calo-lategan/Staircase/v2/revc/review/consistency.md

# Rev C web set: consistency and fact-check audit

Read-only audit, 26 Sep 2026. No page or script was changed.

Pages checked: `v2/revc/web/{datasheet,verdict,changelist,manufacturing}.html`. The HTML was stripped to text with python, and SVG `aria-label`s, `alt` text and `href`s were checked separately.
Sources checked against: `v2/final/final_results.json` (and `pole_options_final.json`, `frame_sls_final.json`, `barrier_path_check.json`, `tread_box2.json`, `tread_grating.json`), `v2/revc/after_changes.json` (+ `after_changes.py`), `frame_after.json` (+ `.py`), `pole_fixing.json` (+ `.py`), the `build_*_revc.py` scripts, and `v2/spec/sheet_2026-09-23_events.txt`.

**R-number convention.** Every R-number on the pages is *file line − 1* of `sheet_2026-09-23_events.txt`. For example, R7 is line 8, "Gap between steps (open riser)", and R113 is line 114, "Area load 5.0–7.5 kN/m²". I checked all 30 R-numbers used on the pages. Each one points at a row about the stated topic. A few are loose fits, listed below. None is outright wrong.

Severity: **critical** means Gerald would draw something wrong or unsafe. **Major** means a contradiction, or text he cannot draw from. **Minor** means a rounding, wording or traceability problem.

---

## A. Critical

| # | Page + quote | Problem | Evidence | Suggested exact replacement text |
|---|---|---|---|---|
| A1 | changelist F5: "One tube from support to support … a 48.3 × 4 aluminium scaffold tube"; verdict: "Top landing bracket … no change 0.38"; manufacturing: "Top landing brackets, top rails and handrails are unchanged in both routes." | The axle grows from Ø25 to Ø48.3 at both ends, but no page says the hook bore, the jack heads or the top landing brackets must change to take the bigger tube. As written, the 48.3 tube cannot fit hooks or brackets drawn for Ø25. | datasheet components: "Axles 3 · Tube Ø25 × 2.5"; "Top landing brackets 137/140 × 5 plates, Ø20 pin"; `after_changes.py` checks the top axle as 48.3 × 4 on a 70 mm lever | F5 "Change to", add: "Open every hook to suit the Ø48.3 tube (bore Ø49–50) and keep the ring width below. Redraw the top landing brackets and jack heads to seat a Ø48.3 tube." In verdict/manufacturing, replace "no change"/"unchanged" for the landing bracket with "re-seated for the Ø48.3 axle (pin Ø20 and 5 mm plate unchanged)". |
| A2 | changelist F5: "Base hook plates with at least 39 mm of plate round the axle (57.5 if the jacks will be clamped to a scaffold)"; "Jacks on the ground: M24 jacks and the drawn footplates are fine." | "Already decided" says "Jacks stand on the ground or on a scaffold", so the unit must meet the clamped case. The conditional sizes leave Gerald to choose, and one branch keeps 100 × 100 × 5 footplates, which fail R73 (150 × 150 minimum). The top-hook ring for the clamped case (40 mm) is missing from F5 altogether. | datasheet R73 row "100 × 100 × 5 … Fail"; verdict R73 "150 × 150 × 8 … 0.89"; `final_results.sizes.hooks` "≥ 57.5 mm at the base, ≥ 40.0 mm at the top" | "Base hook plates with at least 57.5 mm of plate round the axle; top hook plates at least 40 mm. Base jacks M30 on 150 × 150 × 8 footplates, with a fixing for 10.9 kN sideways." Delete "Jacks on the ground: M24 jacks and the drawn footplates are fine." |
| A3 | changelist F8: "Bent flats 15 wide, about 5 thick … 25 wide at the same thickness (0.90)" | The thickness is given three ways: "about 5" (F8), "≈ 4.5" (datasheet components), and "the thinner 4.2 mm measured gives about 3.0" (datasheet). At 4.2 mm the 25-wide bracket comes out ≈ 1.28, a fail. "Same thickness" is therefore unsafe wording. | `final_results.components` "bracket thickness 5 mm assumed"; 0.90 × (5/4.2)² = 1.28 | "Change to: 25 × 5 flat (5 mm thick minimum, not the 4.2 mm now measured), same 57 mm offset and fixing points (0.90)." |
| A4 | changelist F4 / manufacturing Poles: pole "stands on the outside face of the rails" … "Its locking tab and pegs (F3) stay part of the same piece"; F3: "locking end, which drops through both rails … pegs … in the rail walls" | Once the pole is outside the rails, the text never says how the locking tab reaches both rails or where the rail-wall notches are. Gerald cannot draw F3 and F4 together. Route 2 drops F3 because "the F4 fixings do the locking", which suggests F3 may be redundant in Route 1 too. | changelist F3/F4 text; `pole_fixing.py` ("cross-pin … carries the rail-to-rail lock force") | Decide, then state it. If the strap, Ø12 cross-pin and Ø16 pin carry the lock force (per `pole_fixing.json`: 0.18 / 0.65), write: "F3 is replaced by the F4 fixings in both routes: no locking tab or pegs." Otherwise, add a dimensioned sketch of the tab path from the outside face through both rails. |

## B. Major

| # | Page + quote | Problem | Evidence | Suggested exact replacement text |
|---|---|---|---|---|
| B1 | All pages: "about 70 deep"; changelist SVG aria-label: "rail deepened to about 65 mm" | The net-section, edge and lateral rail checks and the rail mass were all computed at **65** deep. Only the frame SLS/frequency run used 70. The change list says "Sizes are final unless marked decide" but gives only "about 70". | `after_changes.py` "rails 65 deep"; `barrier_path_check` "U 35 x 65 x 5 (F2)" → 0.51/0.82; `rails_kg` uses 60 legs + 5 web; `frame_after.py` DEPTH = 70; `final_results.sizes` "needs the 65 mm rails" | Everywhere: "70 deep (outside), 5 mm walls". Add to the verdict note: "Rail strength was checked at 65 deep and sag at 70; 70 is drawn." Fix the aria-label to "about 70 mm". |
| B2 | changelist F2: "Ø20 pins and Ø20 holes"; manufacturing: "reamed to Ø20 H9", "About 0.5 mm clearance per side on pins"; F9: "about 0.5 mm per side on pins and slots" | The hole size contradicts itself: Ø20, Ø20 H9 (a near-zero fit) and Ø21 (0.5 mm per side). The edge check used d0 = 21. | `after_changes.py` edge formula `2*21/3` | F2: "Ø20 pins in Ø21 holes (0.5 mm clearance per side)". Manufacturing: "drilled and reamed to Ø21". |
| B3 | changelist legend: "needed to pass (F1–F5) · smaller or a decision (F6, F8, F9)"; F8 card has no "needed to pass" tag | The brackets fail R143 at 2.51 as drawn, so F8 is needed to pass. | datasheet "Handrail brackets … 2.51 Fail"; verdict R143 "2.51 → 0.90" | "needed to pass (F1–F5, F8) · decision or drawing only (F6, F9)". F8 subtitle: "12 per unit · needed to pass". |
| B4 | changelist: "If the lower-cost build route is chosen … only three cards change"; manufacturing: "tell Gerald: only cards F1, F3 and F4 … change" | Not accurate. Route 2 also changes F2 hardware (stainless Ø20 bar with R-clips, not turned with castle nut and split pin), F5 jacks (M24 on the ground only, not M30) and F5 collars (scaffold clamps). | manufacturing rows Step pins, Base jacks, Axles and collars | "If Route 2 is chosen, F1, F3 and F4 change, plus the F2 pin ends (R-clips) and the F5 collars (scaffold clamps)." |
| B5 | changelist "Already decided": "Poles solid; they are the crowd barrier." · manufacturing Route 2: "rectangular tube 80 × 40 × 3" · datasheet: "A hollow 25 × 85 × 3 does the same job at less than half the mass" | Three pole answers. "Solid" is listed as decided while Route 2 (still open) uses hollow tube. The datasheet recommends a 25 × 85 × 3 RHS that appears nowhere else, and it omits Route 2's 80 × 40 × 3. | pole options table; `after_changes.poles.R2_rhs_80x40x3` 0.76 | Decided list: "Poles are the crowd barrier: solid 25 × 55 (Route 1) or RHS 80 × 40 × 3 (Route 2)." Datasheet: replace the "25 × 85 × 3" sentence and table row with "RHS 80 × 40 × 3 (Route 2): 0.76, 25 kg for 12." |
| B6 | datasheet "Smallest sizes that pass": no handrail-bracket row | The datasheet's list of changes that make it pass omits F8. | changelist F8; verdict R143 | Add row: "Handrail brackets · Bent flat 15 × ≈ 4.5 · 25 × 5 flat, same offset (0.90) · R143" |
| B7 | datasheet: "A solid bar only passes at … 25 × 51 for every barrier load" vs "Smallest that passes: Solid 25 × 55 (0.84)" | The "smallest that passes" is not the smallest (25 × 51 is 0.98). The reason for 55 (margin, or the fixings) is not given. | pole options table 25 × 51 = 0.58/0.80/0.96/0.98 | "Solid 25 × 55 (0.84; 25 × 51 is the bare minimum at 0.98 and is not used)" |
| B8 | changelist F5: "Draw the landing bracket's bolts for 11.3 kN per side"; manufacturing: "The landing fixing (11.3 kN per side) is by others"; datasheet: "It's outside this model" | The pages disagree on whether Gerald draws the landing fixing, and no bolt size is given. | — | Either "Landing fixing: by others, design load 11.3 kN per side (ULS); not drawn" in all pages, or give the bolt spec in F5. |
| B9 | changelist F5: "A collar on the axle each side of every hook"; "a Ø14 pin through the base hook plate under the axle" | Collar size/type, the hook-lock pin position (distance from the axle centre, direction) and the pin length are not given. | — | "Collars: split collar for Ø48.3, 20 wide, 1 × M8. Keeper pin Ø14 through both hook cheeks, centre 32 mm below the axle centre, on the open side." (Numbers to be confirmed by the engineer.) |
| B10 | changelist F4: "tapering to 15 at the top rail"; "5 × 40 strap round the pole, bolted to the rail with 2 × M12, plus a Ø12 cross-pin … at the middle of its 55 depth"; SVG: "pole on the outside face, 2 bolts into each rail" | Missing for drawing: where the taper starts, the pole length, the bolt positions/spacing, the strap bend shape and which parts the cross-pin passes through (the script says both strap legs). The SVG says 2 bolts at *each* rail, but the text says one Ø16 pin at the lower rail. | `pole_fixing.py` comments | Text: "full 55 from the lower rail up to the upper-rail strap, then straight taper to 15 at the top rail". SVG label: "strap + 2 × M12 at the upper rail; one Ø16 pin at the lower rail". |
| B11 | changelist F4: "The middle handrail between two units side by side isn't a barrier … and can stay as it is." | Introduces a side-by-side layout not defined anywhere else. It is unclear whether the 6 poles on that side keep the hollow 25 × 10, which conflicts with "12 per unit". | — | Delete it, or: "All 12 poles change. (Where two units stand side by side, the shared handrail is not a barrier, but the poles still carry the fold lock and must change.)" |
| B12 | changelist F6: "raise the top rail about 87 mm (raise the pole tops or pivot posts)"; "The handrail passes either way (900–1,000)" | (a) +87 mm lengthens the barrier lever from 1,050 to about 1,137 mm. Pole, strap, pin and rail utilisations (0.84/0.17/0.65/0.82) were not re-run for this, though ≈ +8% would still pass. (b) The 900–1,000 range comes from the **ramp** row (sheet line 47, R46), not a stair row. From the step surface the handrail is ≈ 1,002 mm, just above 1,000, so "passes either way" is not supported. | sheet line 47 "Ramp (Pod) … Handrails … 900 mm/1000 mm"; 1,112 − 1,013 = 99 mm offset | (a) Add: "If raised, the pole checks rise about 8% (pole 0.91): still pass." (b) Replace with: "The handrail is 903 above the pitch line; the sheet has no stair-handrail height row (900–1,000 is the ramp row R46)." |
| B13 | changelist F9: "Afterwards: 12 poles, 12 locking ends, 4 hooks, 2 axles." | "12 locking ends" contradicts F3 ("Draw each pole and its locking end as a single part"). "2 axles" implies deleting the unloaded second base axle (x 9,936), which F9 never says to do. | datasheet components "Axles 3"; "second base axle at x 9,936 carries no load" | "Afterwards: 12 poles (each one piece with its locking end), 4 hooks, 2 axles (delete the unused second base axle at x 9,936)." |
| B14 | changelist F2: "Right rails grow downwards; the left channels deepen by the same amount" | Rails start at 25 or 20 deep, so reaching 70 needs different amounts (45/50). The growth direction for the left channels is not stated, and neither is left/right (looking up the stair?). | datasheet components: left U 35 × 25, right lower 25 × 25, right upper 25 × 20 | "All four rails become 70 deep outside. Right rails (inverted U) grow downwards; left rails (U, open at the top) grow downwards. Left/right as seen walking up the stair." |
| B15 | changelist F3: "rail-wall notches widened" and "holes in the rail walls" (same card); datasheet: "J-notches in the rail walls" | Notch or hole matters for drawing, because it decides whether the pole drops in or has to be threaded. | — | Use one term: "J-notches in the rail walls, widened to Ø12 + 1 mm". |
| B16 | datasheet: "Step design · … both with drain holes, FE-verified" | The box A FE (`tread_box2` B4) has no holes: its cfg has no hole data, and the 5.9 kg mass is solid plate. The C grating FE (G5) has no cross bars, so its 6.2 kg excludes ≈ 1.4 kg of 3 × 25 cross bars at 50 mm. The hole rule in F1 ("up to about a fifth of each plate") is unchecked. | `tread_box2.json` cfg; `tread_grating.json` G5 bars list | "FE on the closed box without holes; holes up to 1/5 of each plate are an engineering allowance, to be confirmed. C mass excludes cross bars (+≈ 1.4 kg)." |
| B17 | datasheet row: "Tread pins Ø10 … Shear 11.2 kN / 11.1 kN · 1.00 · 0.78 · **Pass**" | The source says FAIL (11,155 N > 11,121 N, util 1.003). | `final_results.components` "Tread pins O10 … Shear … 1.0 FAIL" | "… 1.00 (1.003) · 0.78 · Fail" |
| B18 | changelist "Already decided": "Hooks cut or bent as part of the rails"; manufacturing: "Hooks cut from the same channel or bolted on as 10 mm plate"; hooks "10 mm plate" everywhere | The rails have 5 mm walls, so a hook "part of the rail" cannot be the 10 mm plate that was checked. Manufacturing also offers "bolted on", which contradicts the decision. | datasheet "Hooks | 4 | 10 mm plate" | "Hooks: 10 mm 6082-T6 plate, bolted to the rail (2 × M12)" (or state the thickness if cut from the channel, and re-check). |
| B19 | manufacturing rule: "6082-T6 for everything structural … The only exception is the Route 2 step (5083-H111)" | The same page specifies stainless step pins (Route 2), "6082-T6 or stainless" pegs, M12 A4-70 bolts and scaffold clamps and jacks (usually steel). | manufacturing rows | "6082-T6 for rails, poles, axles, hooks and brackets. Pins and bolts may be A4 stainless (isolated, see below). Jacks and clamps: standard scaffold items." |
| B20 | changelist decided: "No middle rail, toe board or feet; the scaffold supports the unit." vs "Jacks stand on the ground or on a scaffold." | These contradict each other on what supports the unit. | — | "No middle rail or toe board. The base stands on two screw jacks, on the ground or clamped to a scaffold." |
| B21 | changelist F1/verdict R7: "a 35 mm lip gives the recommended 100" | The arithmetic does not match: 125 − 35 = 90, and 125 − 25 = 100. The datasheet also places the 125 gap "under the back box", while the lip is on the front edge. | datasheet R7 row "125 mm under the back box" | Verify, then: "a lip at least 5 mm down gives 120; 25 mm gives the recommended 100." State which edge the gap is measured under. |
| B22 | changelist F1 and SketchUp notes | R16/R17 are not in the change list. The 55 mm-wide contrasting nosing strip (R17: "55 mm … full width, both edges") and serration on box A are never given to Gerald. The verdict says "Specify". | sheet R17 | F1 add: "Top plate serrated. 55 mm contrasting strip along the full width of the front edge (R16, R17)." |

## C. Minor (rounding, wording, traceability)

| # | Page + quote | Problem | Evidence | Suggested replacement |
|---|---|---|---|---|
| C1 | verdict R115: "Sag under 4 kN ≤ 12.2 mm · 58.3 mm · **4.78**" | Datasheet and JSON give 4.80 (58.34/12.16 = 4.798). | `tread.checks` 4.798 | "4.80" |
| C2 | datasheet tread table: "Grating bar stress · 212 / 224 MPa · 0.94 Pass"; chart: "Grating bars 0.99" | The table util belongs to 212; the peak (224/227) is 0.99. | `tread.checks` 0.988 | "212 / 224 MPa · 0.99 · Pass" |
| C3 | datasheet pole options: "18.57 · 25.39 · 30.41 · 31.02" (RHS), "15.21 … 24.90 25.40", "2.43 … 3.98", "6.76 … 11.07 11.29", "25 × 51 · 0.58" | These differ from the barrier table on the same page (18.60/30.47/30.99) and from `pole_options` (18.6/25.4/30.48/31.01; 15.23/24.95/25.38; 2.44/3.99; 6.77/11.09/11.28) and `barrier_path` (25 × 51 0.59). They are recomputed in `build_datasheet_final.py`. | `final_results.pole_options`, `barrier_path_check.json` | Use the JSON values: 18.60/25.39/30.47/30.99 etc. |
| C4 | verdict R179: "solid 25 × 55 (worst barrier load) 0.84"; R142 3.0 kN/m: "covered by the row above 0.84"; "Closest to the limit … 3.0 kN/m on the top rail 0.84" | 0.84 is the 5.0 kN/m viewing value. For 25 × 55 the R179 value is 0.82 and 3.0 kN/m is 0.50. | `barrier_path.pole["solid 25 x 55"]` | R179 "0.82"; R142 3.0 "0.50"; add row "R142 5.0 kN/m viewing · 0.84". |
| C5 | verdict "R142 Pole fixing, upper rail · strap + 2 × M12 · **0.17**"; manufacturing Route 1 "**0.18**" | Same fixing, two values. 0.17 is bolt tension; 0.18 is the cross-pin double shear (0.184). | `pole_fixing.json` | Both: "0.18 (cross-pin; bolts 0.17)". |
| C6 | verdict R113 steps: "box step, 0.41 of its strength · 0.41" | 0.41 is the box under the 4 kN point load, not the crowd. | `after_changes.steps.A_extruded_6082` (ULS max = 4 kN case) | "box step (governed by 4 kN: 0.41)". |
| C7 | datasheet: "The crowd load carried (≈ 1.1 kN/m²) is set by the pegs" | The rails (6.95, base free) govern, not the pegs (6.62). 7.5/6.95 = 1.08. | datasheet frame table | "… is set by the rails and pegs (6.95 / 6.62)". |
| C8 | datasheet: Ground friction "… 0 · **0.80** · Partly holds" in a utilisation column | 0.80 is the friction coefficient needed; the utilisation is 1.55. | `components` "Base held by friction alone … 0.8 · 0.5 · util 1.55" | "μ needed 0.80 vs ≈ 0.5 (1.55)". |
| C9 | changelist F4: "Under the barrier loads they are 19–30× too weak" | Range is 18.6–31.0. | components | "19–31×" |
| C10 | verdict "Sag under a crowd ≤ 4.9 mm" / datasheet "4.86 mm" | Rounding differs between pages. | — | "≤ 4.86 mm" on both. |
| C11 | changelist F3 SVG: "NOW · 2 mm pegs 2 per rail, 4 per pole" vs summary "2 mm, lower rail only" | The "now" state disagrees. | datasheet "upper pair is missing from the drawing" | SVG: "NOW · 2 mm pegs, lower rail only (upper pair not drawn)". |
| C12 | verdict R174 "Jacks on the ground · M24 · 0.08 → M24 · 0.82" | Reads as the change making things worse. The two numbers are different cases (free vs friction-held). | components vs `after_changes.jacks.m24_ground` | "M24 · 0.08 (base free) / 0.82 (friction-held) → no change". |
| C13 | datasheet/verdict/changelist: "Aug-2026 events sheet" | The source file is `sheet_2026-09-23_events.txt`; "Aug-2026" is only the legend's re-evaluation date. | sheet line 2 | "events sheet (23 Sep 2026)". |
| C14 | R-refs: R150 for hook-plate throat; R147 for axle bending; R174 for jack-rod bending/friction | Loose fits. R150 is "Uplift / anchorage (wind)", R147 is "Column axial load", R174 is "Ground bearing pressure". The ground pressure itself (0.64–3.49 MPa) is never compared with an allowable. | sheet lines 148, 151, 175 | Use "R147 (supports, project statics)" for the hooks too, and add "ground pressure 3.5 MPa peak (R174: check bearing)". |
| C15 | changelist F5 "Sheet rows R147 R150 R73" | R174 (jacks) is missing. | — | "R147 R150 R73 R174" |
| C16 | datasheet / verdict geometry tables | These sheet rows are not addressed: R66 toe board 150 mm, R70 second rail at ~600 mm for public crowds, R19 handrail extension ≥ 300 mm. Only R65/R68 are shown as "by decision". | sheet lines 67, 71, 20 | Add them to the "By others / by decision" row: "R65 R66 R68 R70". |
| C17 | datasheet "Ring ≥ 39 mm at the base on the ground" (also changelist F5) | No JSON source: `sizes.hooks` gives only 57.5/40. The 39 is hard-coded in `build_datasheet_final.py:516`. | — | Cite its source or drop it (see A2). |
| C18 | datasheet "Pure aluminium … would need about 25 × 86"; verdict/manufacturing "the scaffold edge protection covers it" | No source in the JSON. | — | Remove, or cite. |
| C19 | datasheet footer cites `tread_fe_box.py` | The box result used is `tread_box2` (tread_box2.py). `final_results` marks the old box check `tread_box_check_superseded`. | `final_results` keys | "… tread_box2.py (closed box B4) …" |
| C20 | datasheet mass list "Grating bars 360×19.68", "Tread frames 6×16.25" | Reads as 360 × 19.68 kg. The value is the total. | `mass.parts` | "Grating bars (360): 19.68 kg" |
| C21 | Terminology | One part has five names: pole "locking end / locking tab / lock pins / latch"; pegs "cross-pegs / pegs / keeper pins". Steps are "tread" on the datasheet and "step" elsewhere. | — | Use "pole locking end", "pegs", "step" throughout. |

## D. Leftover history / superseded material

| Sev | Page + quote | Problem | Suggested replacement |
|---|---|---|---|
| major | datasheet "Step design · **A** chosen, **C** the alternative"; changelist "A · CHOSEN", "C · ALTERNATIVE" | Letters A/C imply a missing option B (the owner's box B, still in `after_changes.steps.B_owner_*`). This will confuse Gerald. | "Step type 1 (closed box, draw this)" / "Step type 2 (open grating, alternative)". |
| minor | datasheet "Open shapes 25 mm deep don't pass: a cut-out top sheet on the J + L, or a lattice …"; changelist F1 "even as a fine lattice" | Rejected options have no role in a drawing brief. | Keep on the datasheet only as a single line, or delete. |
| minor | datasheet pole-options table (8 rows incl. 25 × 39, 25 × 60 × 3, 25 × 85 × 3) and "Pure aluminium" paragraph | Rejected options are listed next to the chosen one (see B5). | Reduce to: as drawn, Route 1 (25 × 55), Route 2 (80 × 40 × 3). |
| minor | datasheet "checked joined to them, as confirmed", "(confirmed)", "as decided", "the owner confirms 4 pegs" | Decision-history wording. | Plain statements: "The flats are joined to the end plates." |
| minor | verdict "The catwalk and steep states were not re-checked in Rev C." | Mentions configurations Gerald is not drawing. | Keep, but add "(not part of this change list)". |
| — | Checked, **none found** on any page: Rev A/B, 22 Sep model, "earlier", "correction", steel posts, 107 kg, 69.4 kg, SHS 60 × 60, 6 posts, intermediate rails, step option B by name. | Only the one stale "about 65 mm" aria-label (B1). The builders' source (`datasheet/build_datasheet_final.py`) still contains "Rev A (22 Sep)" and "22 Sep model" strings. `build_datasheet_revc.py` removes them by string-replace, so a future edit could let them back in. | — |

## E. Terms Gerald cannot resolve from the text

These are the undefined or inconsistent terms, and where each one is used.

- **pitch line**: defined only in changelist F6. It is undefined on the datasheet and verdict.
- **net W**: datasheet rails. Not defined.
- **HAZ / f₀,haz**: datasheet material box. Not defined.
- **util / Use**: defined on the verdict and manufacturing guide. The datasheet uses "utilisation (demand ÷ resistance)". Acceptable.
- **ULS / SLS**: undefined on the datasheet.
- **T8.8**: datasheet; means EN 1999-1-1 Table 8.8. Cryptic.
- **J-notch**: undefined.
- **pivot posts**: F6. Undefined.
- **back box**: datasheet. Undefined.
- **left/right**: never defined (e.g. "facing up the stair").
- **x/y/z axes**: defined only for the tread.

## F. Links

- `links.json` does not exist in `v2/revc/`, so every cross-page link is the placeholder `#`. There are 19 in total:
  - datasheet: 4 ("change list" in Smallest sizes; footer: load verdict, change list, manufacturing guide)
  - verdict: 5 (hero: change list, manufacturing guide; footer: datasheet, change list, manufacturing guide)
  - changelist: 5 (decided box and Route-2 note: manufacturing guide ×2; footer: datasheet, load verdict, manufacturing guide)
  - manufacturing: 5 (intro: load verdict, change list; footer: datasheet, load verdict, change list)
- **Broken in-page anchor:** changelist summary row F7 links `#f7`, but there is no `id="f7"` card. F7 exists only as a note at the bottom. Either add `id="f7"` to that note or drop the link.
- The in-page anchors `#f1`–`#f6`, `#f8` and `#f9` resolve.
- All 28 `img/` references exist. `img/f9_where.jpg` exists but is not used.

## G. Cross-checks that agree (for the record)

These values match their JSON sources to the stated rounding:

- **Mass:** 61.2 / 88 / 98 kg.
- **Now-state utilisations:** pegs 6.62/4.93, rails 4.88/2.89/4.96/6.95 (free) and 2.72/2.06/2.99/5.16 (held), tread pins 5.30/4.14, axle 2.19/6.04, top axle 1.51/3.85, hook throat 1.22/3.37 and 0.84/2.15, jack 1.71, footplate 2.66, brackets 2.51.
- **Reactions:** 6.4/17.7/11.3/4.4/3.2/10.9 kN.
- **Frame sag and frequency:** frame sag 10.7 vs 7.32 mm; f₁ 9.2–14.8 Hz.
- **After-change utilisations:** pegs 0.58, pins 0.66/0.25, edge 0.87, rails net 0.40 (W 7,200 vs 2,900), lateral 0.51/0.82, pole 0.84 (Route 2 0.76), pole masses 35/25 kg, hole-at-upper-rail 2.6, cross-pin section loss 1%, lower pin 0.65, axle 0.60/0.96, top 0.61, keeper pins 0.81/0.71, jacks 0.82/0.88, footplate 0.89, brackets 0.90.
- **After-change sag and frequency:** frame 0.9 mm (0.12); ≈ 22 Hz (frame 31.5, step 29.5, Dunkerley 21.54 → "22").
- **Steps:** A 0.41/0.82, 3.6/1.1/1.2 mm, 5.9 kg; C 0.81, 9.2/3.0 mm, 6.2 kg (excluding cross bars, see B16).
- **Geometry:** +87 mm (1,100 − 1,013); 305 mm pole spacing (250 / cos 35°); 2R + G = 600; 18 duplicate pairs.
