calo-lategan/Staircase/v2/audit/png/atlas/fam00_MainRig_020_Y.png

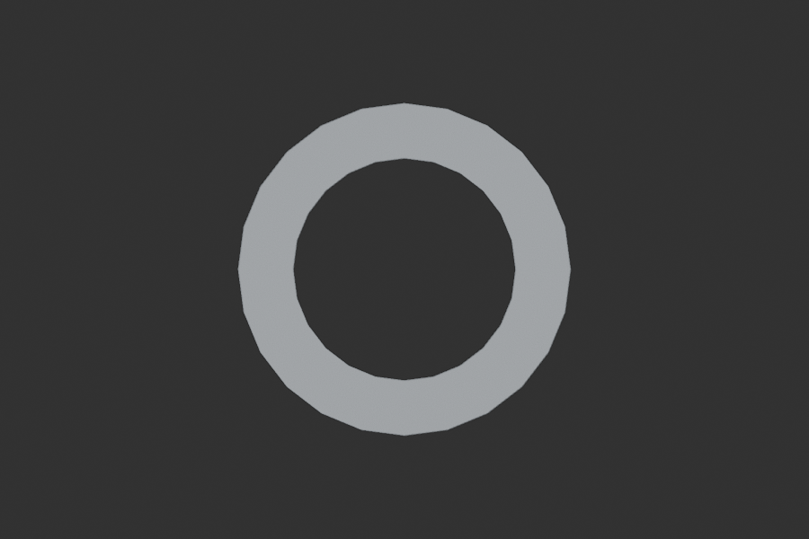
v2/audit/png/atlas/fam00_MainRig_020_Y.png
