calo-lategan/Staircase/v2/audit/png/atlas/fam01_HRS_A_015_Z.png

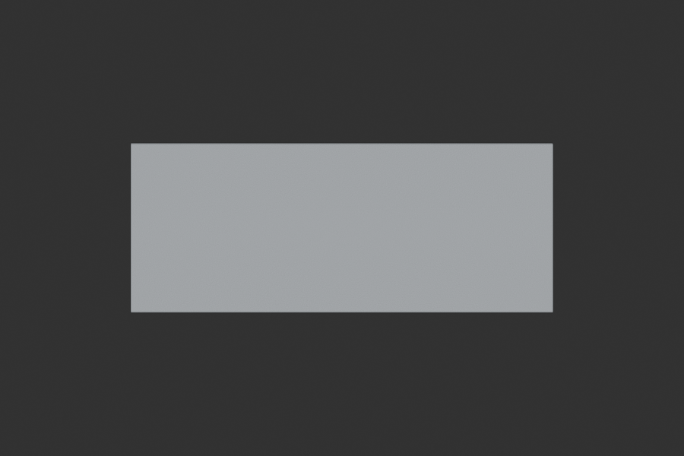
v2/audit/png/atlas/fam01_HRS_A_015_Z.png
