calo-lategan/Staircase/v2/audit/png/atlas/fam03_MainRig_023_Z.png

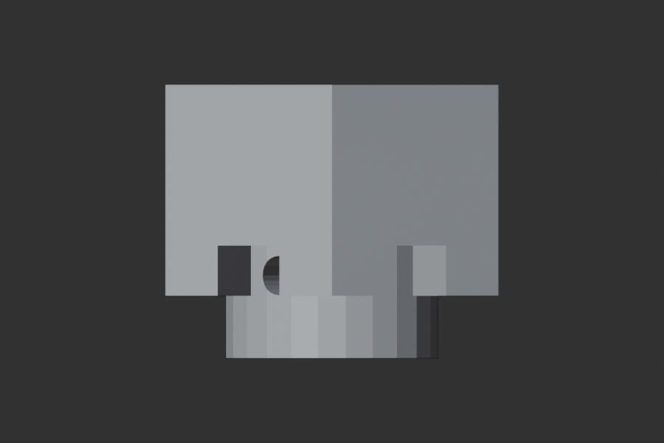
v2/audit/png/atlas/fam03_MainRig_023_Z.png
