calo-lategan/Staircase/v2/audit/png/atlas/fam07_HRS_A_041_Y.png

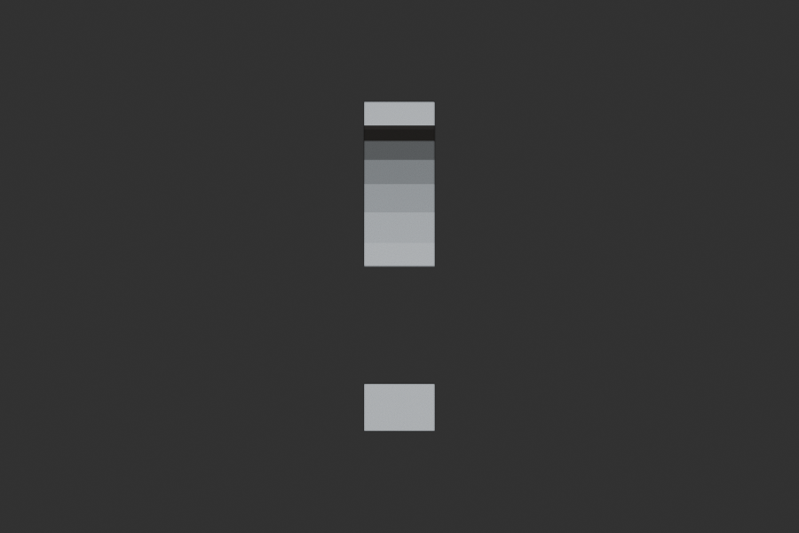
v2/audit/png/atlas/fam07_HRS_A_041_Y.png
