calo-lategan/Staircase/v2/audit/png/atlas/fam14_MainRig_019_X.png

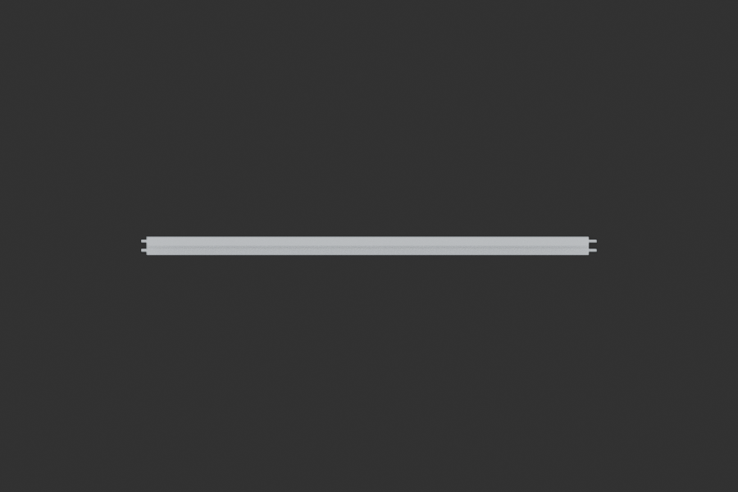
v2/audit/png/atlas/fam14_MainRig_019_X.png
