calo-lategan/Staircase/v2/audit/png/atlas/fam17_MainRig_007_Z.png

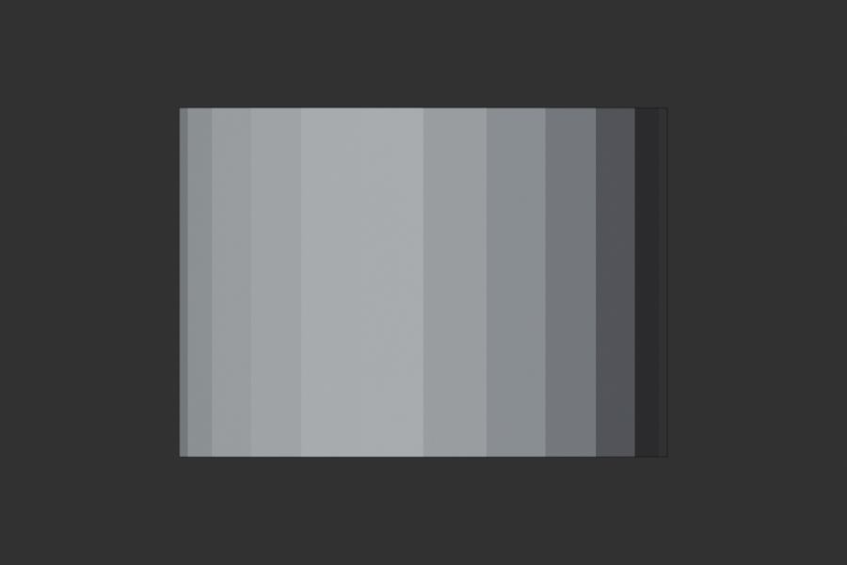
v2/audit/png/atlas/fam17_MainRig_007_Z.png
