calo-lategan/Staircase/v2/audit/png/atlas/fam21_HRS_A_040_Y.png

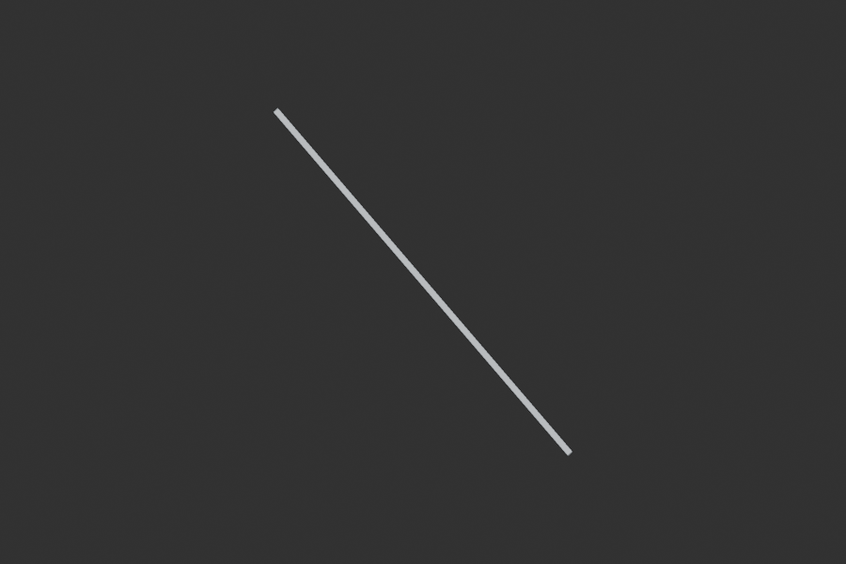
v2/audit/png/atlas/fam21_HRS_A_040_Y.png
