calo-lategan/Staircase/v2/audit/png/atlas/fam25_HRS_A_042_X.png

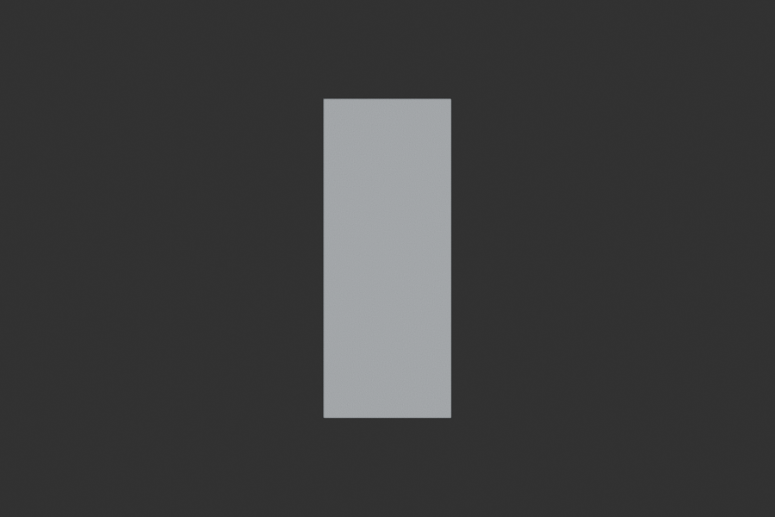
v2/audit/png/atlas/fam25_HRS_A_042_X.png
