calo-lategan/Staircase/v2/audit/png/atlas/fam25_HRS_A_042_Y.png

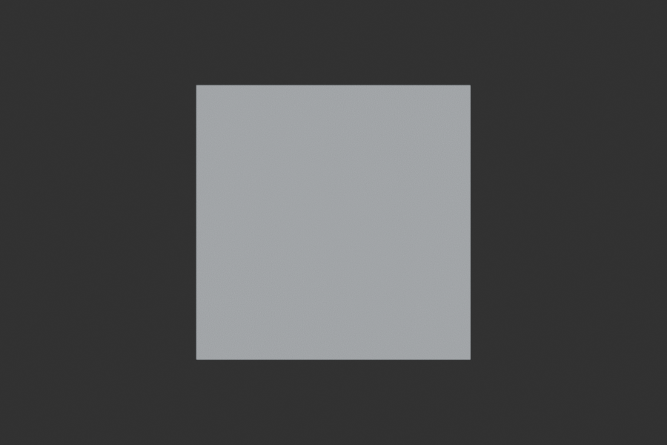
v2/audit/png/atlas/fam25_HRS_A_042_Y.png
