calo-lategan/Staircase/v2/audit/png/atlas/fam31_MainRig_125_Y.png

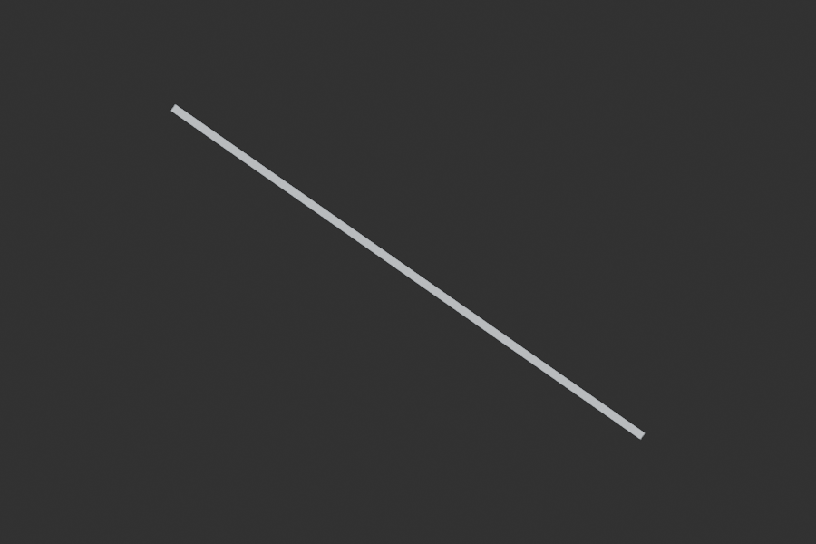
v2/audit/png/atlas/fam31_MainRig_125_Y.png
