calo-lategan/Staircase/v2/audit/png/atlas/fam36_HRC_A_031_Z.png

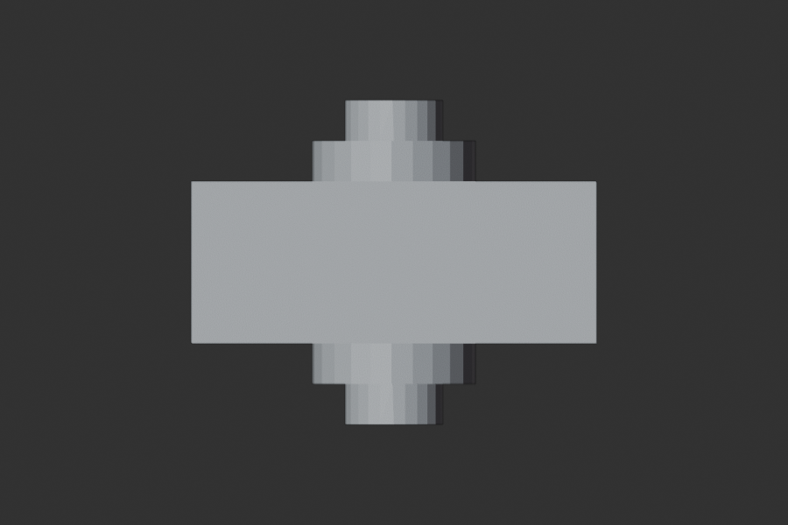
v2/audit/png/atlas/fam36_HRC_A_031_Z.png
