calo-lategan/Staircase/v2/audit/png/atlas/fam41_HRC_A_015_X.png

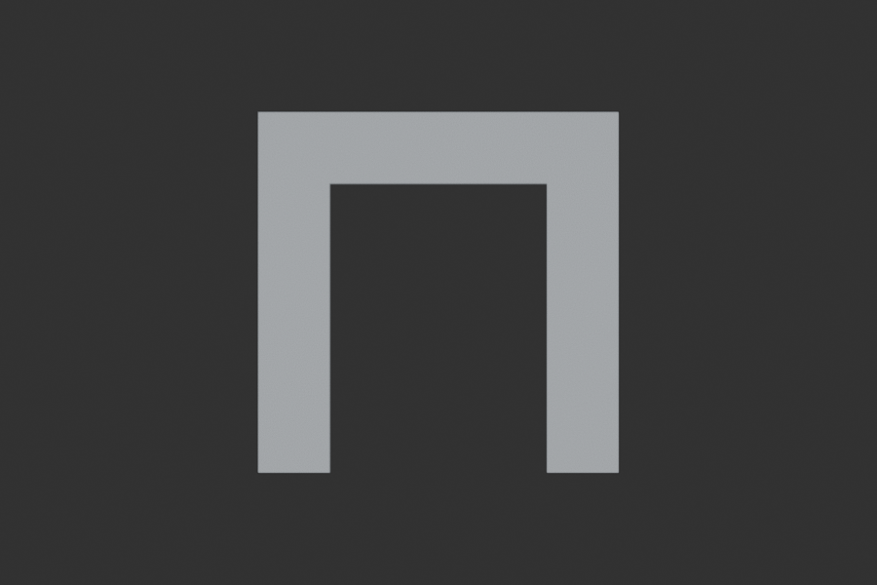
v2/audit/png/atlas/fam41_HRC_A_015_X.png
