calo-lategan/Staircase/v2/audit/png/atlas/fam76_HRC_A_049_X.png

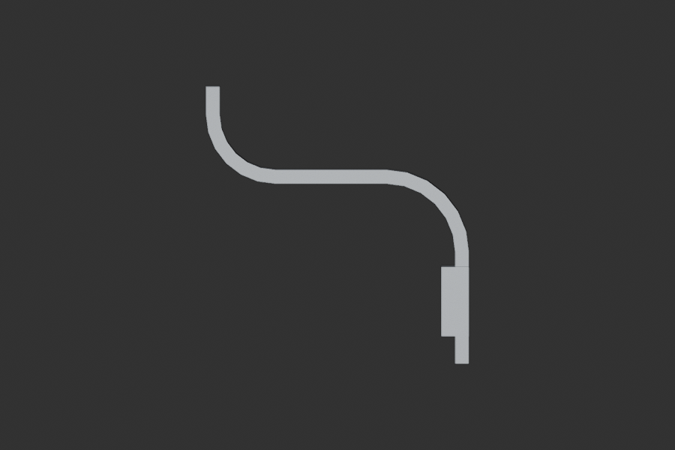
v2/audit/png/atlas/fam76_HRC_A_049_X.png
