calo-lategan/Staircase/v2/audit/png/atlas/fam84_HRC_A_041_X.png

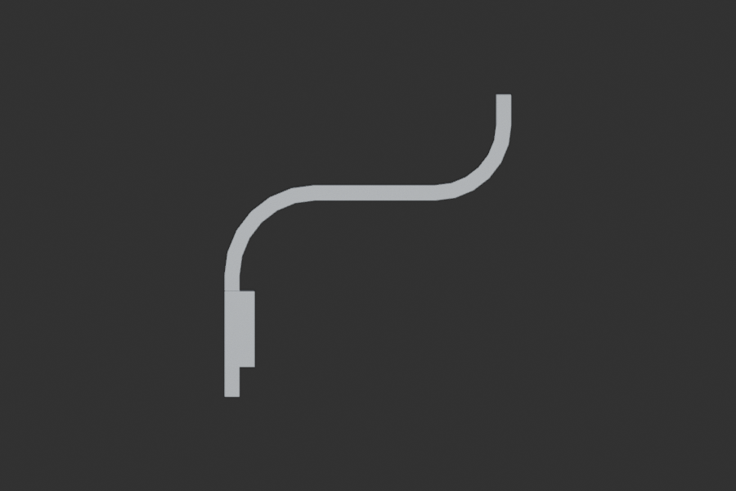
v2/audit/png/atlas/fam84_HRC_A_041_X.png
