calo-lategan/Staircase/v2/audit/png/atlas_sheet_02.png

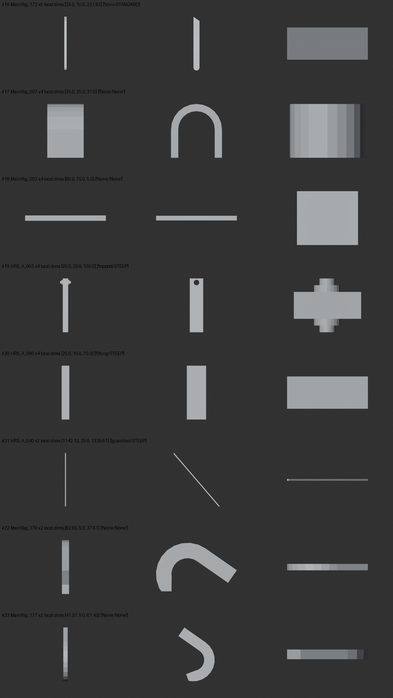
v2/audit/png/atlas_sheet_02.png
