calo-lategan/Staircase/v2/audit/png/atlas_sheet_03.png

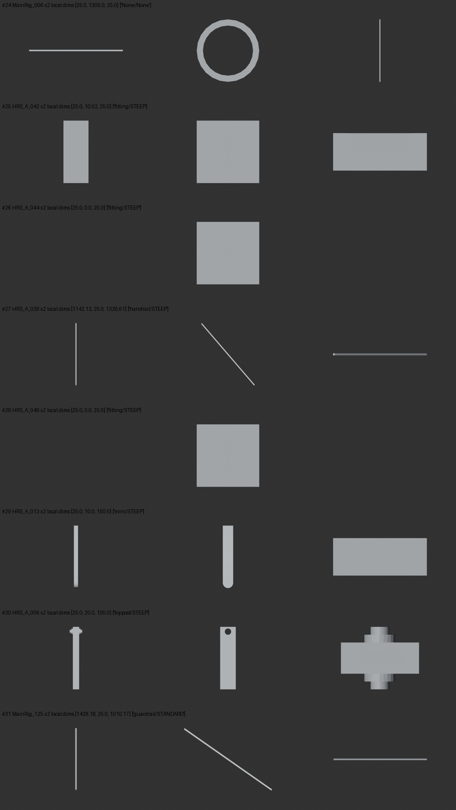
v2/audit/png/atlas_sheet_03.png
