calo-lategan/Staircase/v2/audit/png/atlas_sheet_04.png

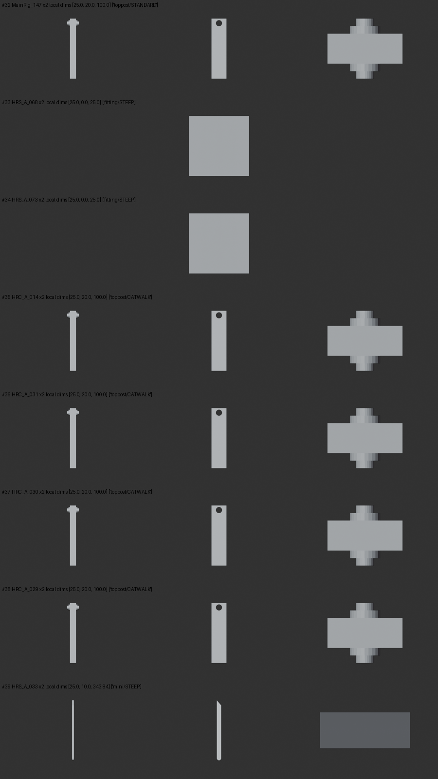
v2/audit/png/atlas_sheet_04.png
