calo-lategan/Staircase/v2/audit/png/j_t0L_from_top.png

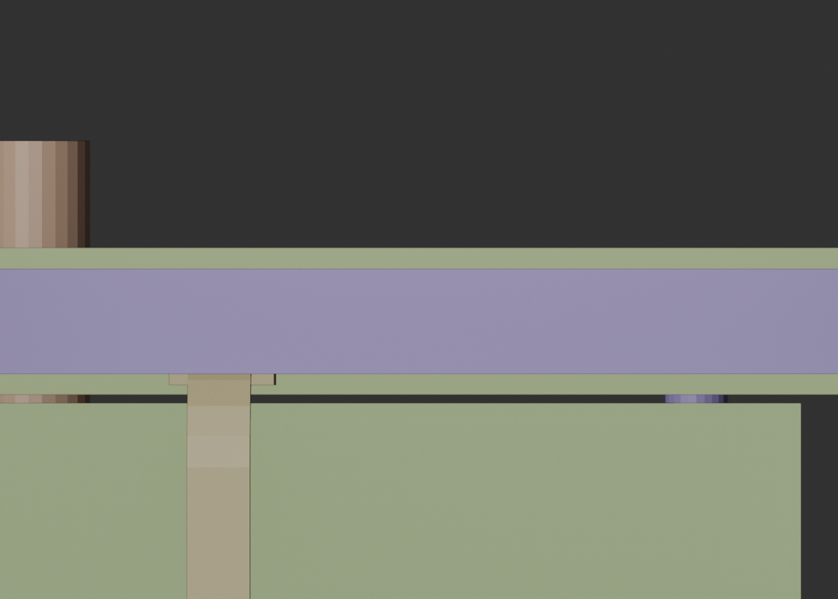
v2/audit/png/j_t0L_from_top.png
