calo-lategan/Staircase/v2/audit/png/j_t0R_from_back.png

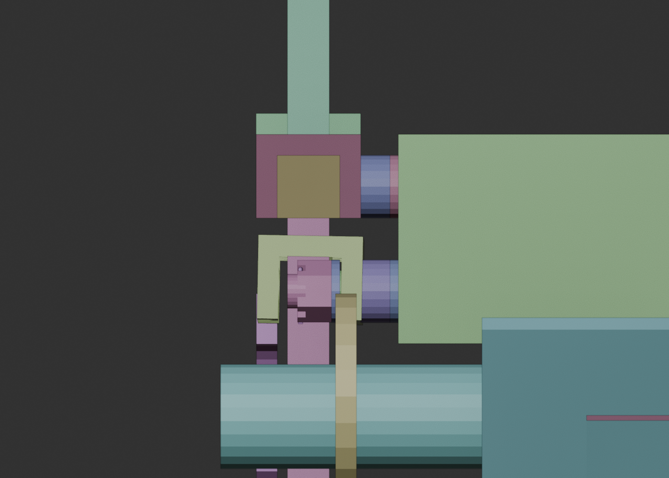
v2/audit/png/j_t0R_from_back.png
