calo-lategan/Staircase/v2/audit/png/j_t0R_from_in.png

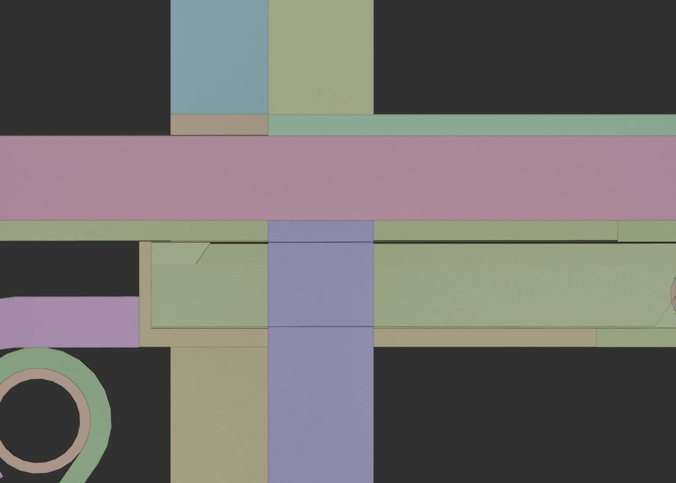
v2/audit/png/j_t0R_from_in.png
