calo-lategan/Staircase/v2/audit/png/j_t0Rfront_from_in.png

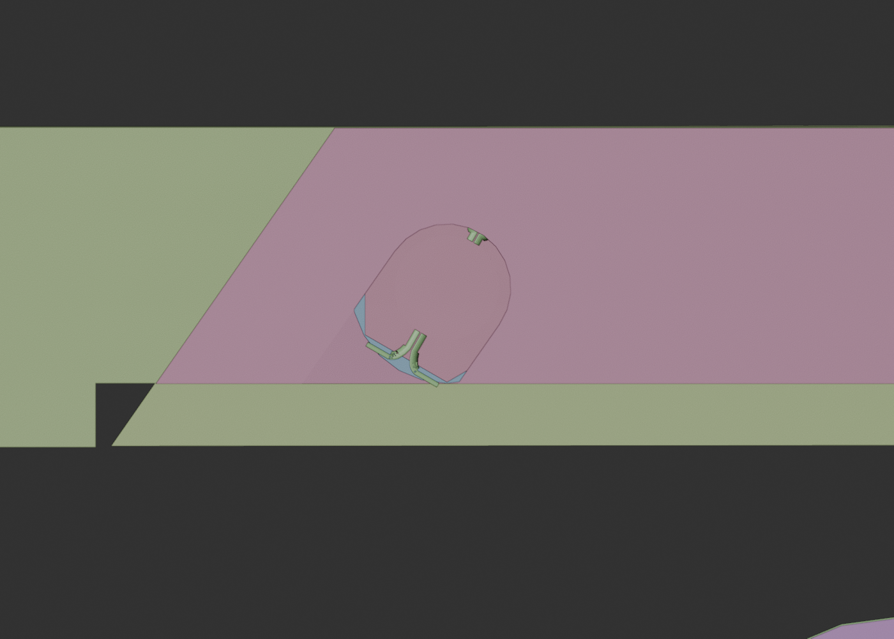
v2/audit/png/j_t0Rfront_from_in.png
