calo-lategan/Staircase/v2/audit/png/j_t0Rfront_from_out.png

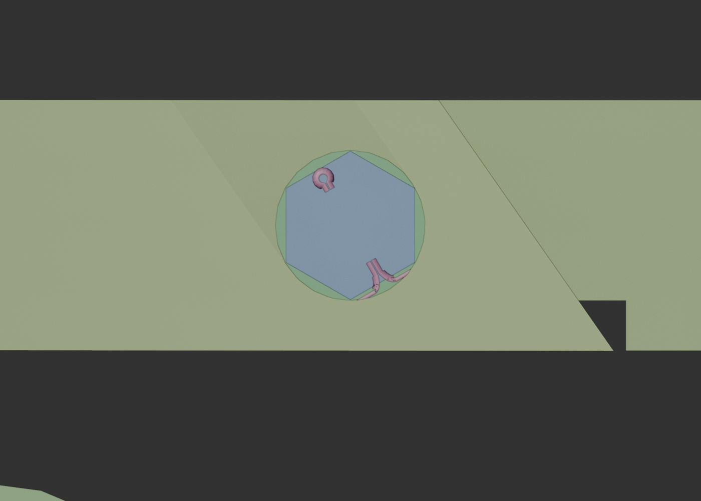
v2/audit/png/j_t0Rfront_from_out.png
