calo-lategan/Staircase/v2/audit/png/j_t0Rfront_iso.png

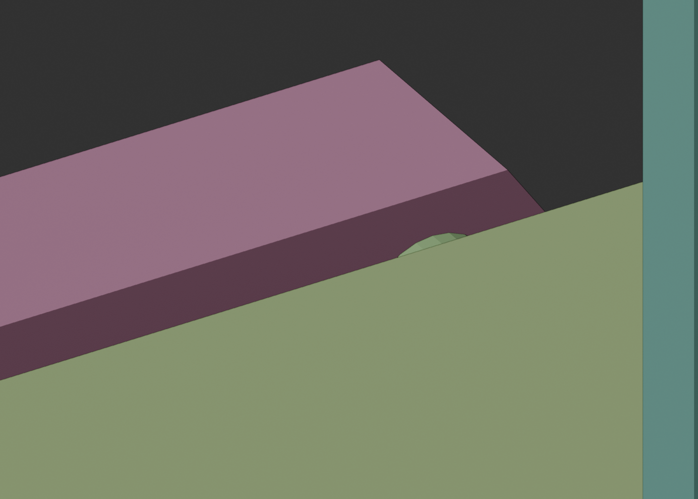
v2/audit/png/j_t0Rfront_iso.png
