calo-lategan/Staircase/v2/audit/png/t0_L_chan.png

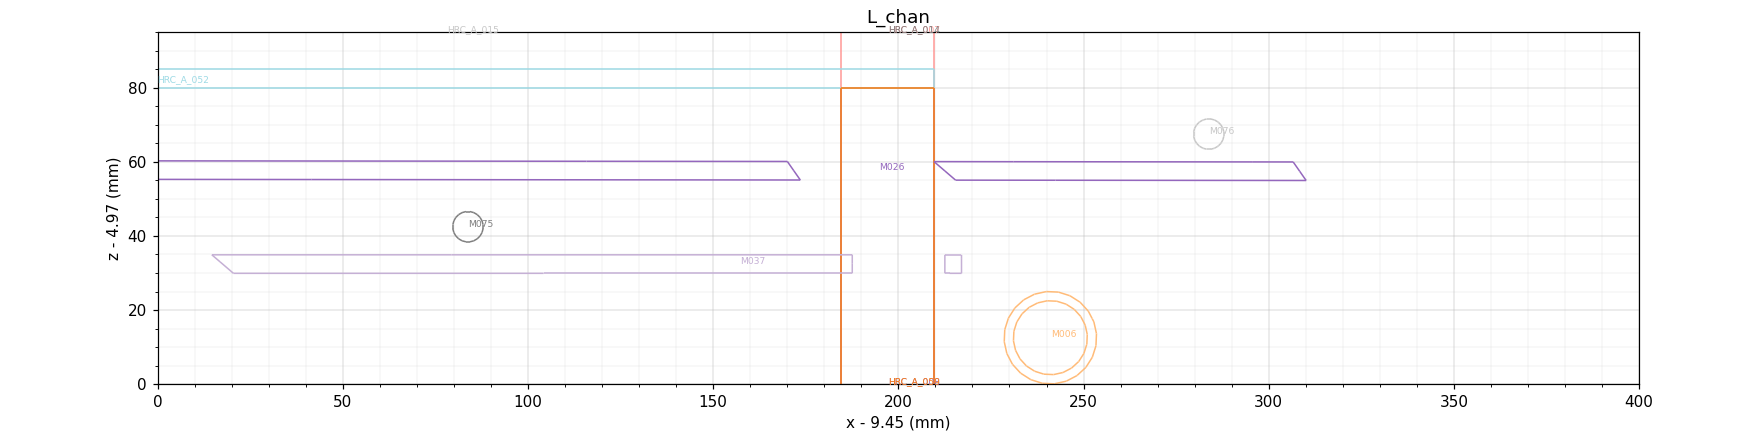
v2/audit/png/t0_L_chan.png
