calo-lategan/Staircase/v2/audit/png/tm_037_side_T0.png

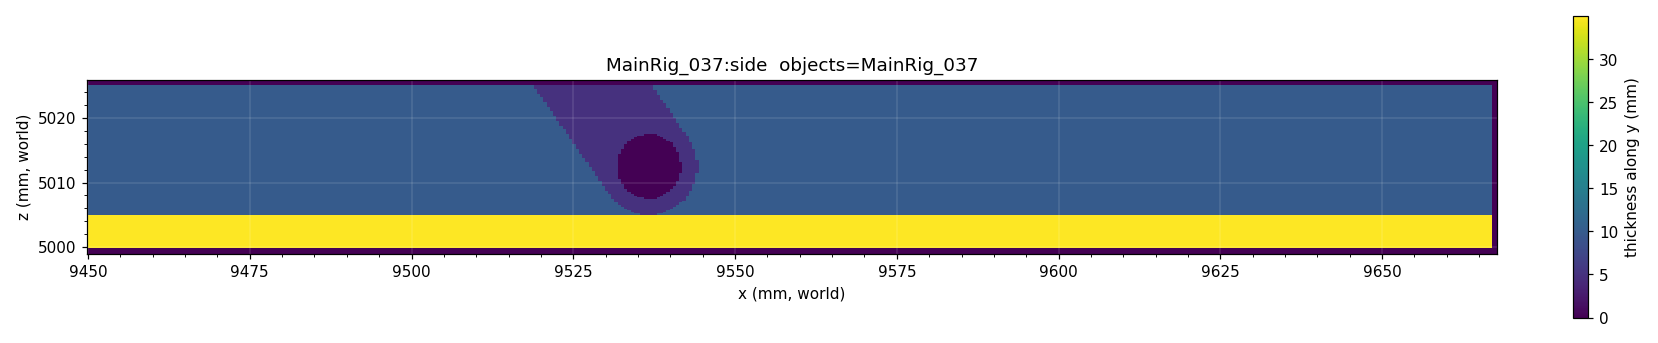
v2/audit/png/tm_037_side_T0.png
