calo-lategan/Staircase/v2/audit/png/tm_MainRig_118_plan_full.png

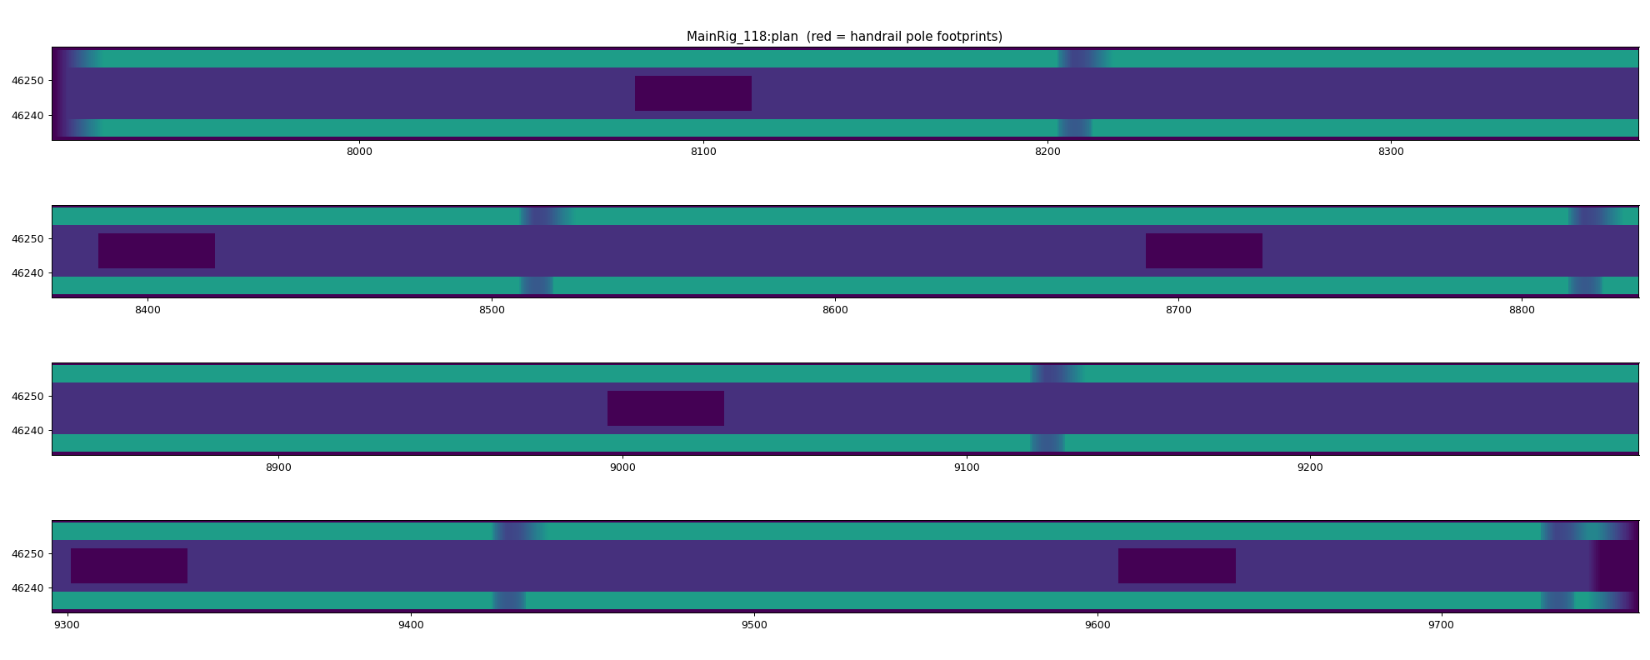
v2/audit/png/tm_MainRig_118_plan_full.png
