calo-lategan/Staircase/v2/audit/png/tm_MainRig_179_side_full.png

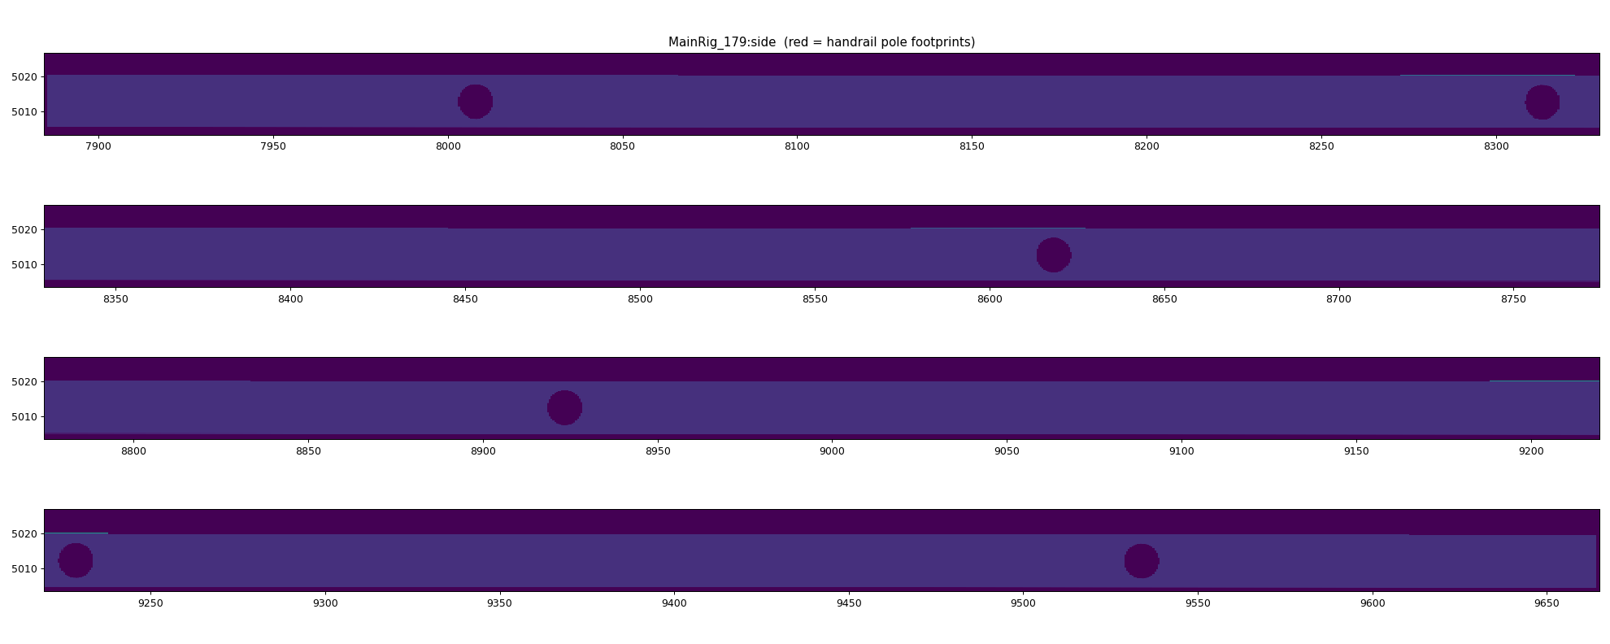
v2/audit/png/tm_MainRig_179_side_full.png
