calo-lategan/Staircase/v2/audit/tread_slices.png

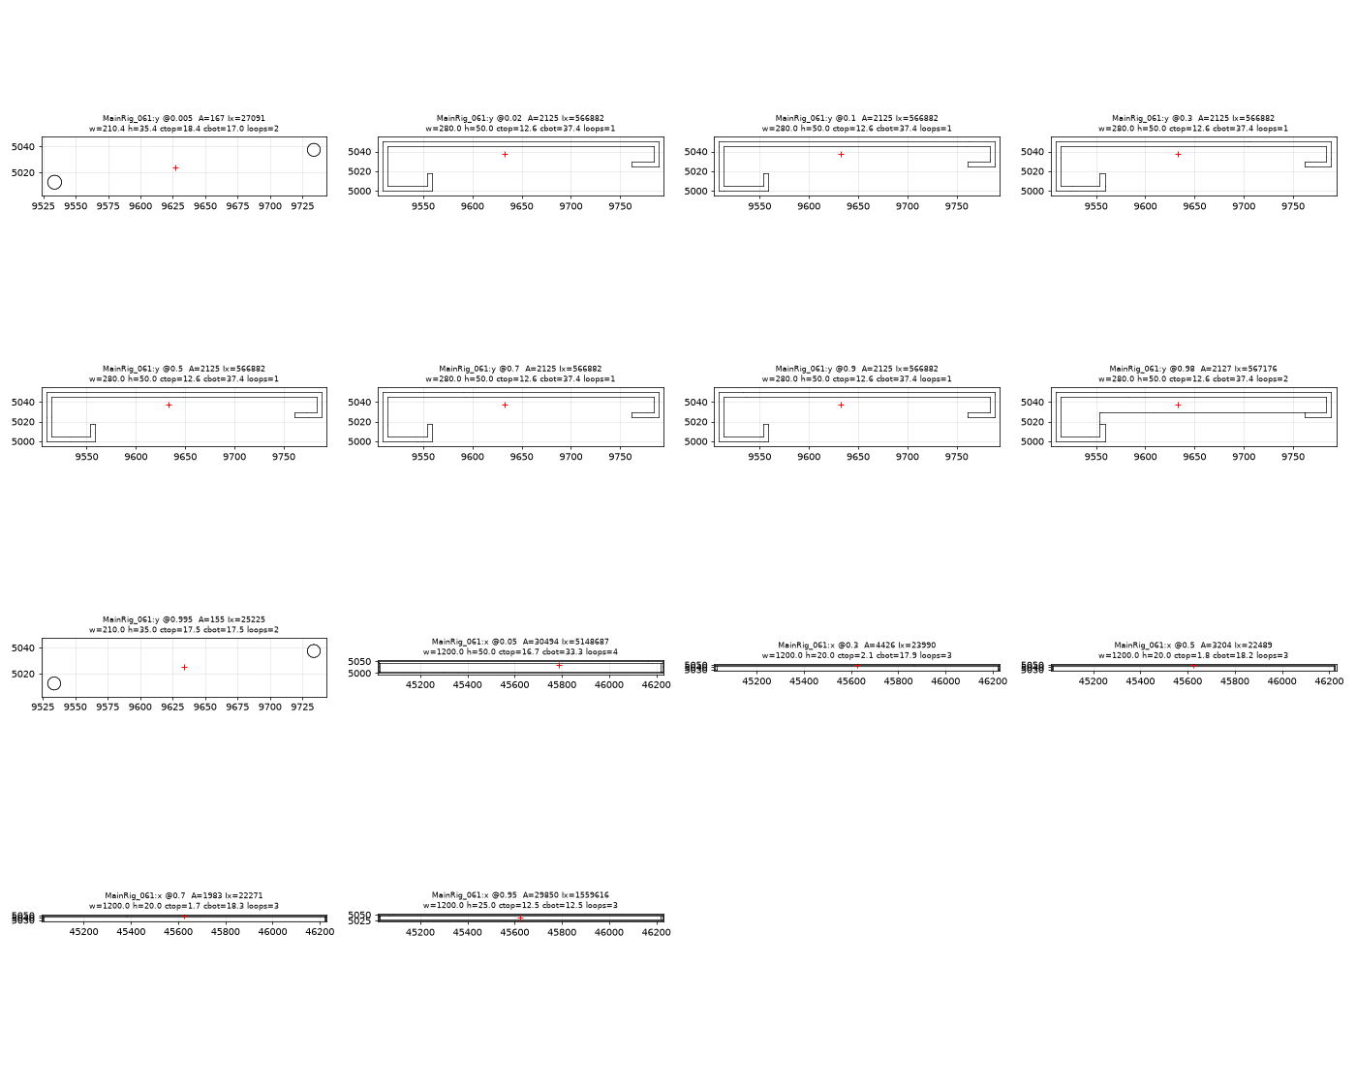
v2/audit/tread_slices.png
