calo-lategan/Staircase/v2/brief/_refs_sheet.png

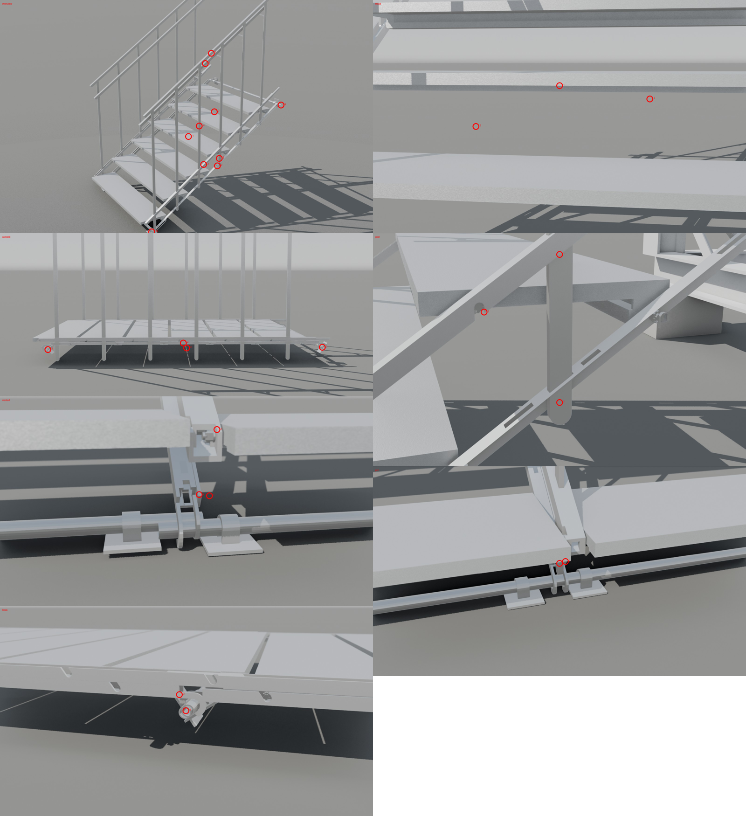
v2/brief/_refs_sheet.png
