calo-lategan/Staircase/v2/brief/chg/c2_where.jpg

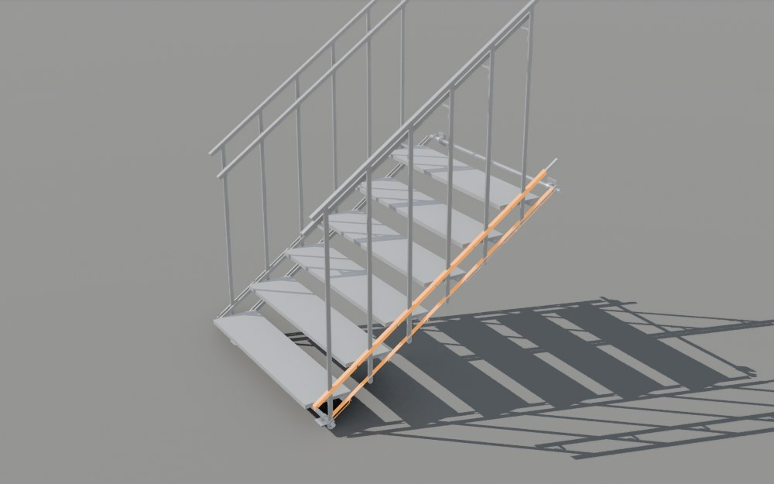
v2/brief/chg/c2_where.jpg
