calo-lategan/Staircase/v2/brief/chg/c5_close.jpg

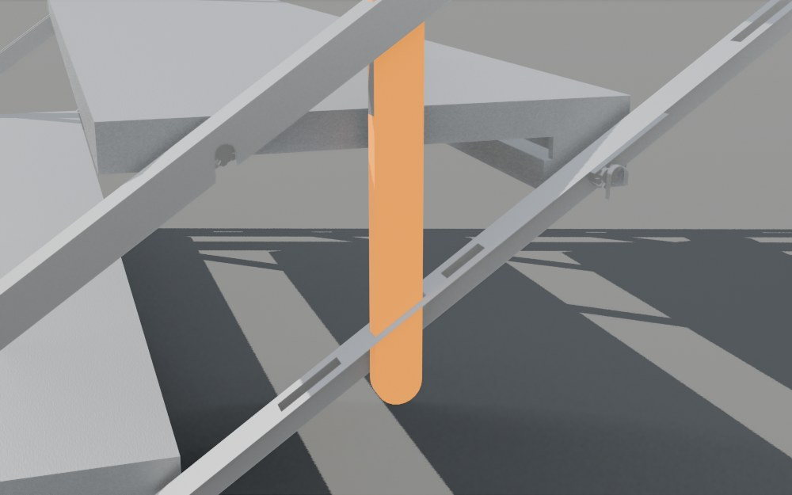
v2/brief/chg/c5_close.jpg
