calo-lategan/Staircase/v2/brief/chg/c13_close.jpg

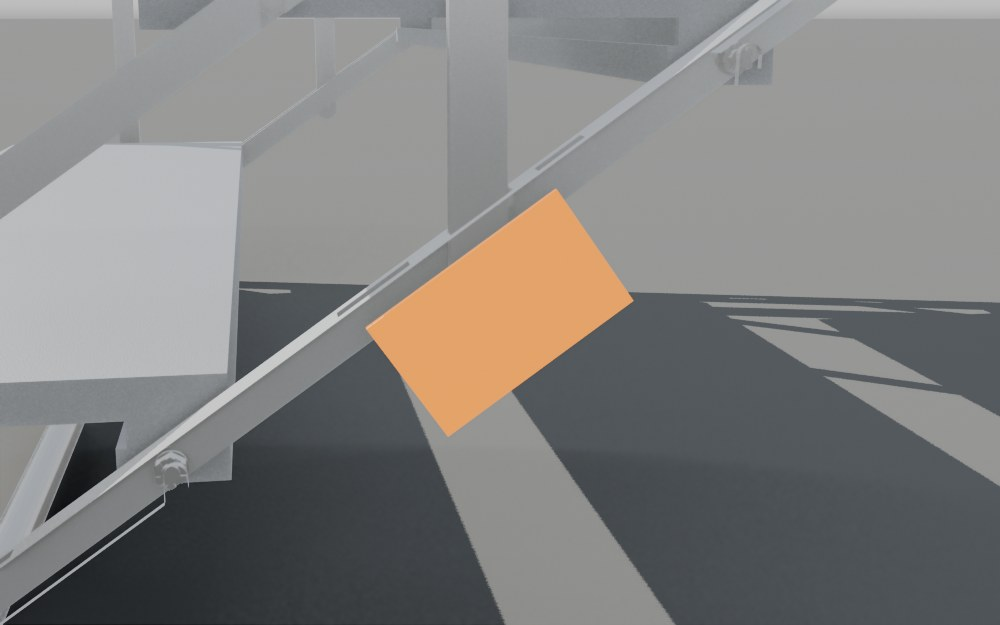
v2/brief/chg/c13_close.jpg
