calo-lategan/Staircase/v2/brief/img/ref_catwalk_side.jpg

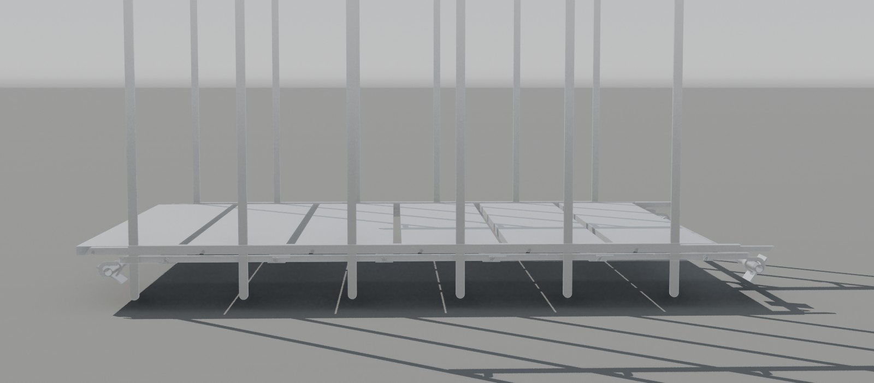
v2/brief/img/ref_catwalk_side.jpg
