calo-lategan/Staircase/v2/brief/img/ref_centre_pin.jpg

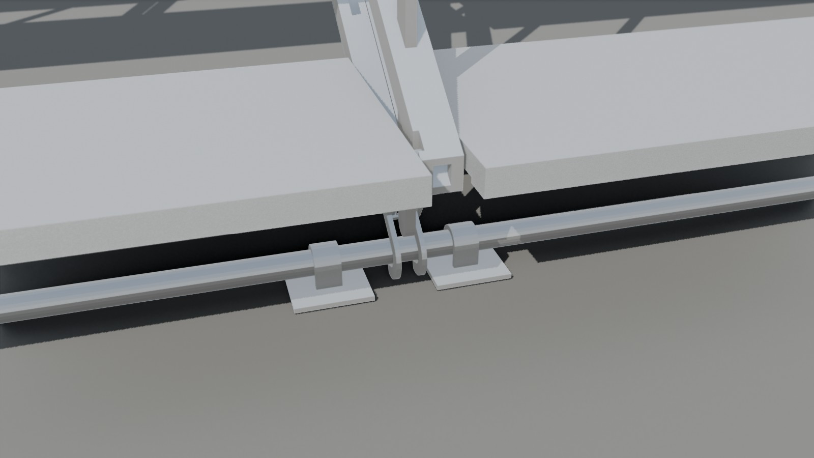
v2/brief/img/ref_centre_pin.jpg
