calo-lategan/Staircase/v2/brief/img/ref_end_hook.jpg

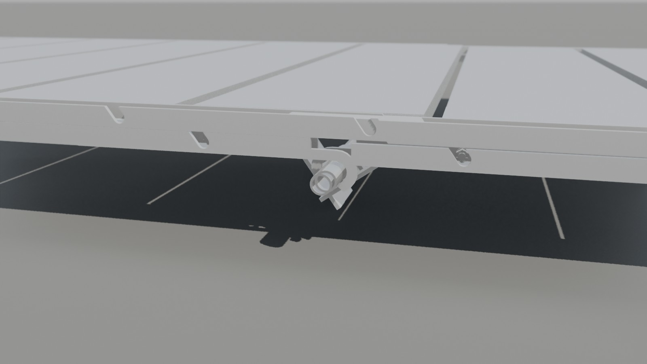
v2/brief/img/ref_end_hook.jpg
