calo-lategan/Staircase/v2/brief/img/ref_nested_join.jpg

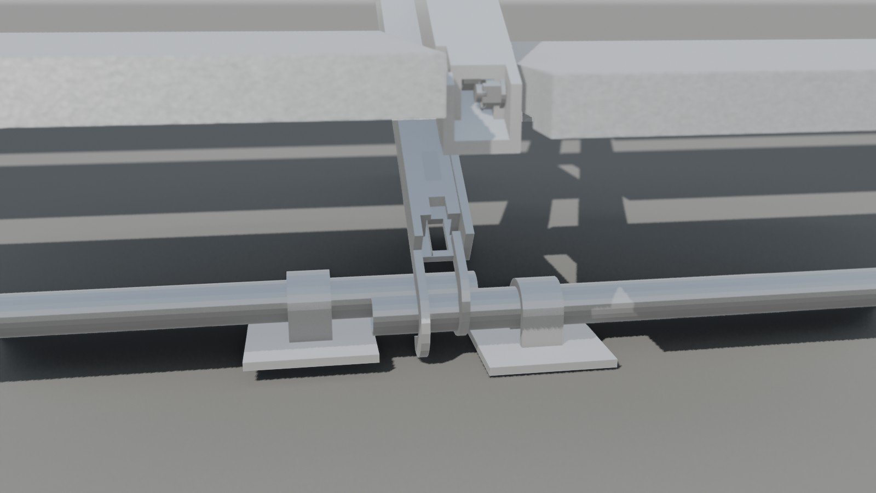
v2/brief/img/ref_nested_join.jpg
