calo-lategan/Staircase/v2/brief/img/ref_post_base.jpg

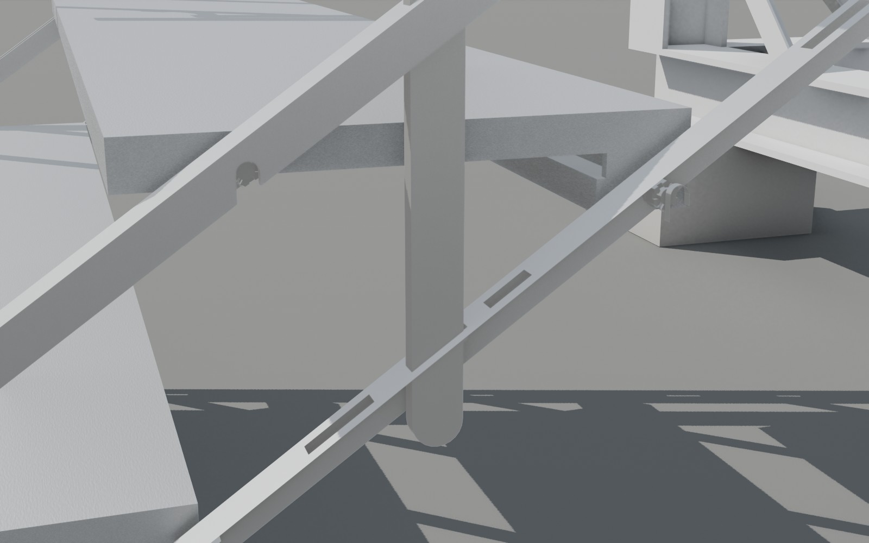
v2/brief/img/ref_post_base.jpg
