calo-lategan/Staircase/v2/brief/img/ref_tread_edge.jpg

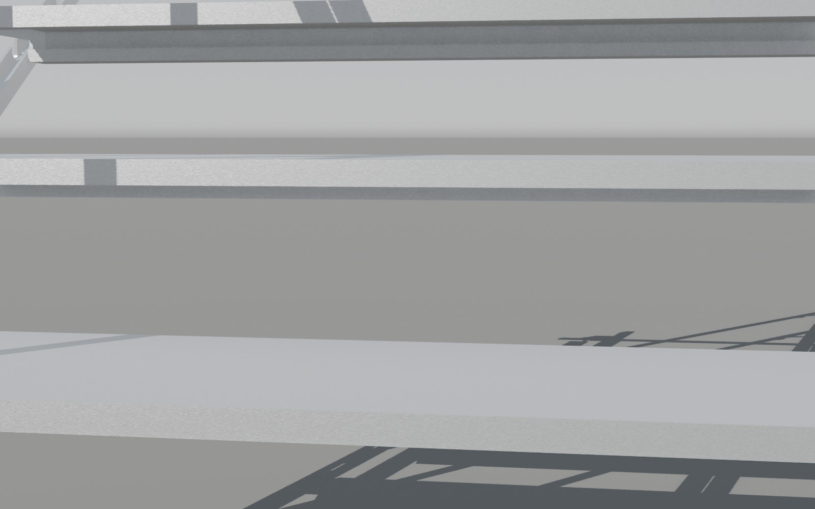
v2/brief/img/ref_tread_edge.jpg
