calo-lategan/Staircase/v2/brief/web/img/chg/c1_close.jpg

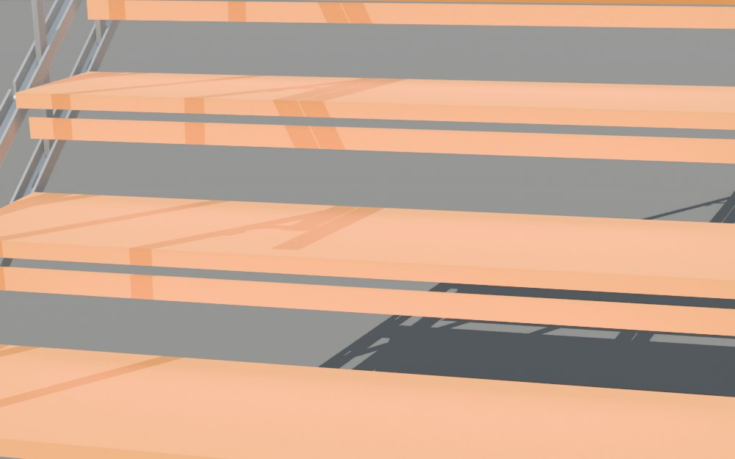
v2/brief/web/img/chg/c1_close.jpg
