calo-lategan/Staircase/v2/brief/web/img/chg/c2_close.jpg

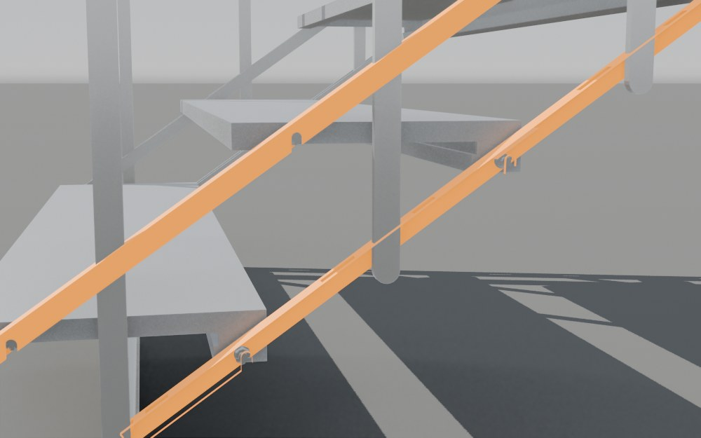
v2/brief/web/img/chg/c2_close.jpg
