calo-lategan/Staircase/v2/brief/web/img/chg/c3_close.jpg

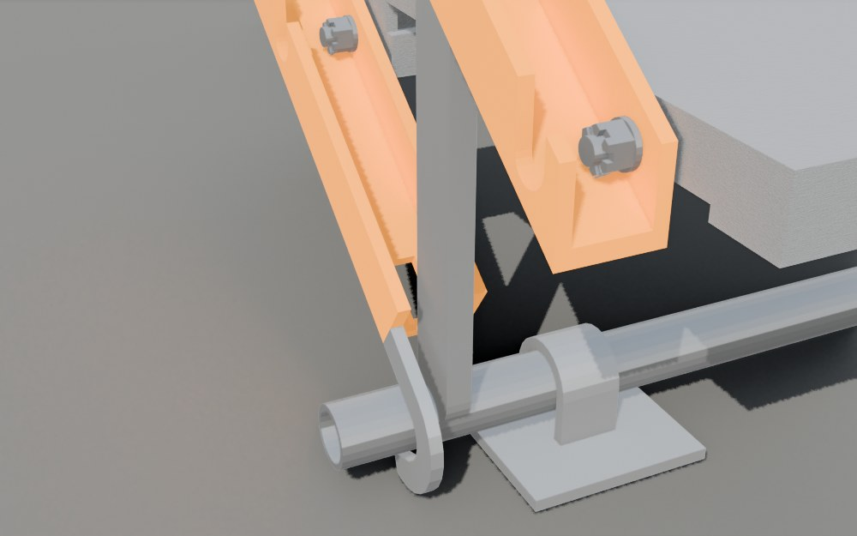
v2/brief/web/img/chg/c3_close.jpg
