calo-lategan/Staircase/v2/brief/web/img/chg/c3_where.jpg

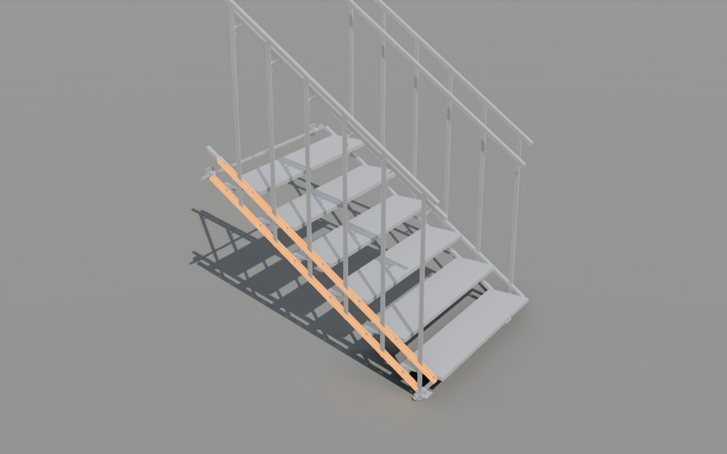
v2/brief/web/img/chg/c3_where.jpg
