calo-lategan/Staircase/v2/brief/web/img/chg/c4_close.jpg

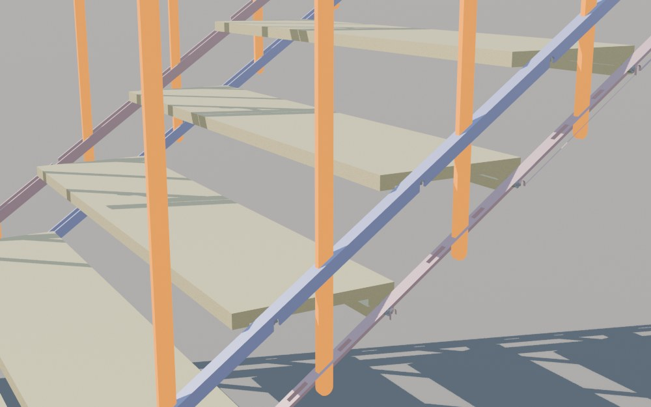
v2/brief/web/img/chg/c4_close.jpg
