calo-lategan/Staircase/v2/brief/web/img/chg/c4_where.jpg

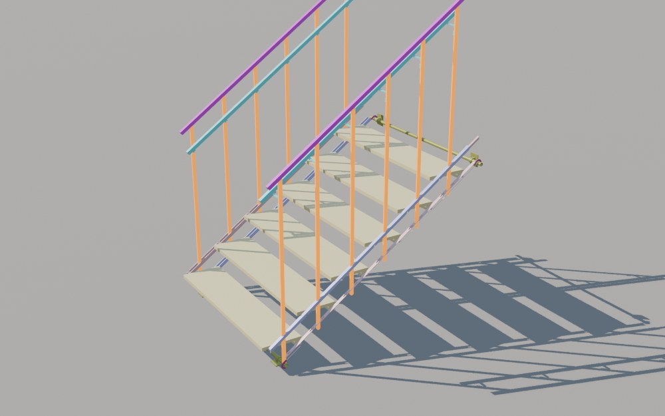
v2/brief/web/img/chg/c4_where.jpg
