calo-lategan/Staircase/v2/brief/web/img/chg/c6_close.jpg

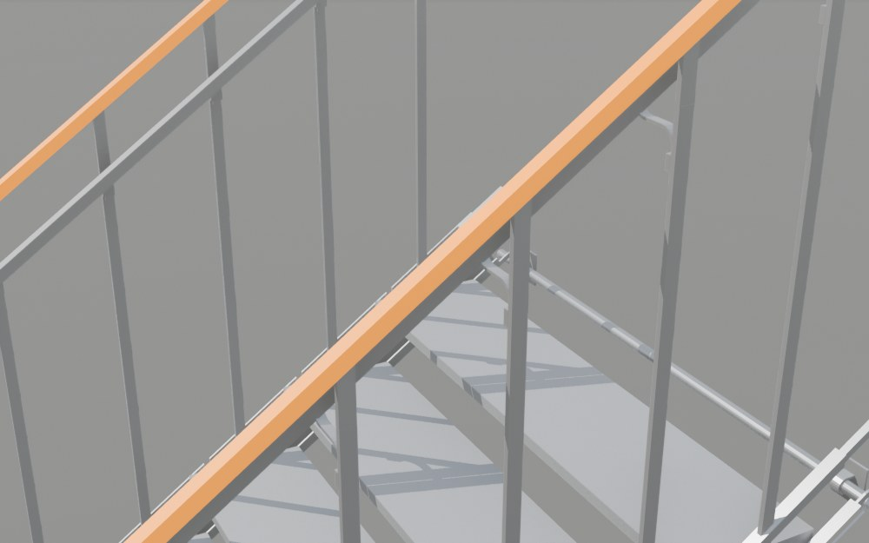
v2/brief/web/img/chg/c6_close.jpg
