calo-lategan/Staircase/v2/brief/web/img/chg/c6_where.jpg

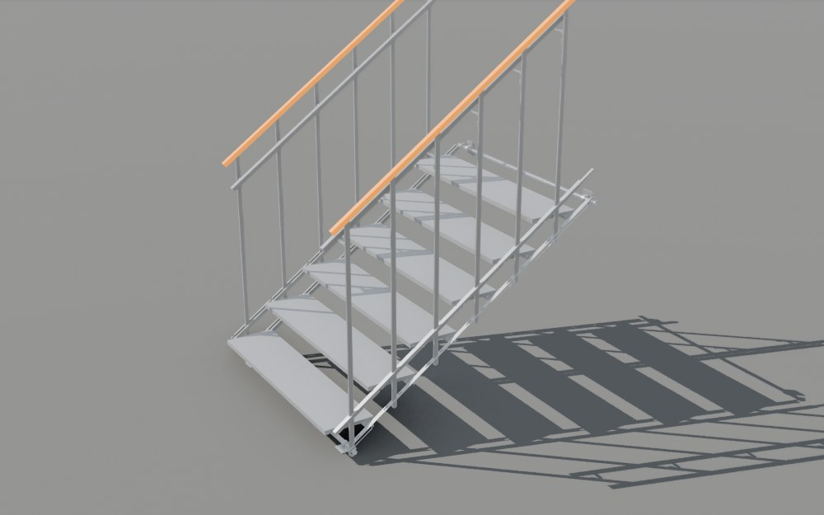
v2/brief/web/img/chg/c6_where.jpg
