calo-lategan/Staircase/v2/brief/web/img/chg/c7_close.jpg

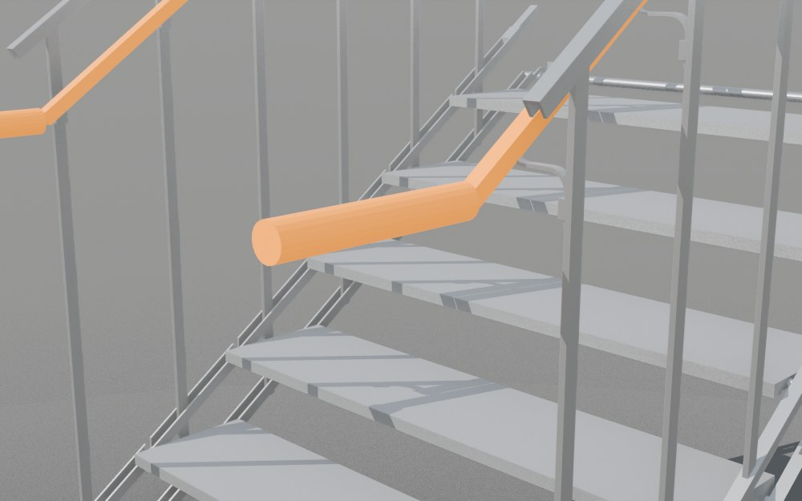
v2/brief/web/img/chg/c7_close.jpg
