calo-lategan/Staircase/v2/brief/web/img/chg/c7_where.jpg

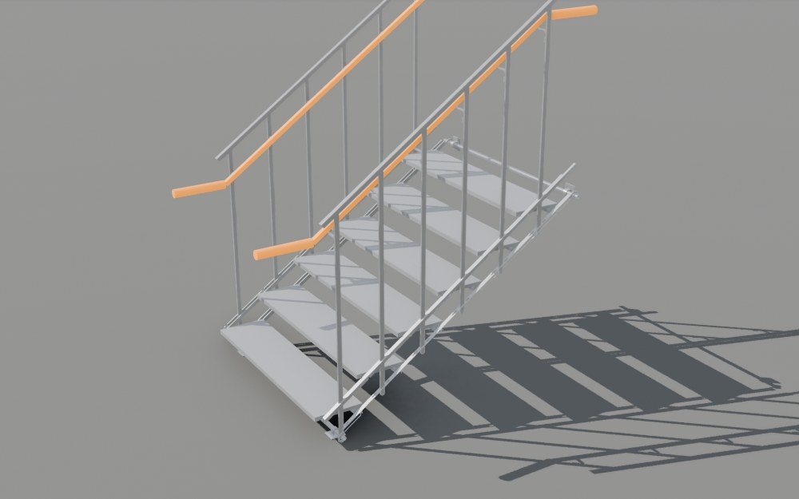
v2/brief/web/img/chg/c7_where.jpg
