calo-lategan/Staircase/v2/brief/web/img/chg/c8_close.jpg

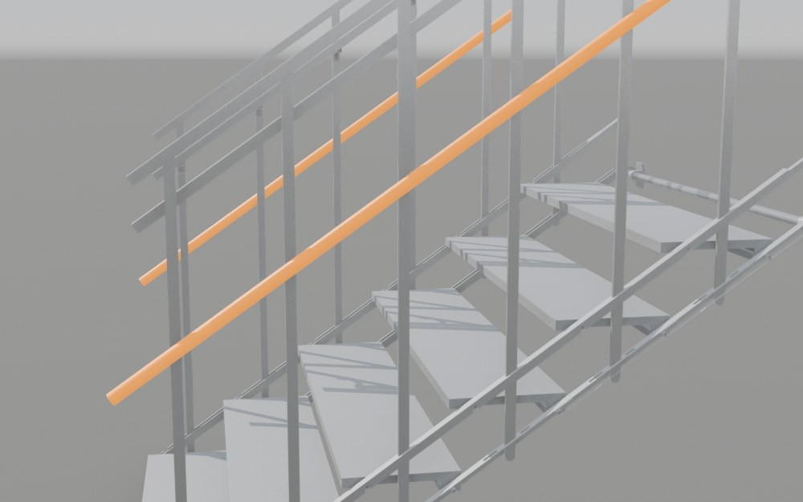
v2/brief/web/img/chg/c8_close.jpg
