calo-lategan/Staircase/v2/brief/web/img/chg/c9_close.jpg

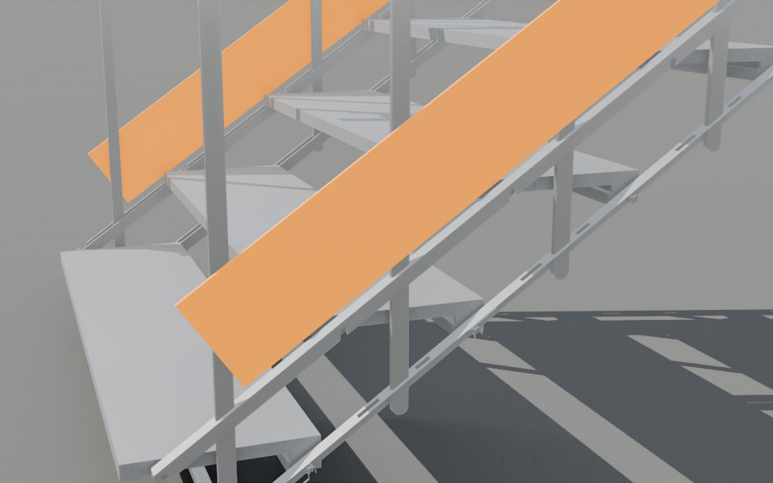
v2/brief/web/img/chg/c9_close.jpg
