calo-lategan/Staircase/v2/brief/web/img/chg/c10_close.jpg

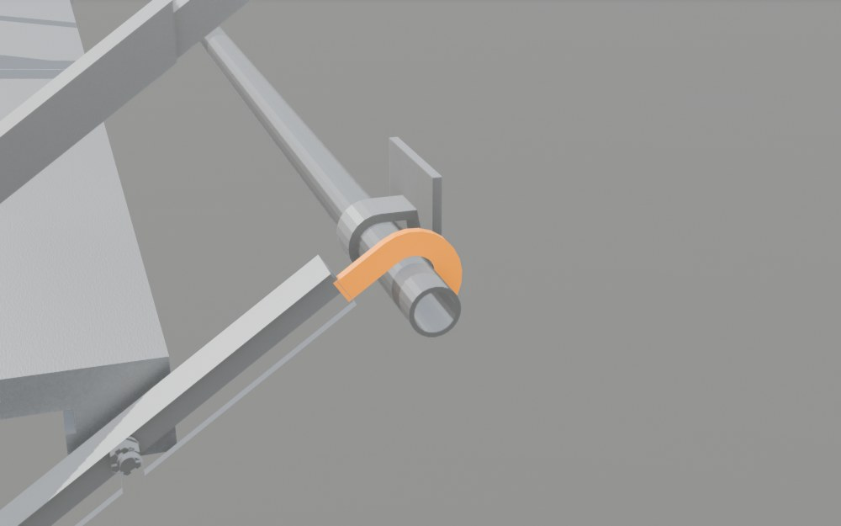
v2/brief/web/img/chg/c10_close.jpg
