calo-lategan/Staircase/v2/brief/web/img/chg/c11_close.jpg

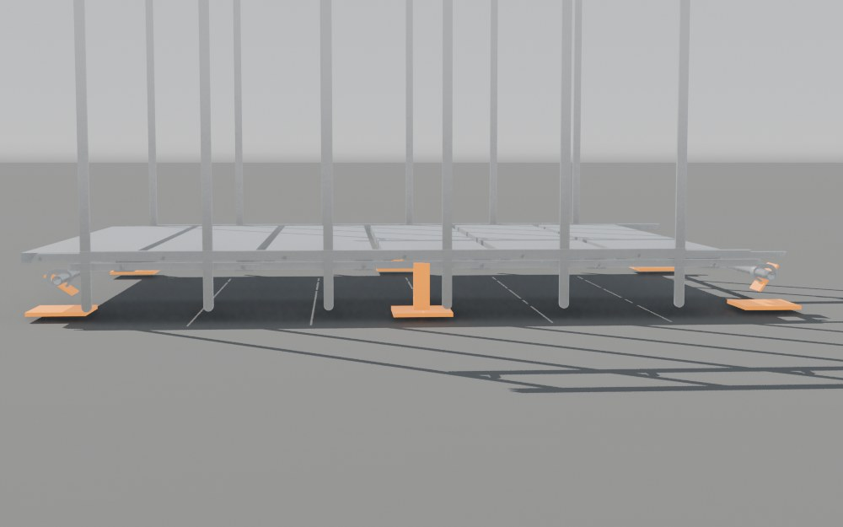
v2/brief/web/img/chg/c11_close.jpg
