calo-lategan/Staircase/v2/brief/web/img/chg/c11_where.jpg

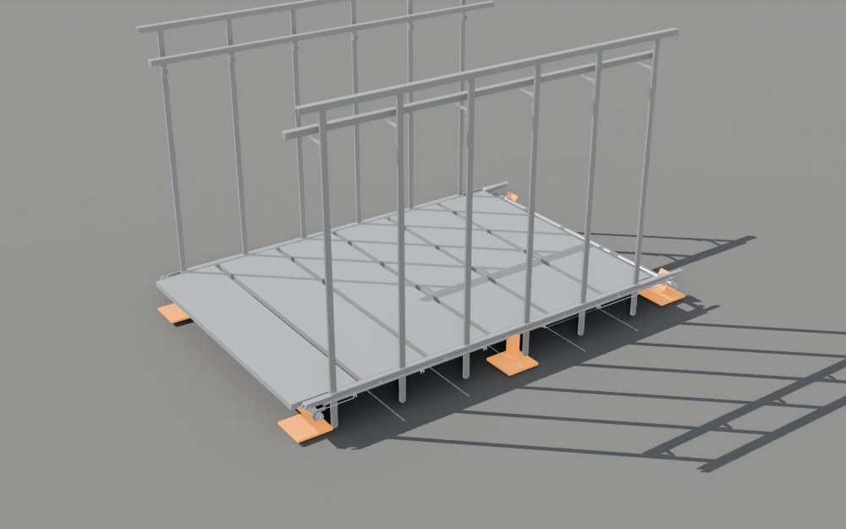
v2/brief/web/img/chg/c11_where.jpg
