calo-lategan/Staircase/v2/brief/web/img/chg/c12_close.jpg

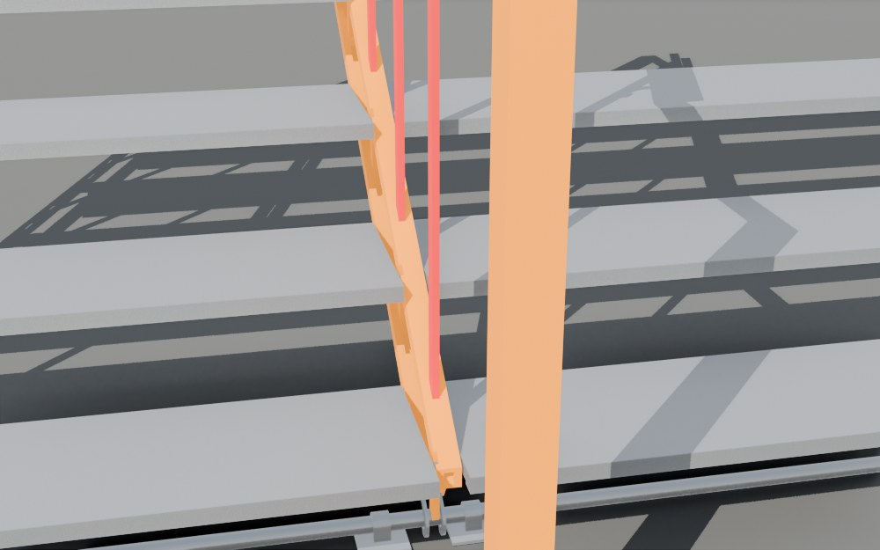
v2/brief/web/img/chg/c12_close.jpg
