calo-lategan/Staircase/v2/brief/web/img/chg/c12_where.jpg

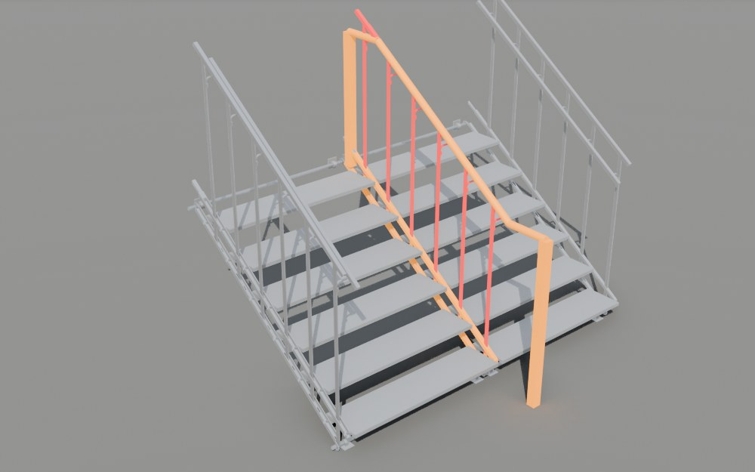
v2/brief/web/img/chg/c12_where.jpg
