calo-lategan/Staircase/v2/brief/web/img/final/f1_close1.jpg

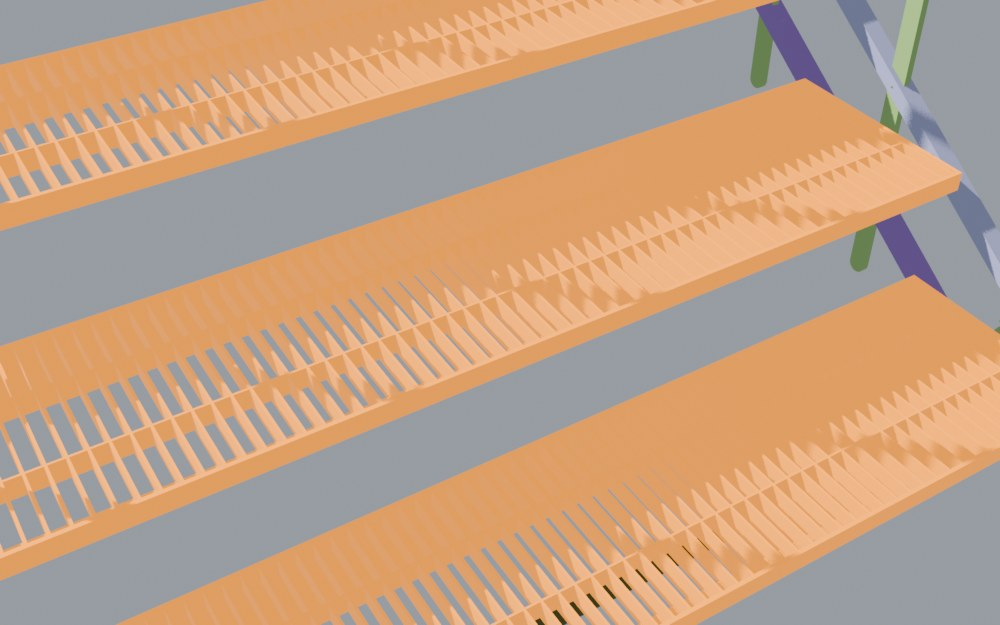
v2/brief/web/img/final/f1_close1.jpg
