calo-lategan/Staircase/v2/brief/web/img/final/f1_where.jpg

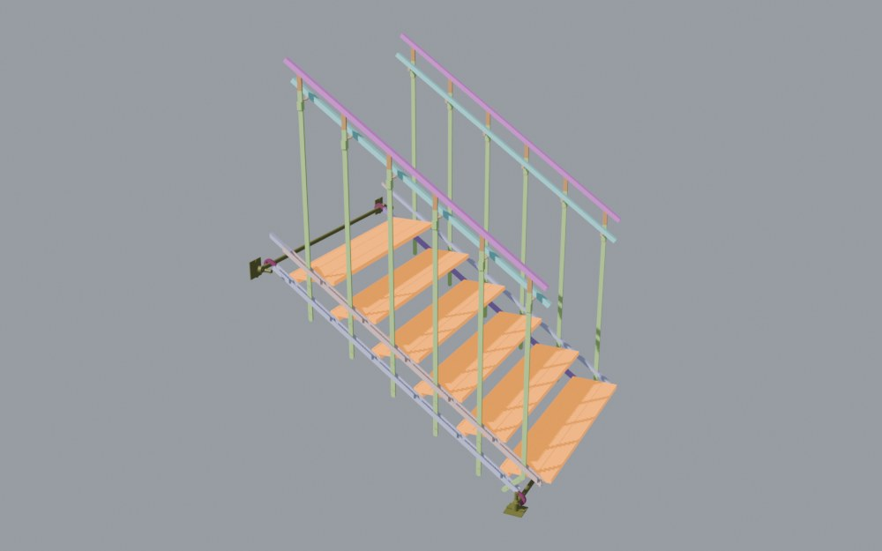
v2/brief/web/img/final/f1_where.jpg
