calo-lategan/Staircase/v2/brief/web/img/final/f2_close1.jpg

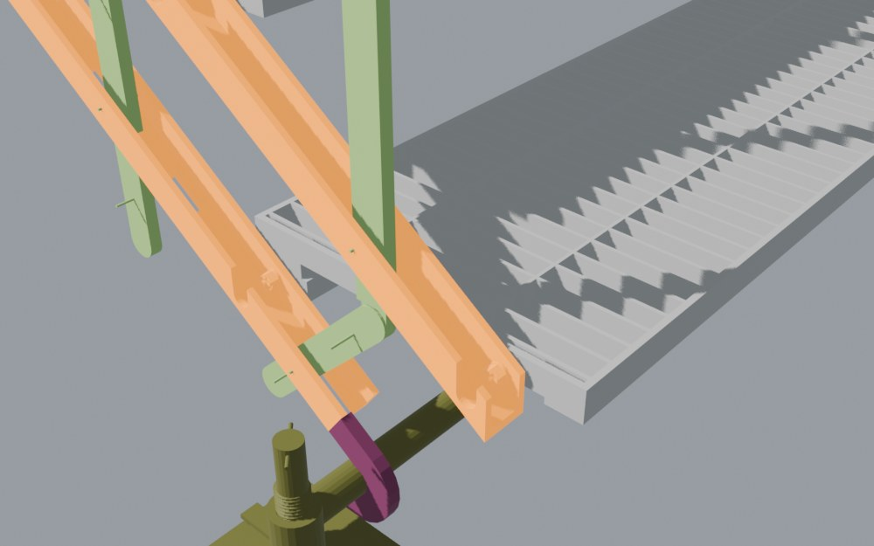
v2/brief/web/img/final/f2_close1.jpg
