calo-lategan/Staircase/v2/brief/web/img/final/f2_where.jpg

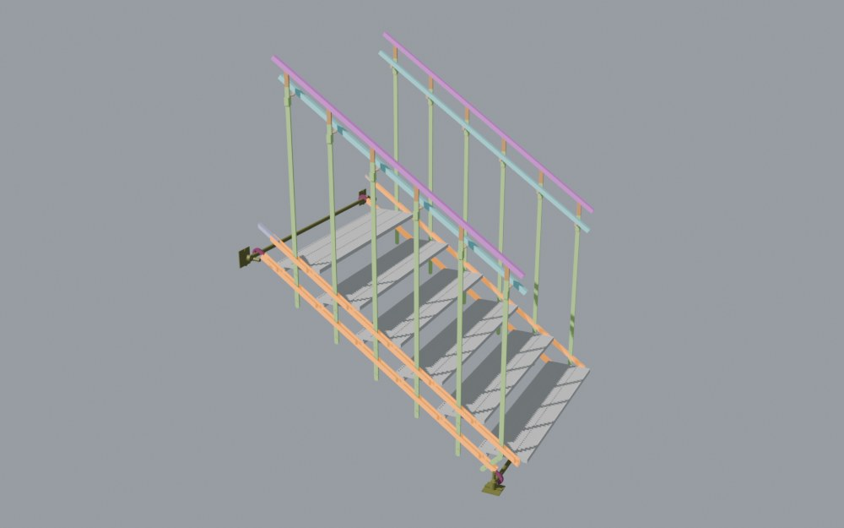
v2/brief/web/img/final/f2_where.jpg
