calo-lategan/Staircase/v2/brief/web/img/final/f4_close1.jpg

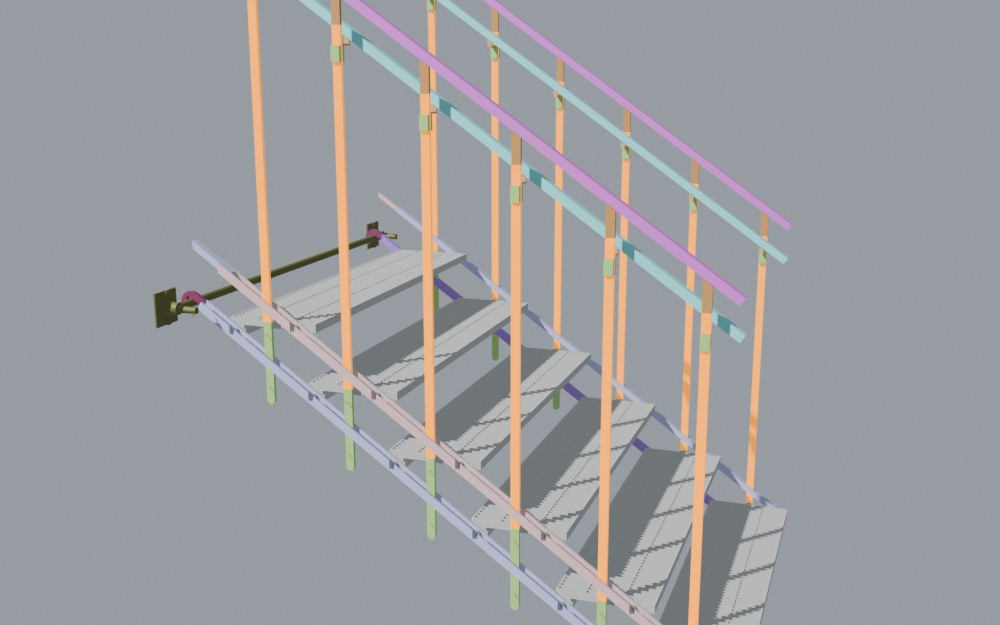
v2/brief/web/img/final/f4_close1.jpg
