calo-lategan/Staircase/v2/brief/web/img/final/f5_close2.jpg

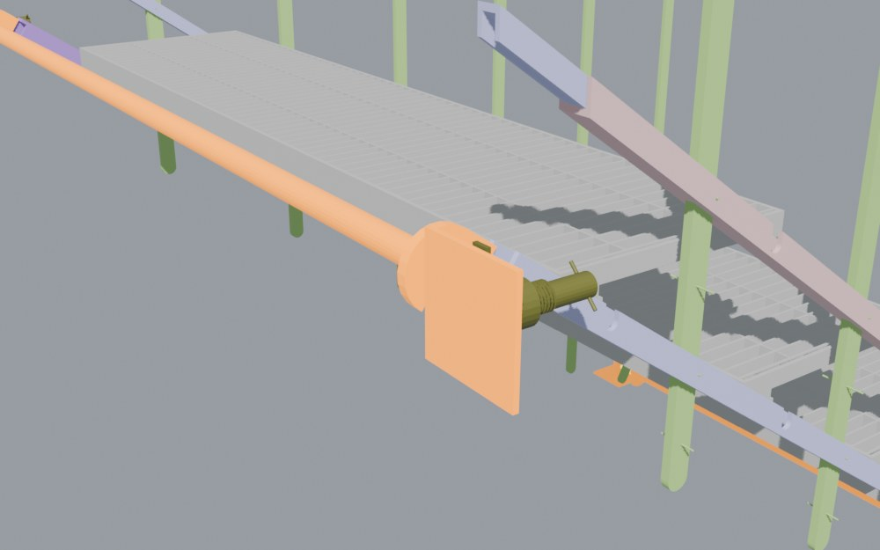
v2/brief/web/img/final/f5_close2.jpg
