calo-lategan/Staircase/v2/brief/web/img/final/f5_where.jpg

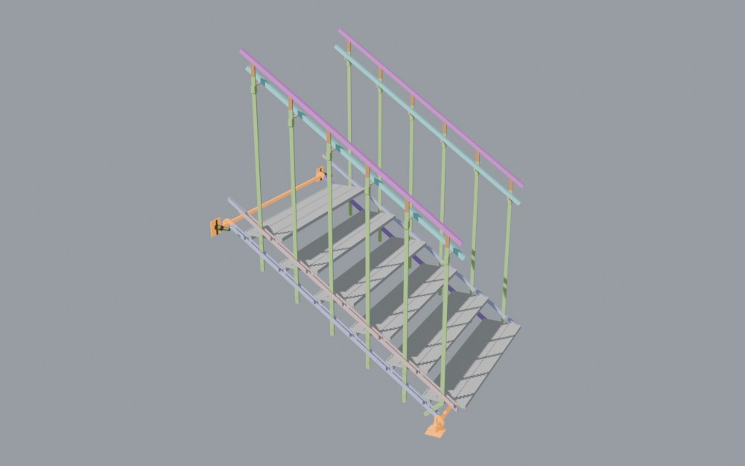
v2/brief/web/img/final/f5_where.jpg
