calo-lategan/Staircase/v2/brief/web/img/final/f6_close1.jpg

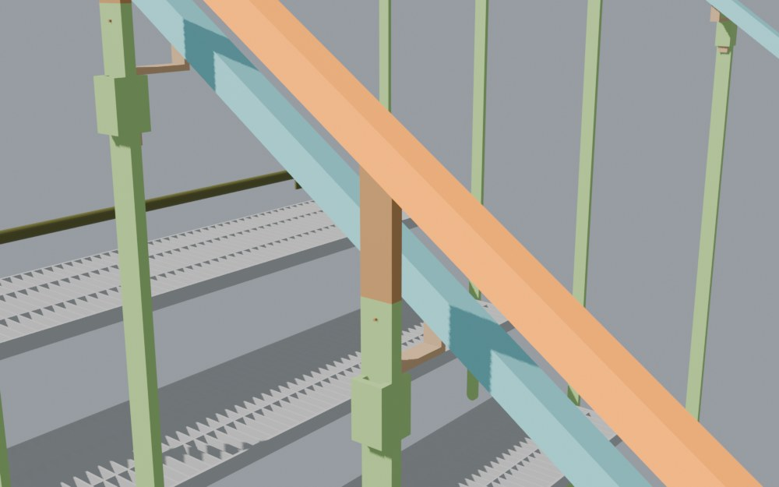
v2/brief/web/img/final/f6_close1.jpg
