calo-lategan/Staircase/v2/brief/web/img/final/f6_where.jpg

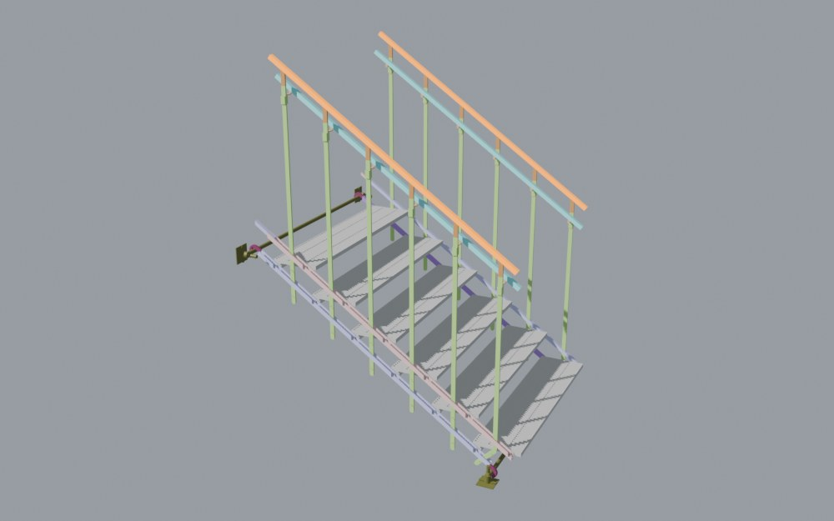
v2/brief/web/img/final/f6_where.jpg
