calo-lategan/Staircase/v2/brief/web/img/final/f8_close1.jpg

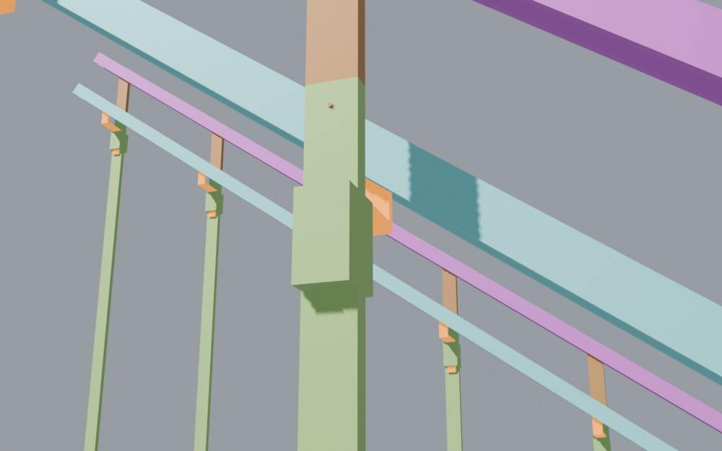
v2/brief/web/img/final/f8_close1.jpg
