calo-lategan/Staircase/v2/brief/web/img/final/f9_close1.jpg

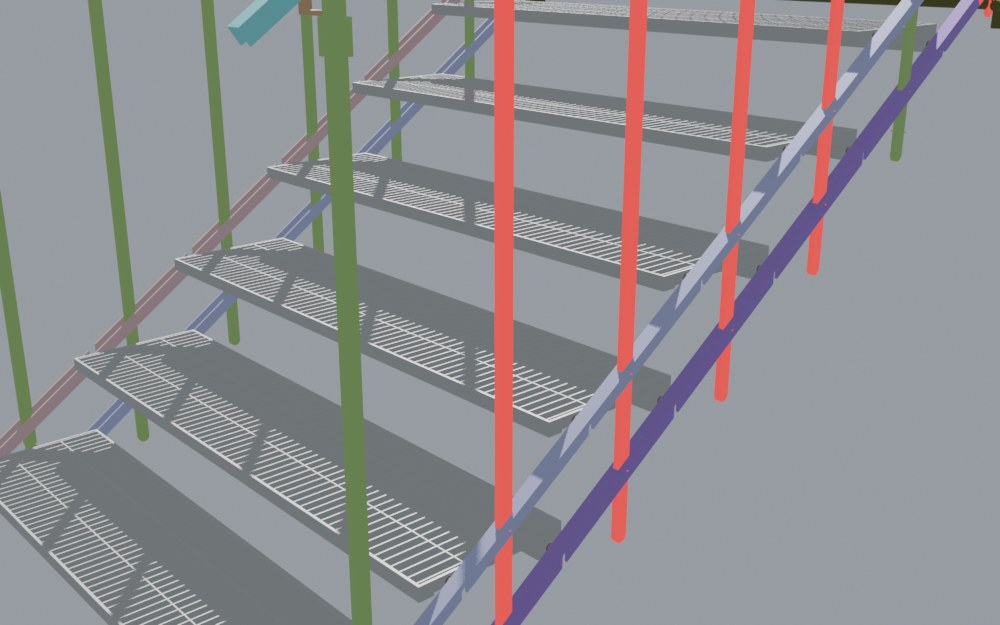
v2/brief/web/img/final/f9_close1.jpg
