calo-lategan/Staircase/v2/brief/web/img/final/f9_close2.jpg

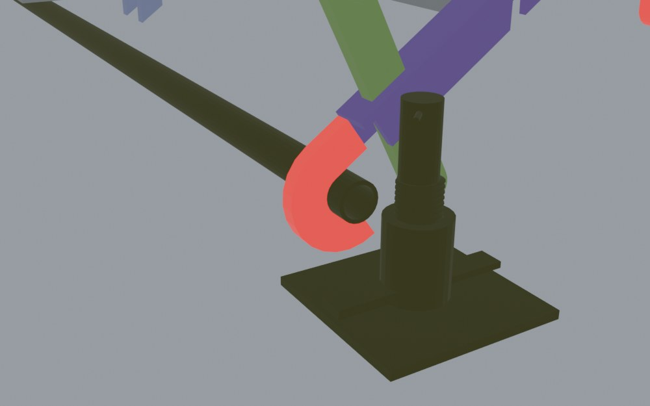
v2/brief/web/img/final/f9_close2.jpg
