calo-lategan/Staircase/v2/datasheet/img/detail_bar_cabin.png

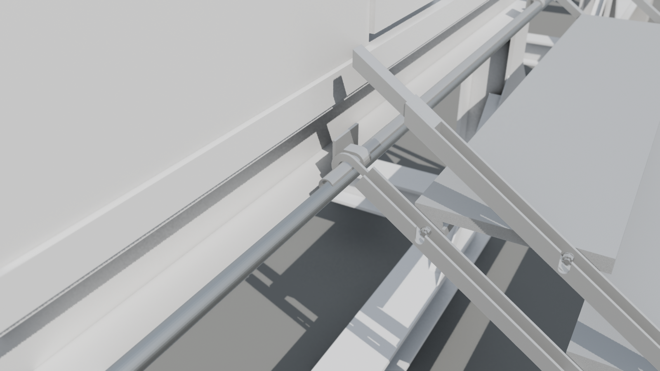
v2/datasheet/img/detail_bar_cabin.png
