calo-lategan/Staircase/v2/datasheet/img/detail_fold_rails.png

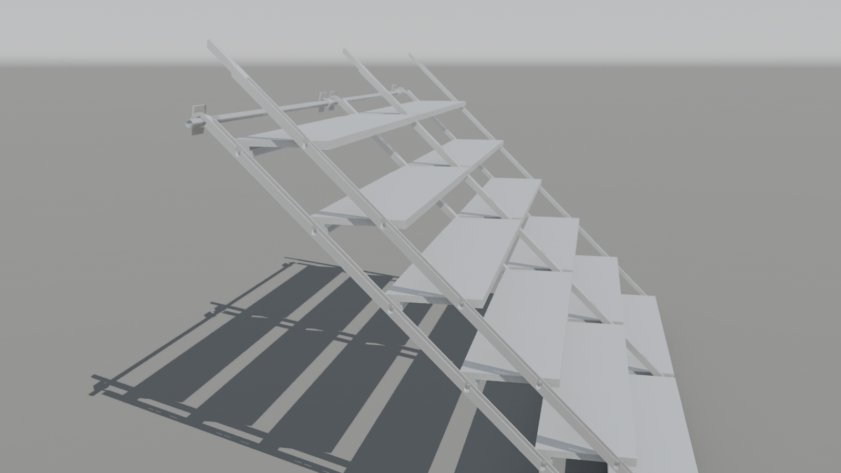
v2/datasheet/img/detail_fold_rails.png
