calo-lategan/Staircase/v2/datasheet/img/detail_lift_out.png

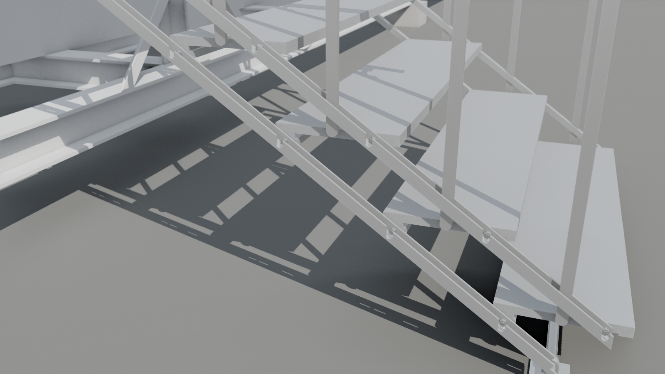
v2/datasheet/img/detail_lift_out.png
