calo-lategan/Staircase/v2/datasheet/img/DOUBLE_CATWALK.png

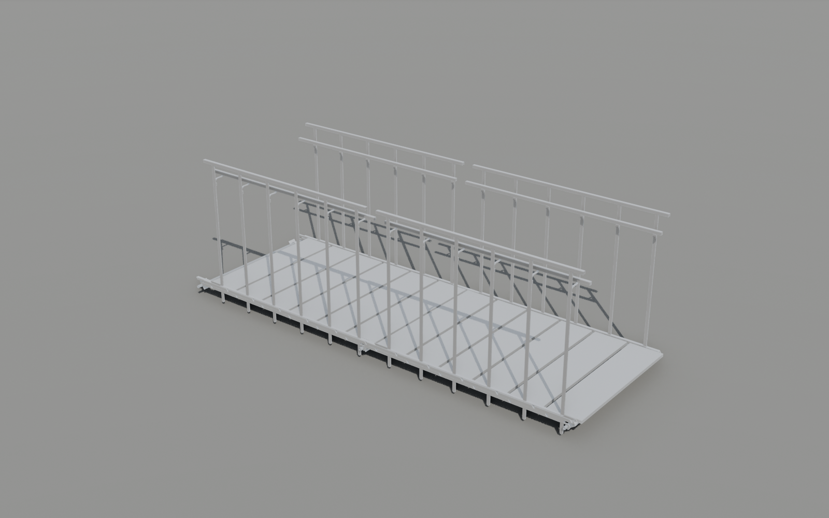
v2/datasheet/img/DOUBLE_CATWALK.png
