calo-lategan/Staircase/v2/datasheet/img/DOUBLE_STANDARD.png

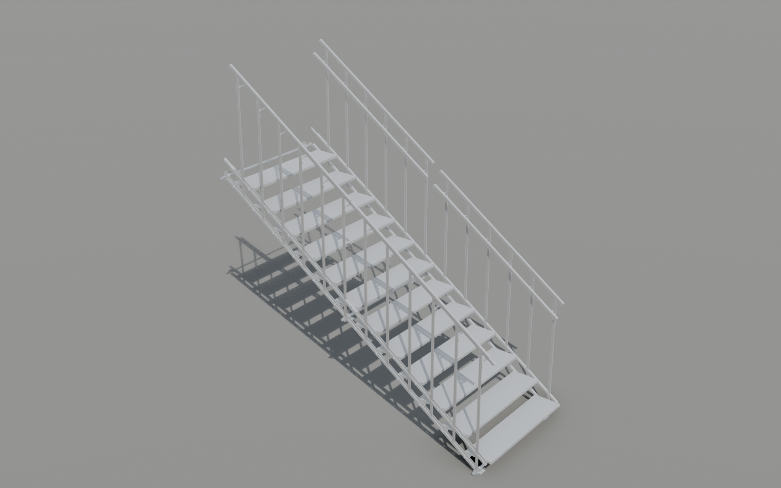
v2/datasheet/img/DOUBLE_STANDARD.png
