calo-lategan/Staircase/v2/datasheet/img/DOUBLE_STEEP.png

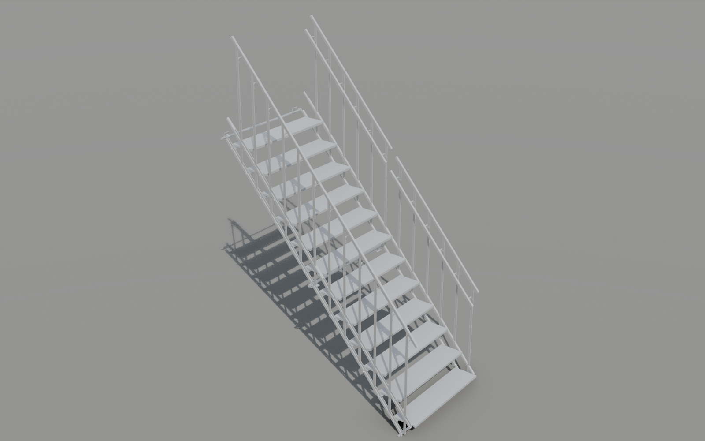
v2/datasheet/img/DOUBLE_STEEP.png
