calo-lategan/Staircase/v2/datasheet/img/SINGLE_BAR.png

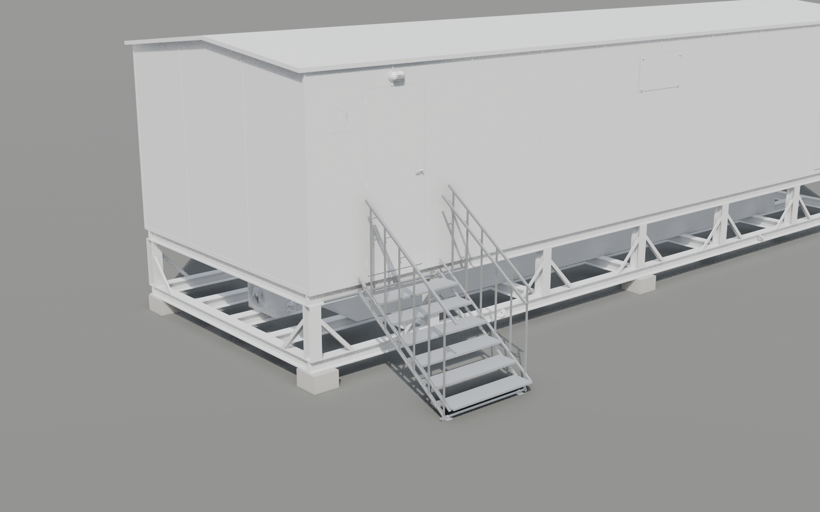
v2/datasheet/img/SINGLE_BAR.png
