calo-lategan/Staircase/v2/datasheet/img/SINGLE_CATWALK.png

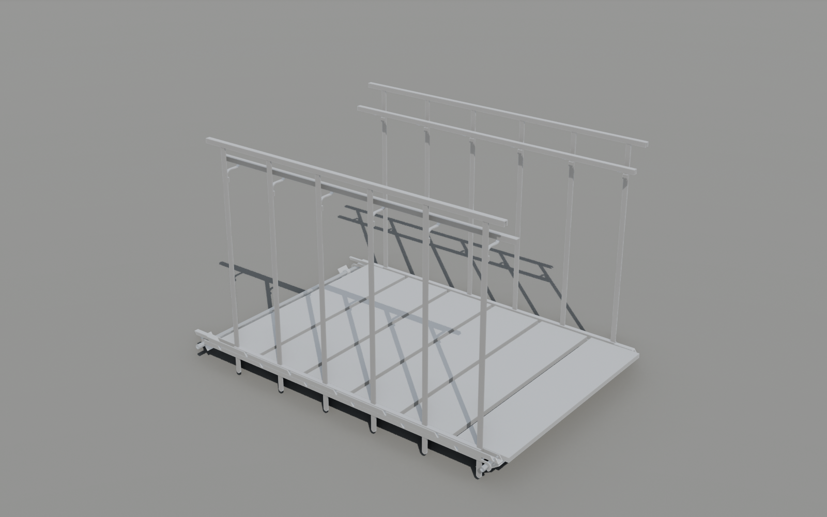
v2/datasheet/img/SINGLE_CATWALK.png
