calo-lategan/Staircase/v2/datasheet/img/SINGLE_STEEP.png

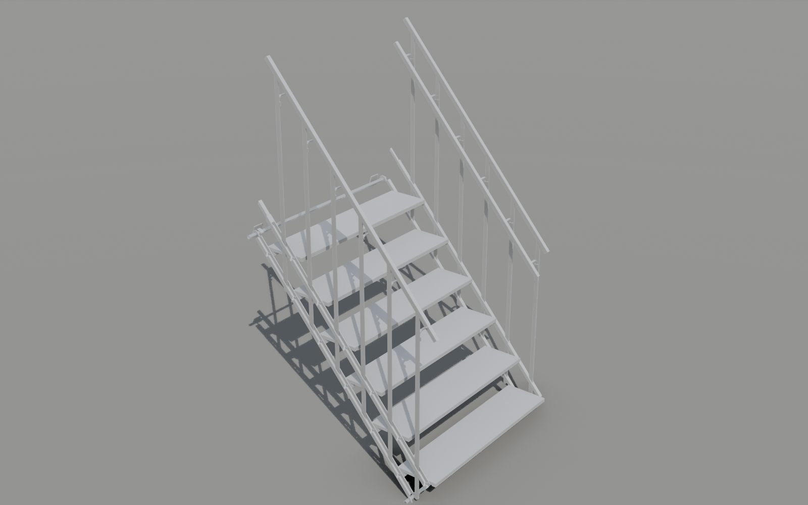
v2/datasheet/img/SINGLE_STEEP.png
