calo-lategan/Staircase/v2/datasheet/img/WIDE_CATWALK_FULL.png

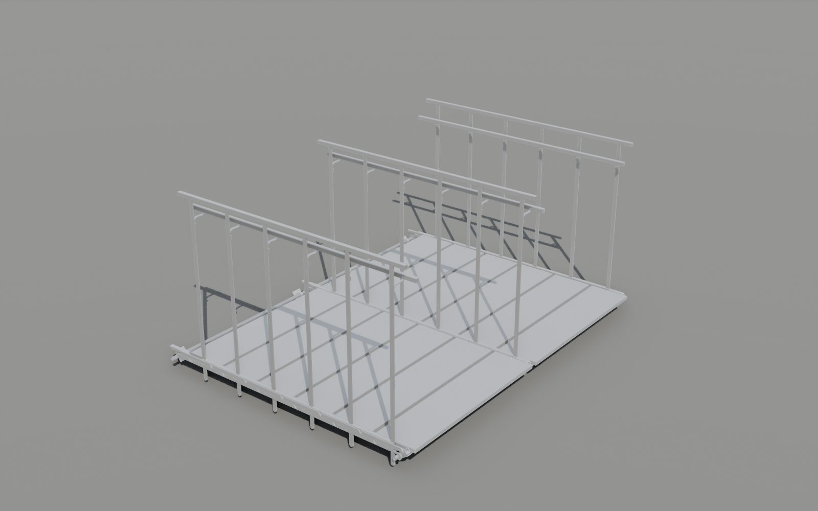
v2/datasheet/img/WIDE_CATWALK_FULL.png
