calo-lategan/Staircase/v2/datasheet/img/WIDE_STANDARD.png

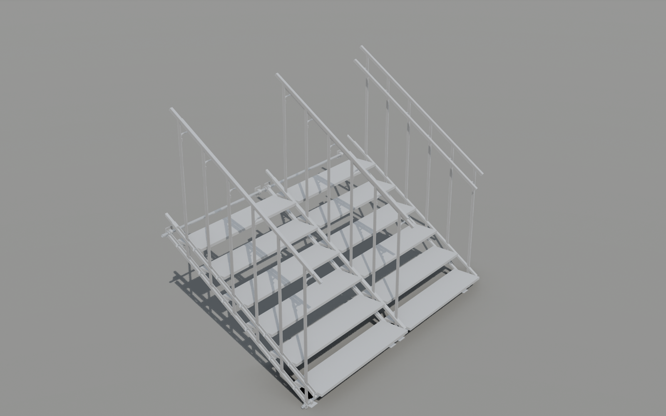
v2/datasheet/img/WIDE_STANDARD.png
