calo-lategan/Staircase/v2/datasheet/web/img/detail_end_hook.jpg

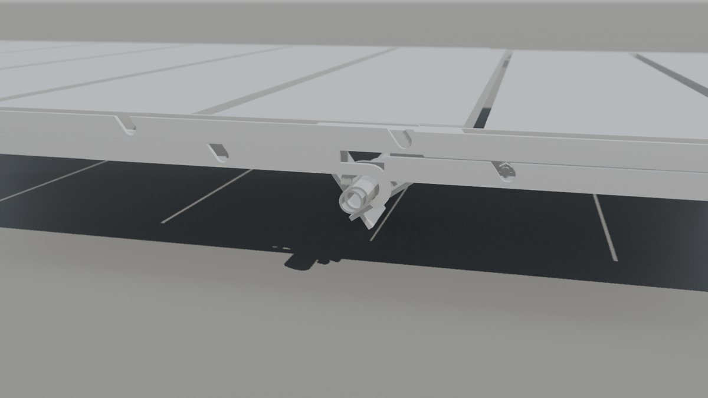
v2/datasheet/web/img/detail_end_hook.jpg
