calo-lategan/Staircase/v2/datasheet/web/img/DOUBLE_STEEP.jpg

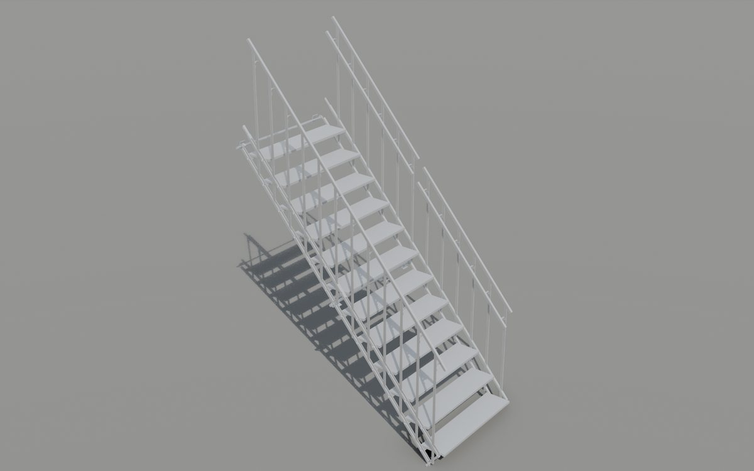
v2/datasheet/web/img/DOUBLE_STEEP.jpg
