calo-lategan/Staircase/v2/datasheet/web/img/final_base.jpg

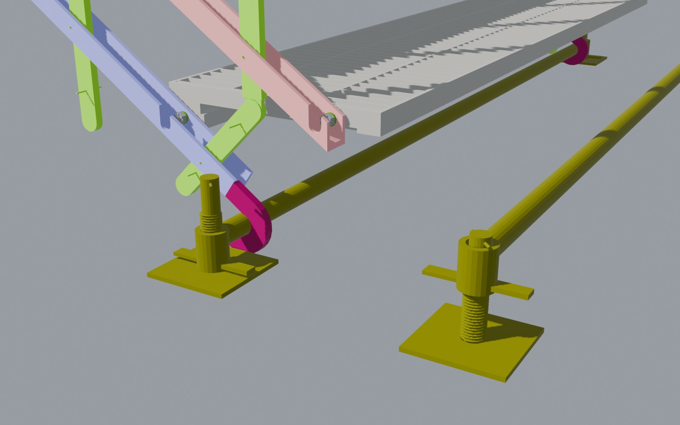
v2/datasheet/web/img/final_base.jpg
