calo-lategan/Staircase/v2/datasheet/web/img/final_hero.jpg

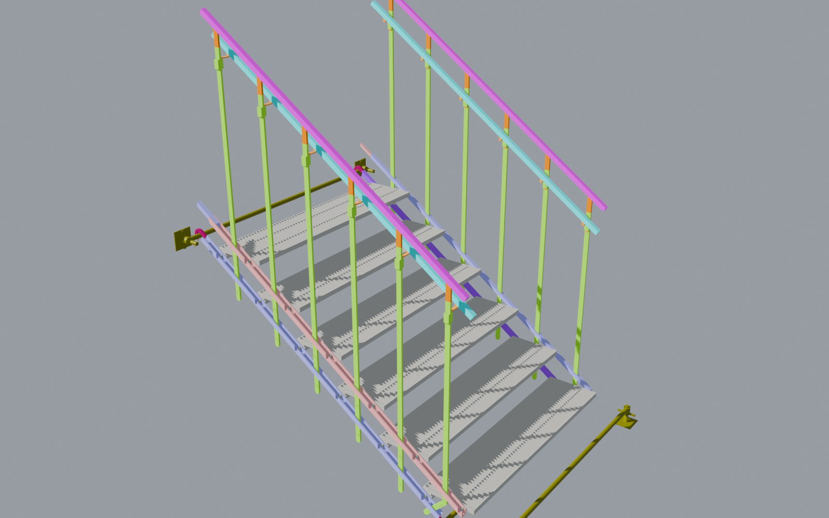
v2/datasheet/web/img/final_hero.jpg
