calo-lategan/Staircase/v2/datasheet/web/img/final_lock.jpg

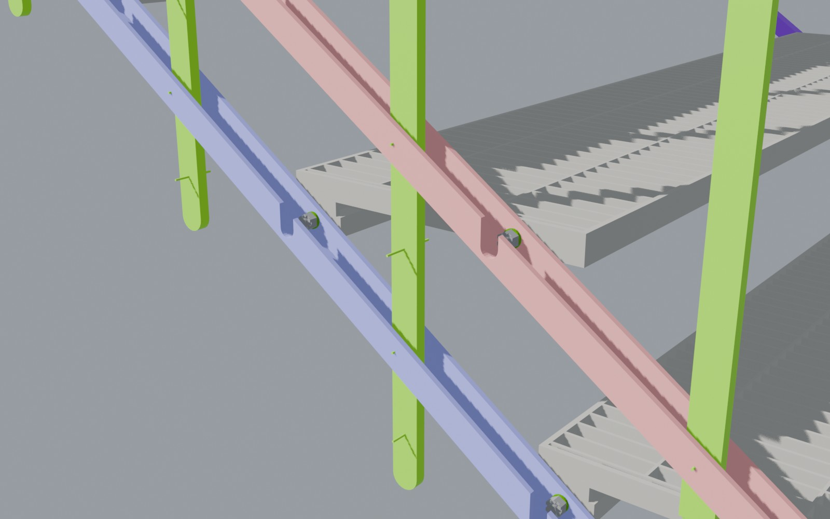
v2/datasheet/web/img/final_lock.jpg
