calo-lategan/Staircase/v2/datasheet/web/img/final_pole_top.jpg

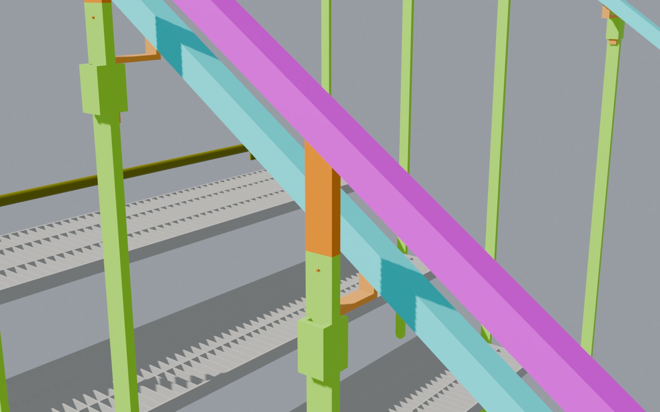
v2/datasheet/web/img/final_pole_top.jpg
