calo-lategan/Staircase/v2/datasheet/web/img/final_side.jpg

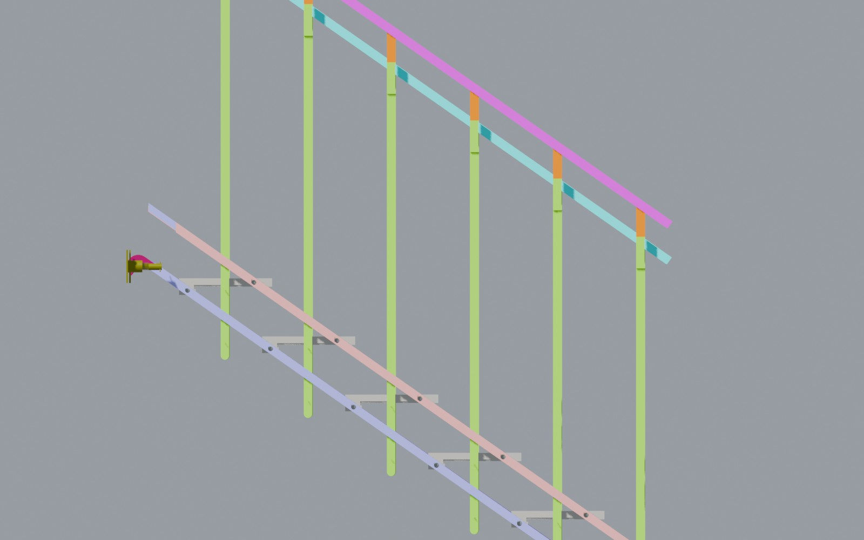
v2/datasheet/web/img/final_side.jpg
