calo-lategan/Staircase/v2/datasheet/web/img/final_tread_end.jpg

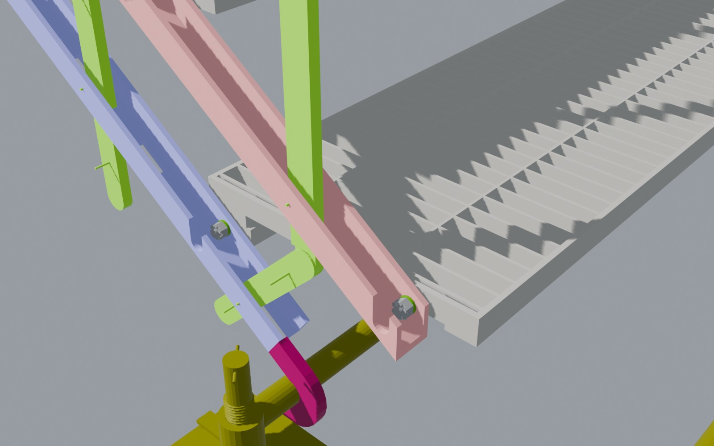
v2/datasheet/web/img/final_tread_end.jpg
