calo-lategan/Staircase/v2/datasheet/web/img/final_tread_under.jpg

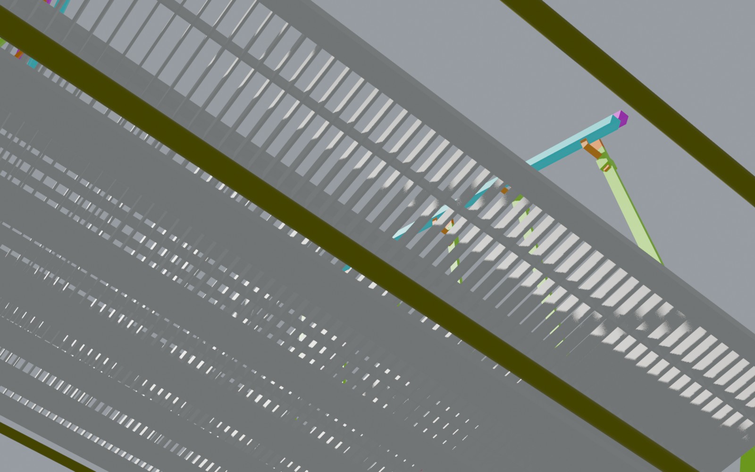
v2/datasheet/web/img/final_tread_under.jpg
