calo-lategan/Staircase/v2/datasheet/web/img/SINGLE_STANDARD.jpg

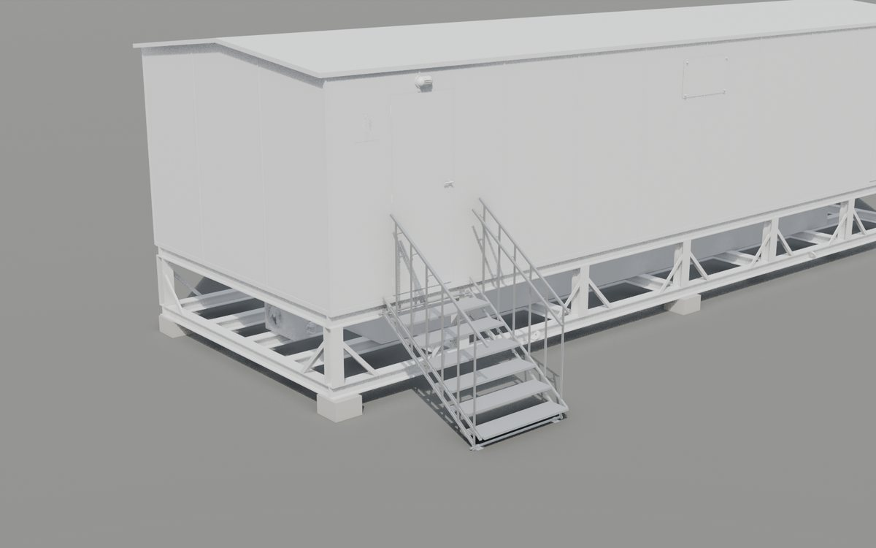
v2/datasheet/web/img/SINGLE_STANDARD.jpg
