calo-lategan/Staircase/v2/datasheet/web/img/WIDE_CATWALK_MINI.jpg

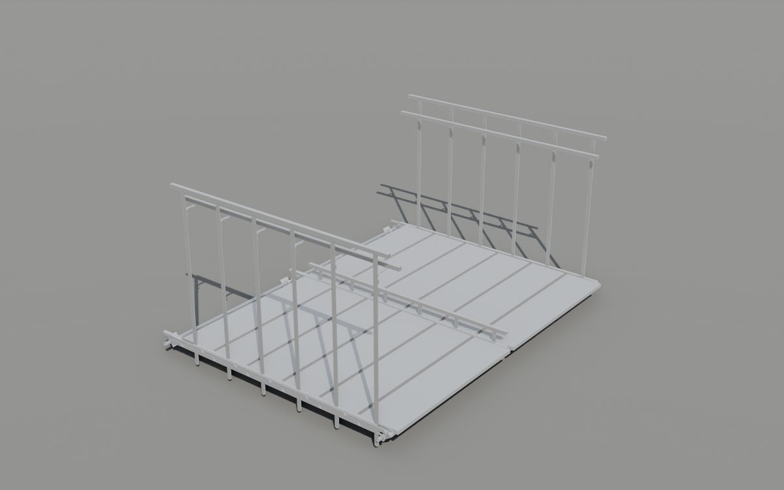
v2/datasheet/web/img/WIDE_CATWALK_MINI.jpg
