calo-lategan/Staircase/v2/final/atlas_sheet_05.png

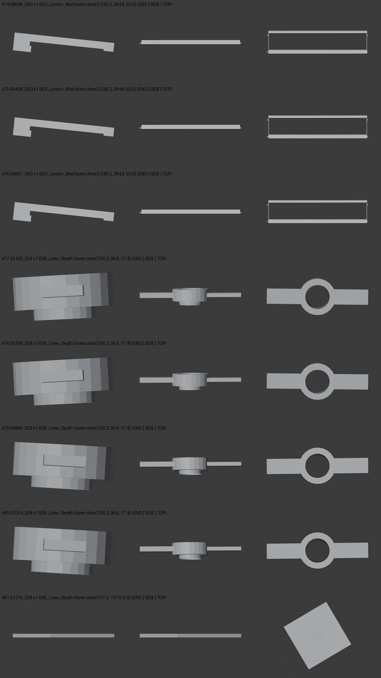
v2/final/atlas_sheet_05.png
