calo-lategan/Staircase/v2/final/atlas_sheet_09.png

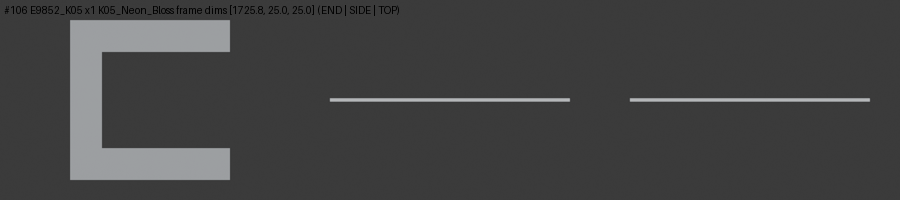
v2/final/atlas_sheet_09.png
