calo-lategan/Staircase/v2/final/png/t0_left_from_front.png

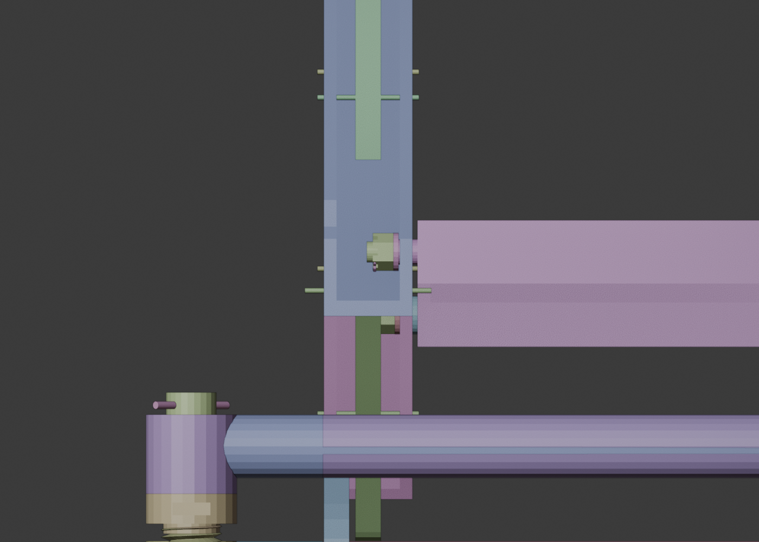
v2/final/png/t0_left_from_front.png
