calo-lategan/Staircase/v2/final/png/t0_mid_from_front.png

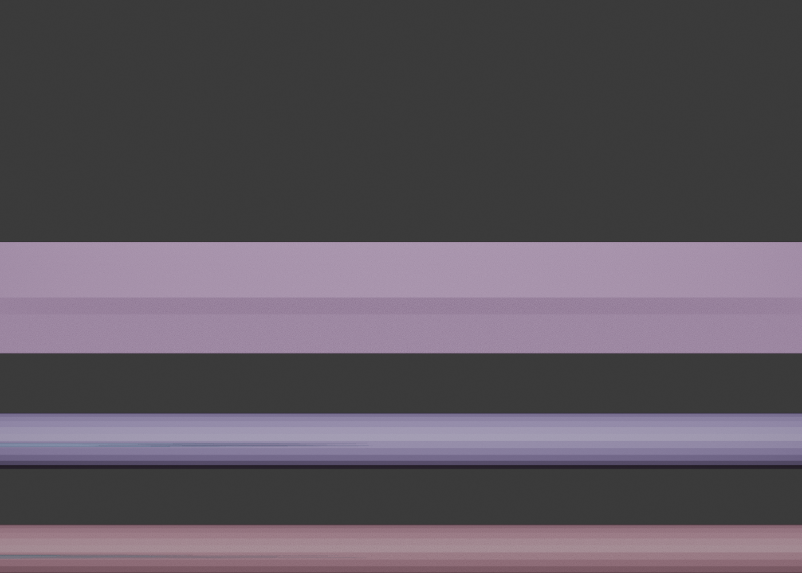
v2/final/png/t0_mid_from_front.png
