calo-lategan/Staircase/v2/final/png/t0_mid_iso.png

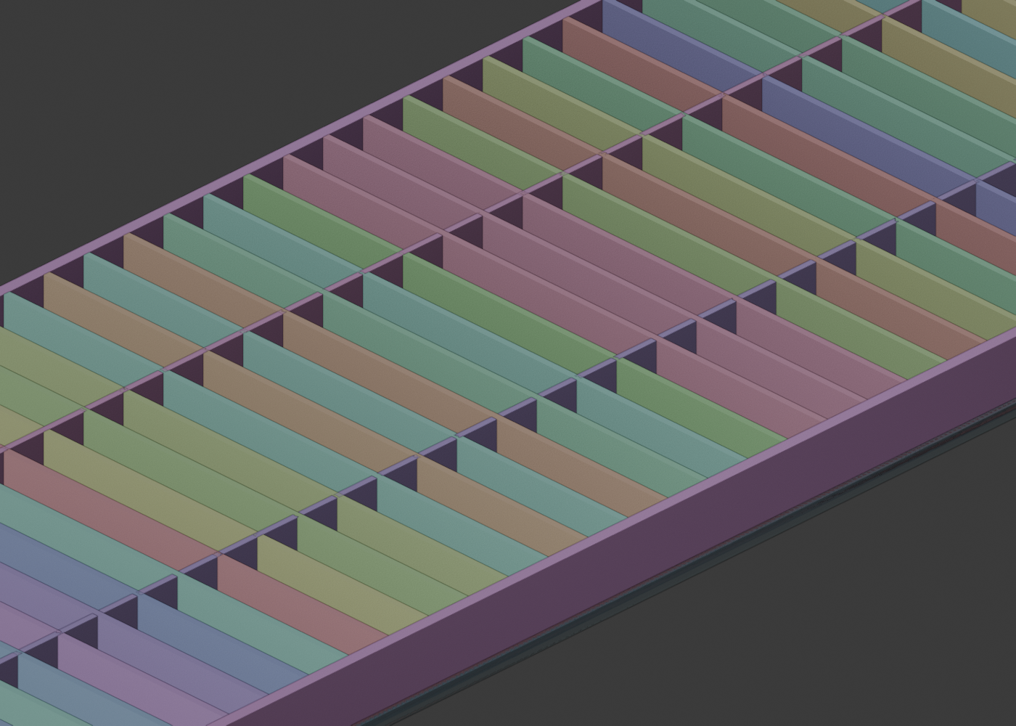
v2/final/png/t0_mid_iso.png
