calo-lategan/Staircase/v2/final/png/t0_plan_z30.png

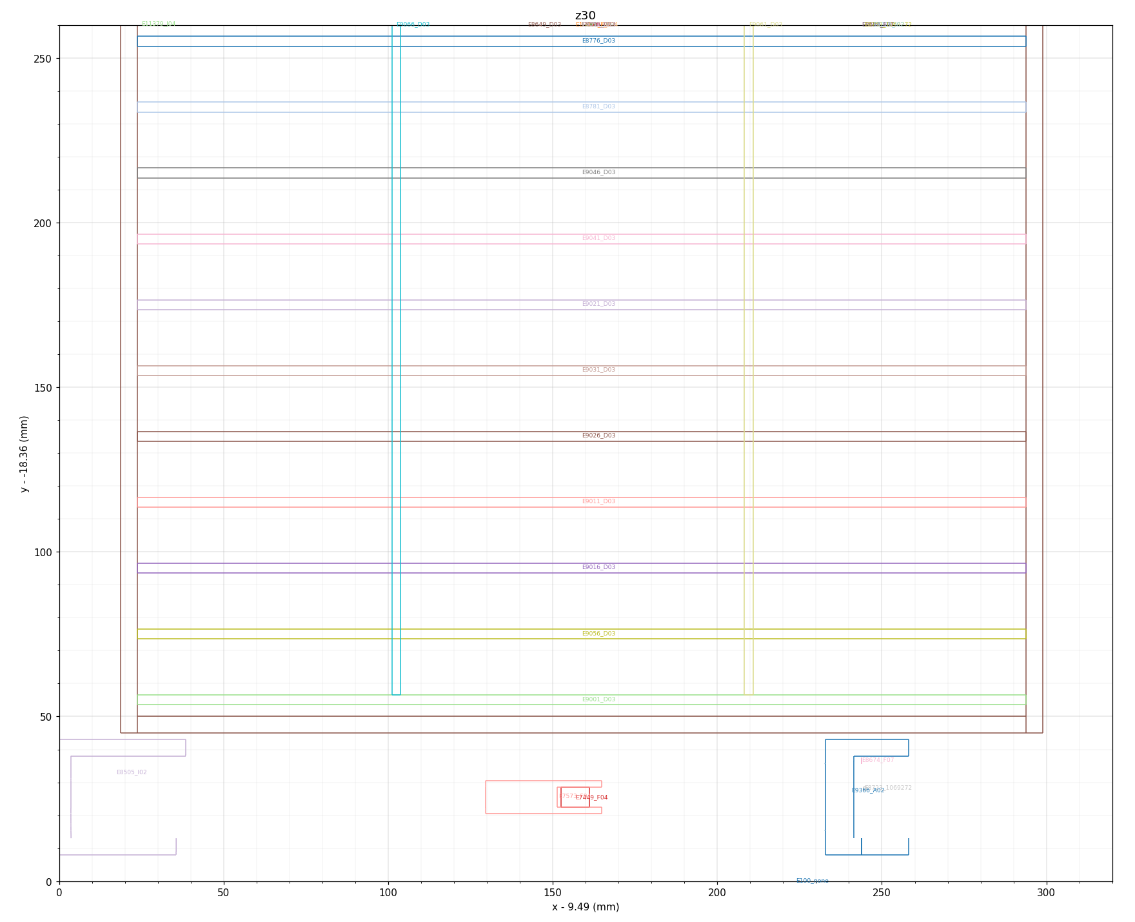
v2/final/png/t0_plan_z30.png
