calo-lategan/Staircase/v2/final/png/t0_plan_z040_R.png

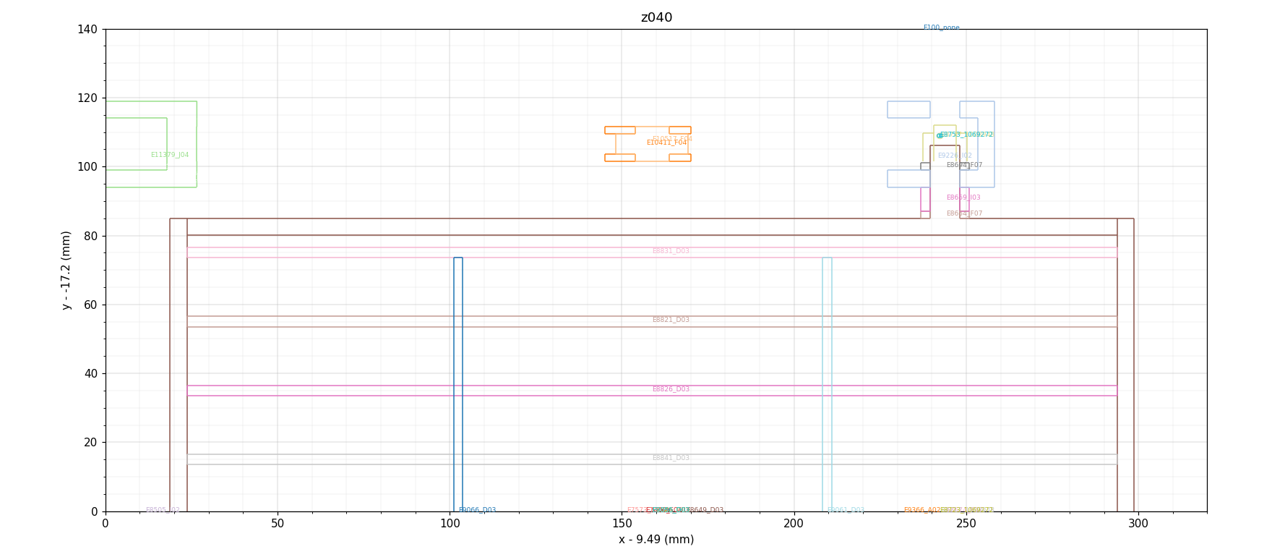
v2/final/png/t0_plan_z040_R.png
