calo-lategan/Staircase/v2/final/png/t0_plan_z52.png

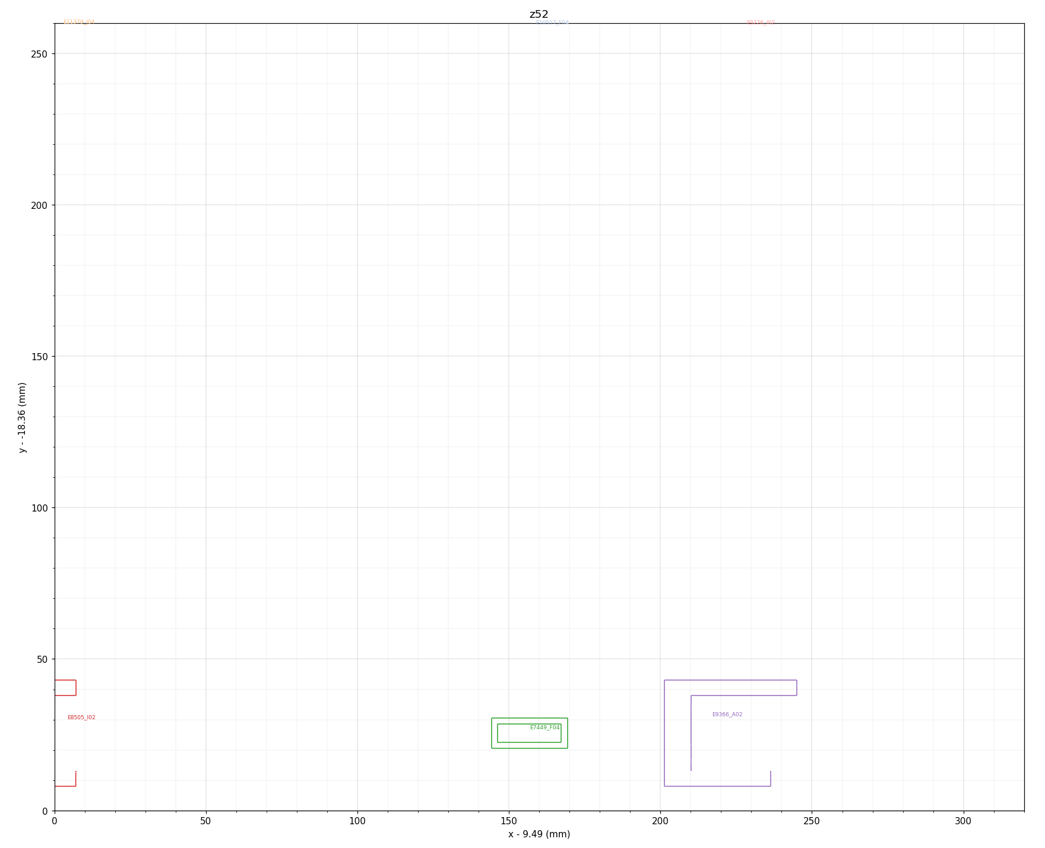
v2/final/png/t0_plan_z52.png
