calo-lategan/Staircase/v2/final/png/tm_E8505_I02_plan.png

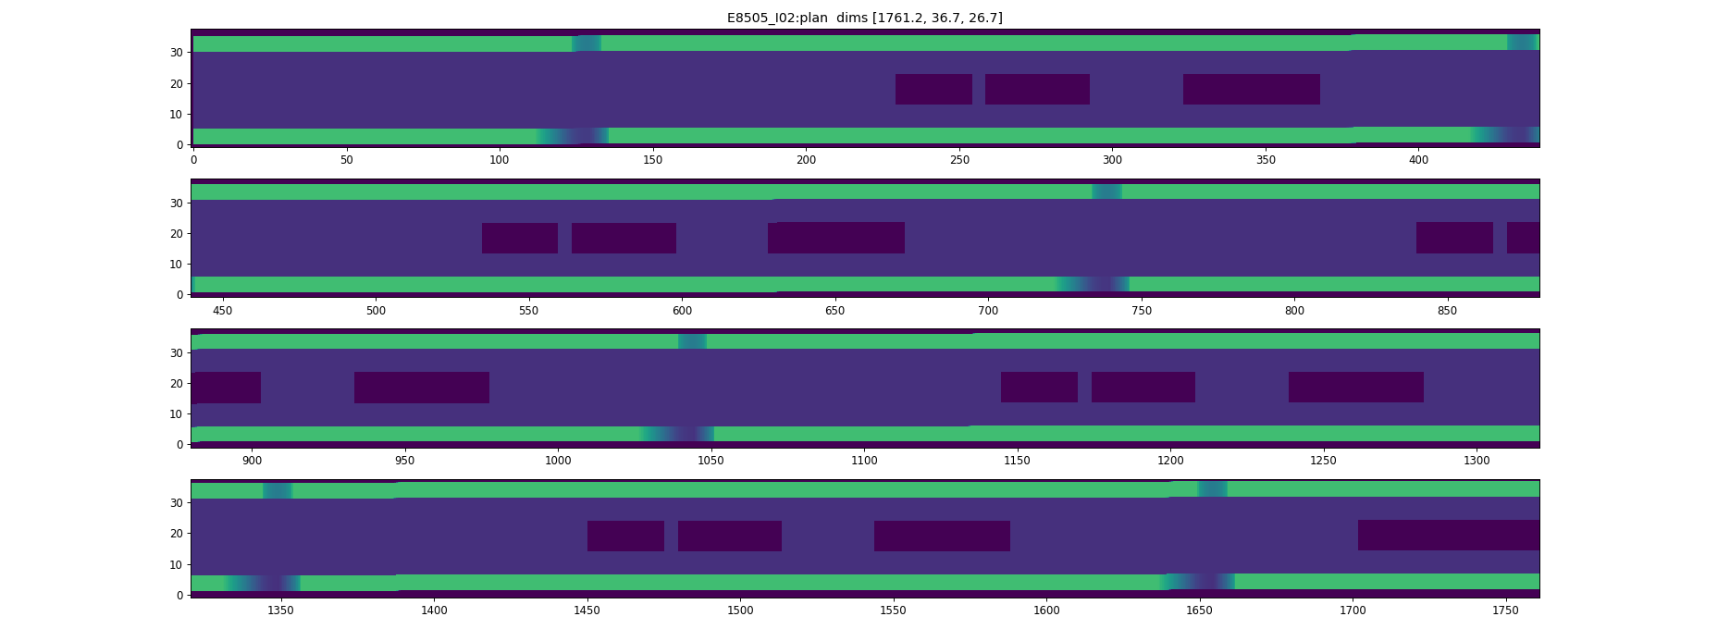
v2/final/png/tm_E8505_I02_plan.png
