calo-lategan/Staircase/v2/final/png/tm_E11379_J04_side.png

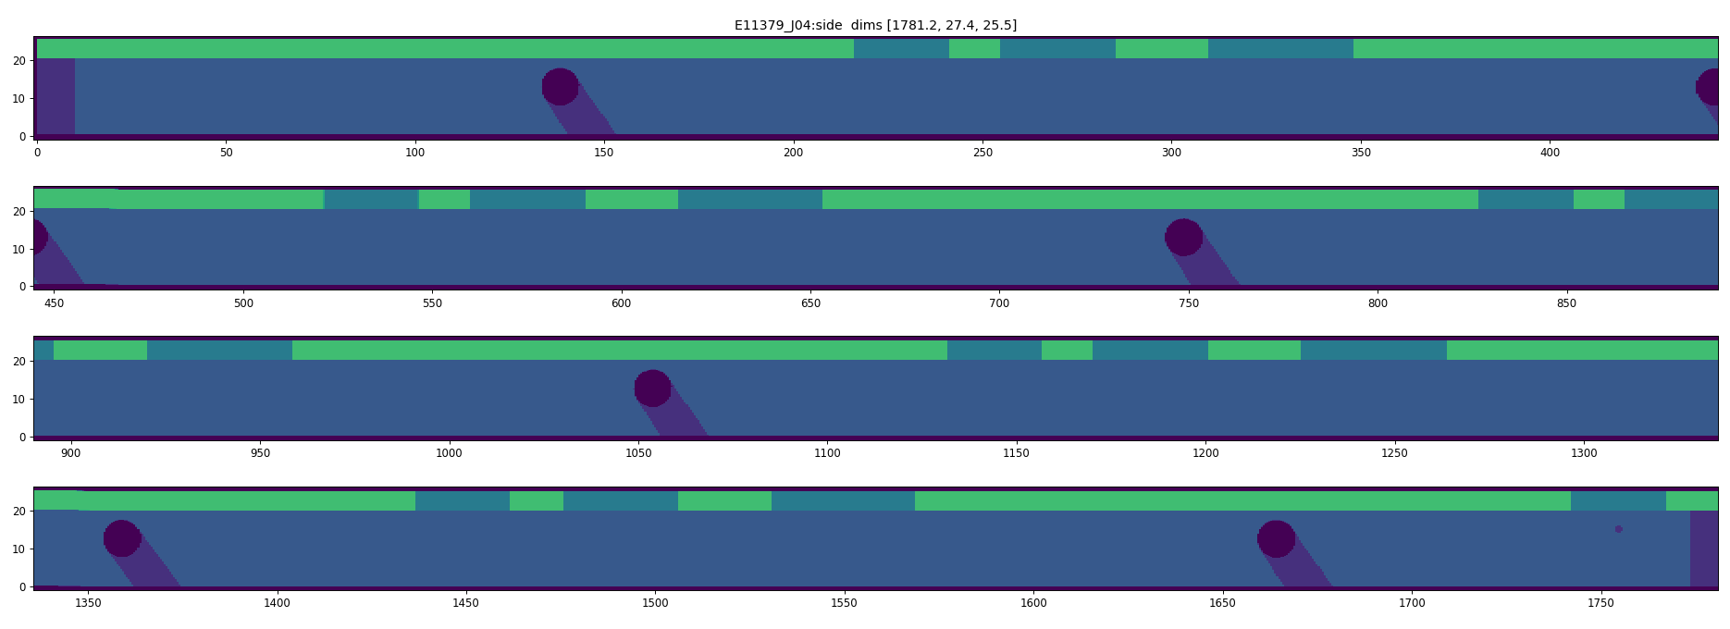
v2/final/png/tm_E11379_J04_side.png
