calo-lategan/Staircase/v2/loadtest/report/states/DOUBLE_CATWALK.png

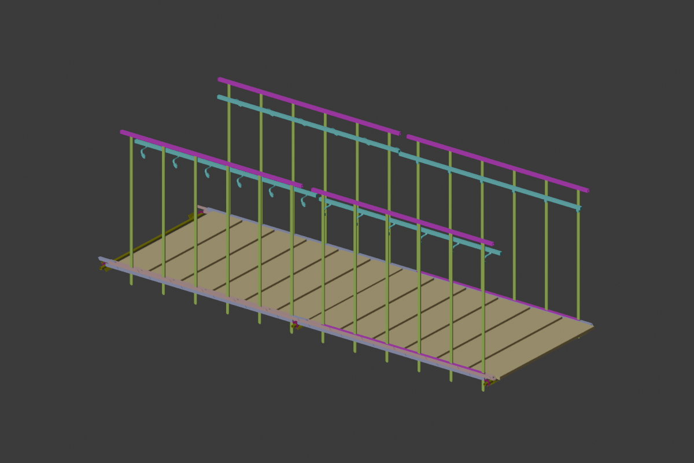
v2/loadtest/report/states/DOUBLE_CATWALK.png
