calo-lategan/Staircase/v2/loadtest/report/states/DOUBLE_STANDARD.png

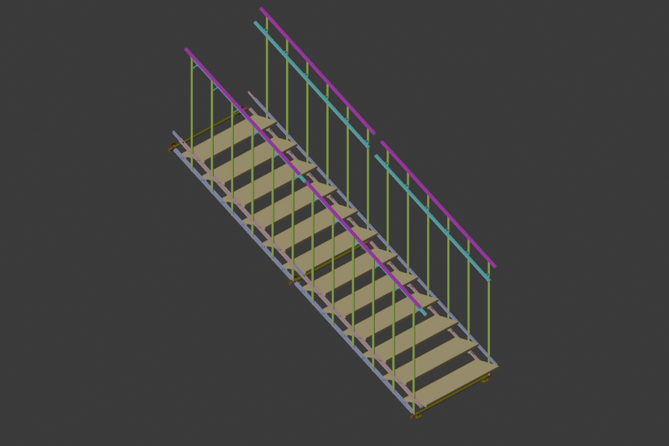
v2/loadtest/report/states/DOUBLE_STANDARD.png
