calo-lategan/Staircase/v2/loadtest/report/states/DOUBLE_STEEP.png

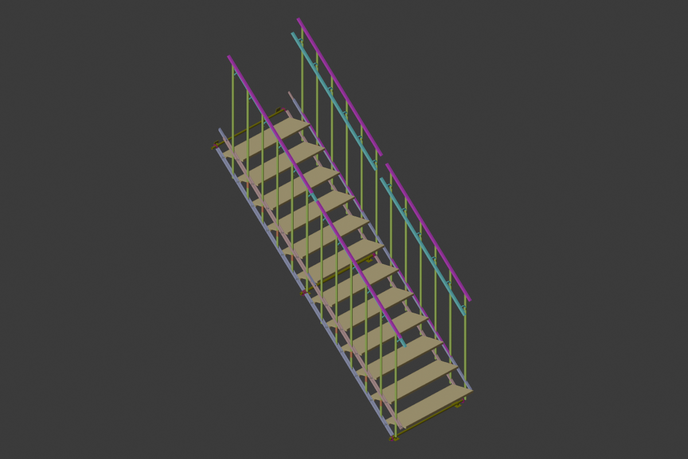
v2/loadtest/report/states/DOUBLE_STEEP.png
