calo-lategan/Staircase/v2/loadtest/report/states/SINGLE_BAR.png

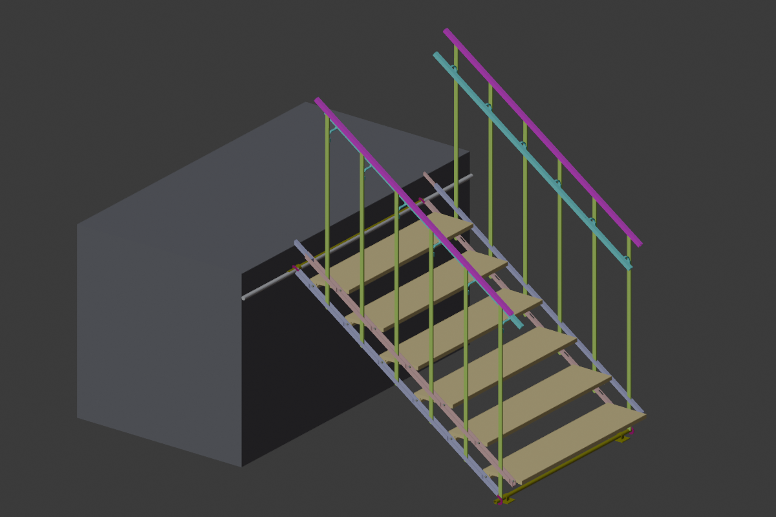
v2/loadtest/report/states/SINGLE_BAR.png
