calo-lategan/Staircase/v2/loadtest/report/states/SINGLE_CATWALK.png

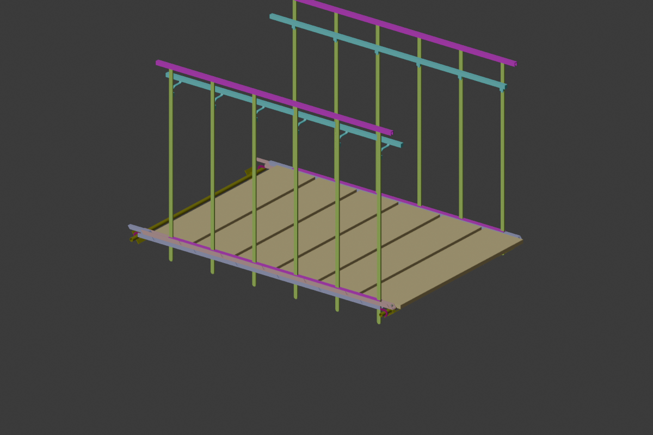
v2/loadtest/report/states/SINGLE_CATWALK.png
