calo-lategan/Staircase/v2/loadtest/report/states/SINGLE_STANDARD.png

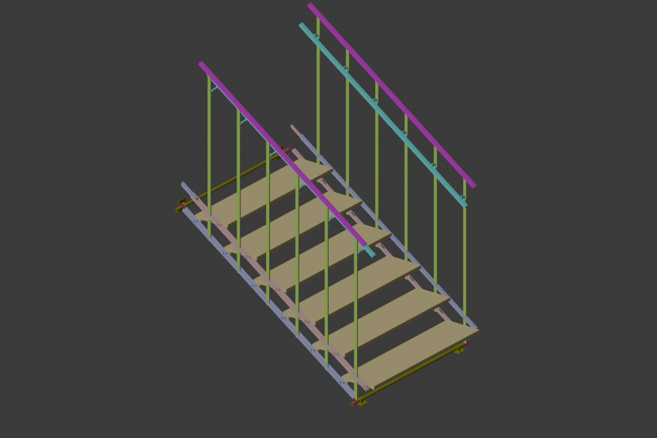
v2/loadtest/report/states/SINGLE_STANDARD.png
