calo-lategan/Staircase/v2/loadtest/report/states/WIDE_CATWALK_FULL.png

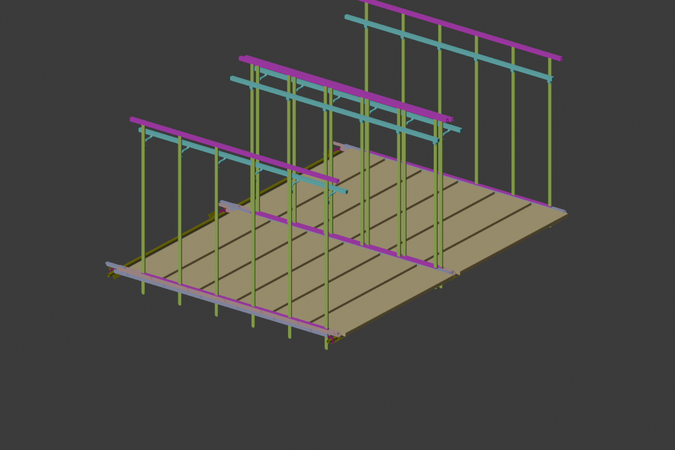
v2/loadtest/report/states/WIDE_CATWALK_FULL.png
