calo-lategan/Staircase/v2/loadtest/report/states/WIDE_CATWALK_MINI.png

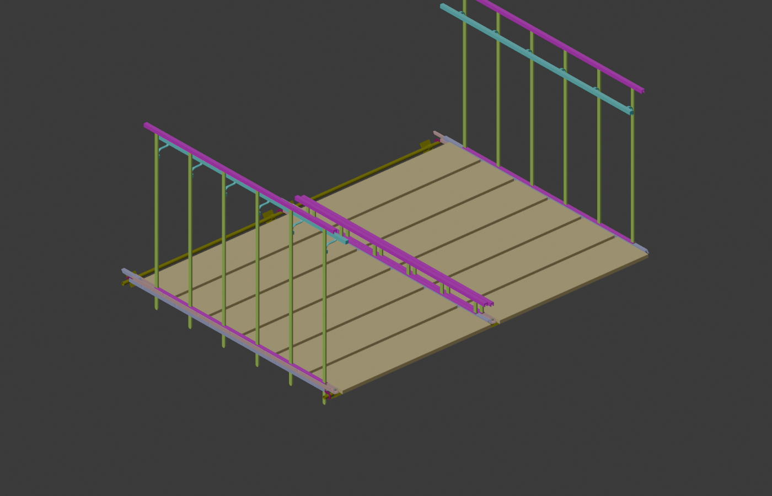
v2/loadtest/report/states/WIDE_CATWALK_MINI.png
