calo-lategan/Staircase/v2/loadtest/report/states/WIDE_STANDARD.png

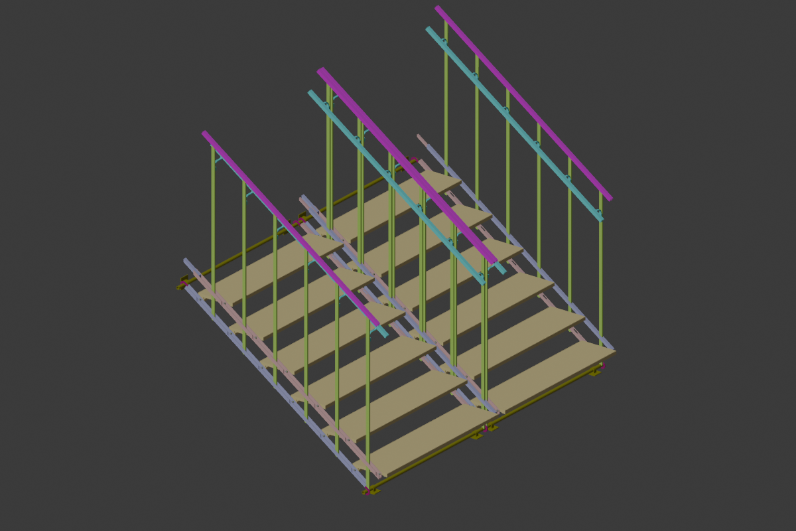
v2/loadtest/report/states/WIDE_STANDARD.png
