calo-lategan/Staircase/v2/loadtest/report/states/WIDE_STEEP.png

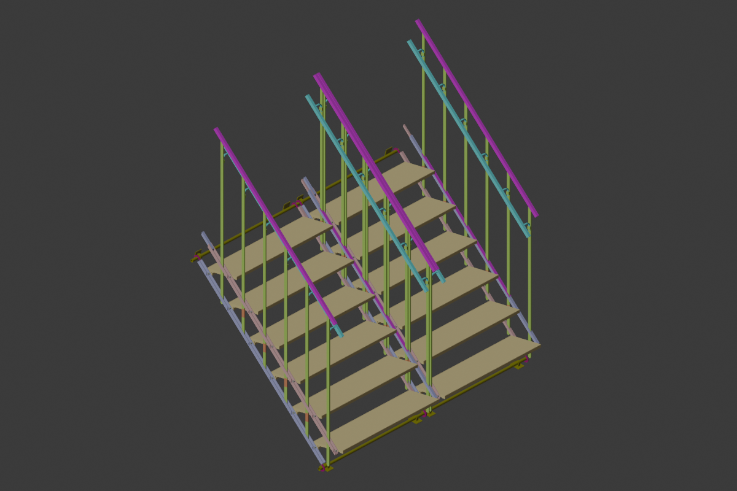
v2/loadtest/report/states/WIDE_STEEP.png
