calo-lategan/Staircase/v2/out/ifc_overview.png

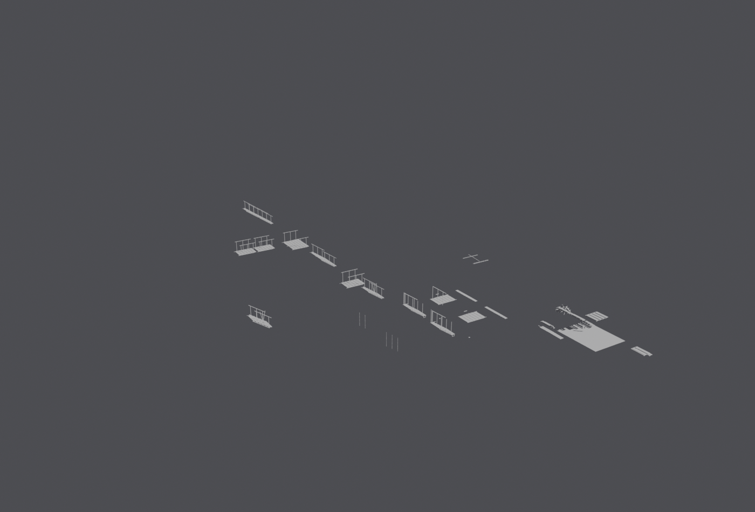
v2/out/ifc_overview.png
