calo-lategan/Staircase/v2/out/Latest 21-09-2026/states/story_0593.png

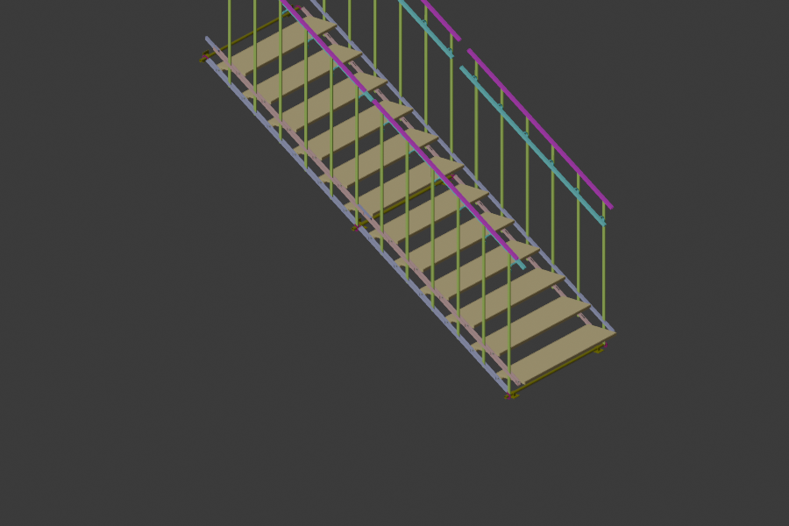
v2/out/Latest 21-09-2026/states/story_0593.png
