calo-lategan/Staircase/v2/out/v2_rig_ladder2.png

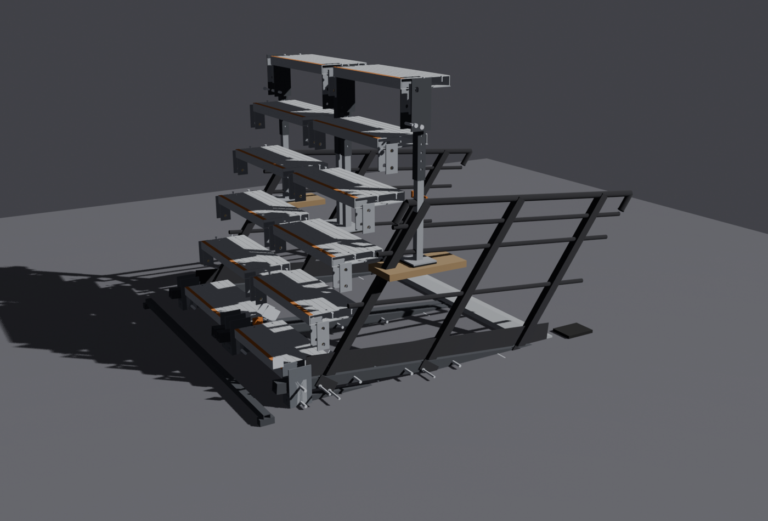
v2/out/v2_rig_ladder2.png
