calo-lategan/Staircase/v2/out/v2_rig_platform2.png

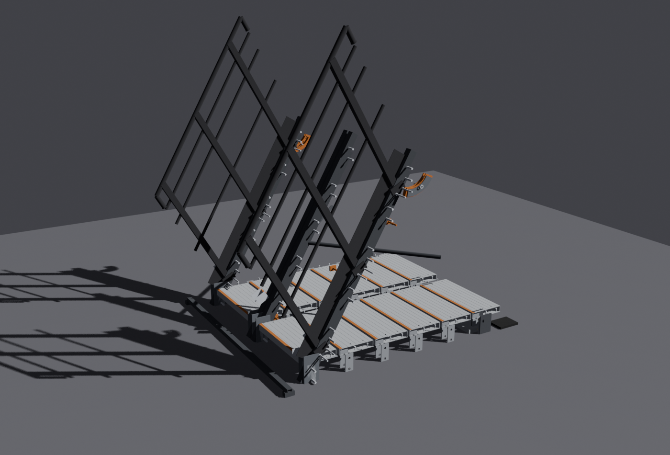
v2/out/v2_rig_platform2.png
