calo-lategan/Staircase/v2/revc/web/img/final_base.jpg

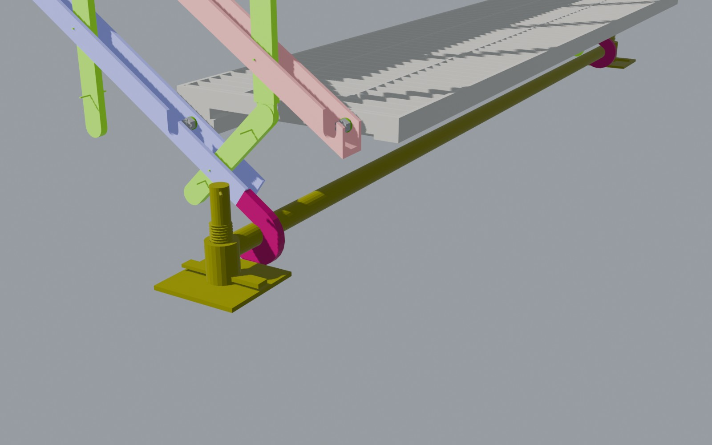
v2/revc/web/img/final_base.jpg
