calo-lategan/Staircase/v2/revc/web/img/final_tread_under.jpg

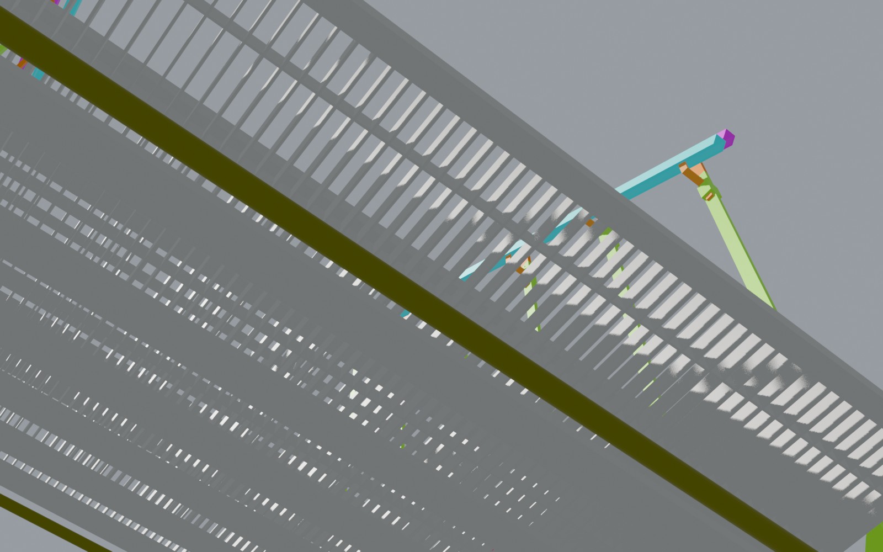
v2/revc/web/img/final_tread_under.jpg
