calo-lategan/Staircase/v2/story/_cabin_1.png

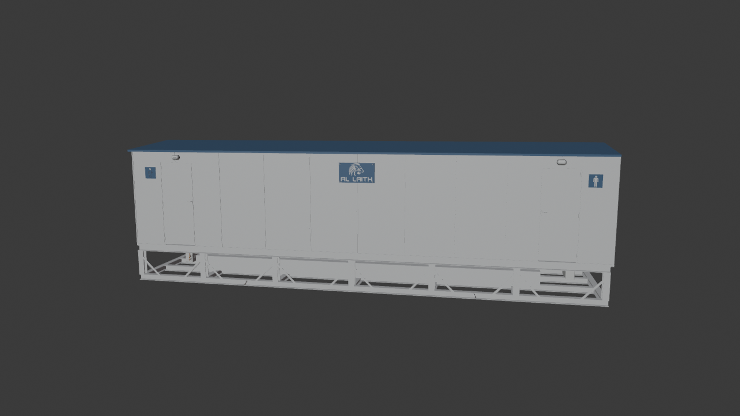
v2/story/_cabin_1.png
