calo-lategan/Staircase/v2/story/_chk5.png

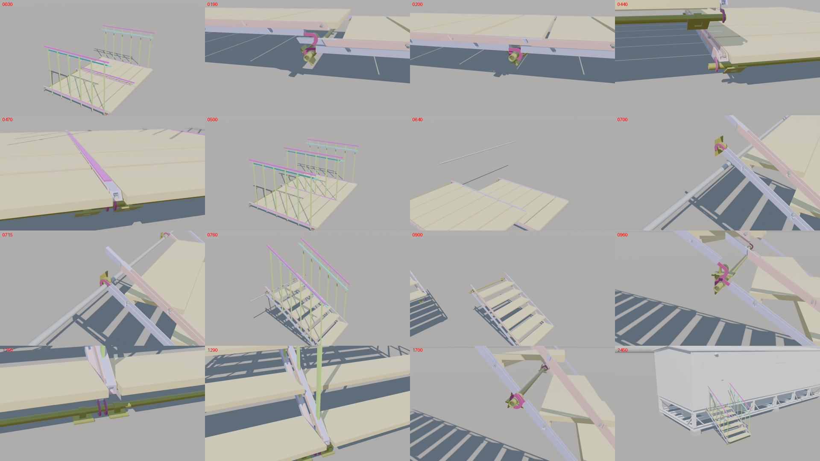
v2/story/_chk5.png
