calo-lategan/Staircase/v2/story/_chk6.png

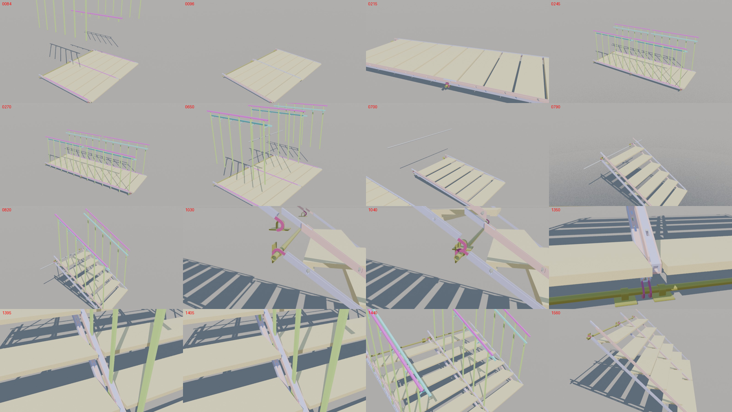
v2/story/_chk6.png
