calo-lategan/Staircase/v2/story/_rails2.png

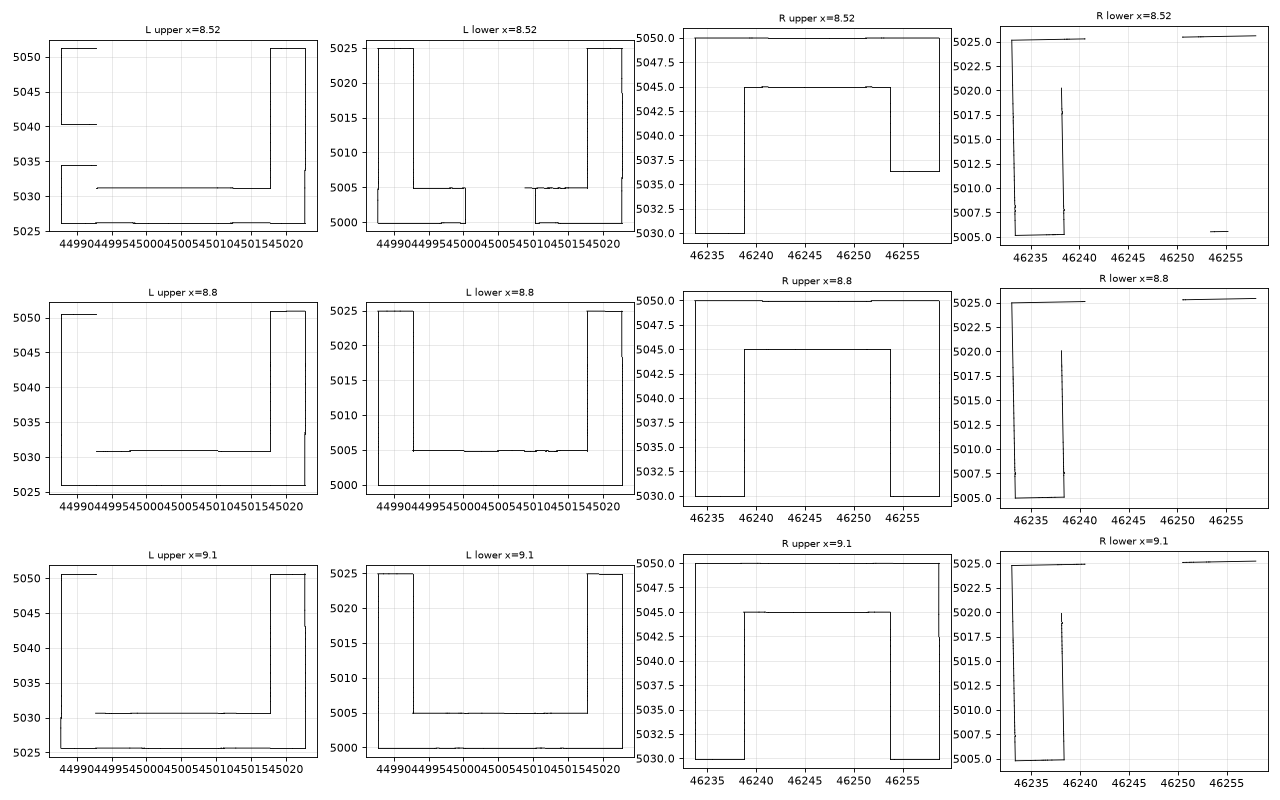
v2/story/_rails2.png
