calo-lategan/Staircase/v2/story/chk5/0030.jpg

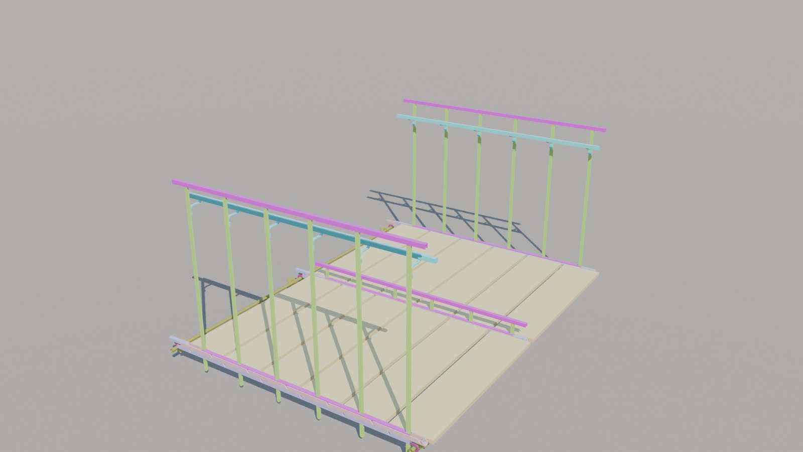
v2/story/chk5/0030.jpg
