calo-lategan/Staircase/v2/story/chk5/0440.jpg

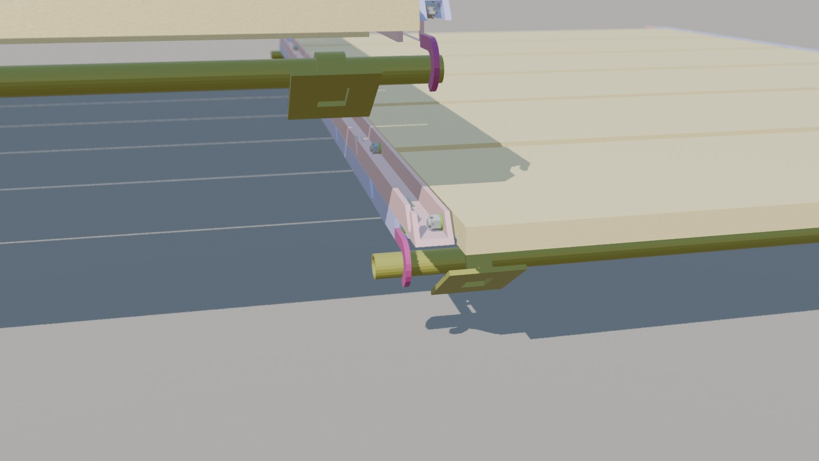
v2/story/chk5/0440.jpg
