calo-lategan/Staircase/v2/story/chk5/0715.jpg

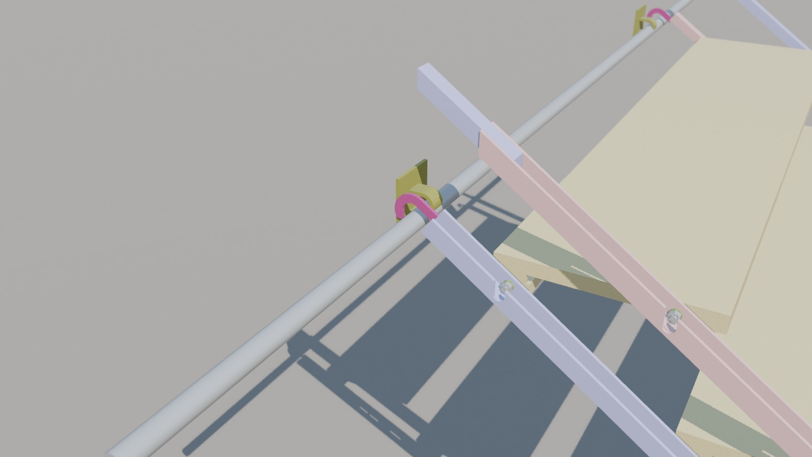
v2/story/chk5/0715.jpg
