calo-lategan/Staircase/v2/story/chk5/0760.jpg

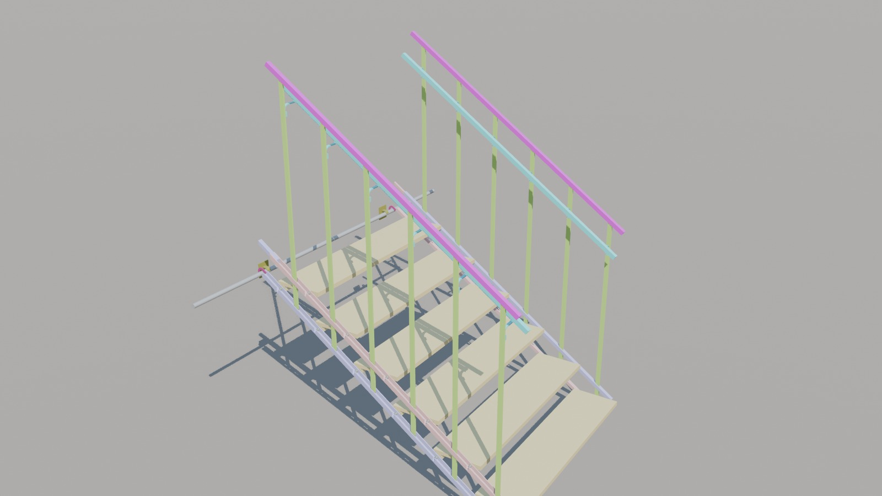
v2/story/chk5/0760.jpg
