calo-lategan/Staircase/v2/story/chk5/1250.jpg

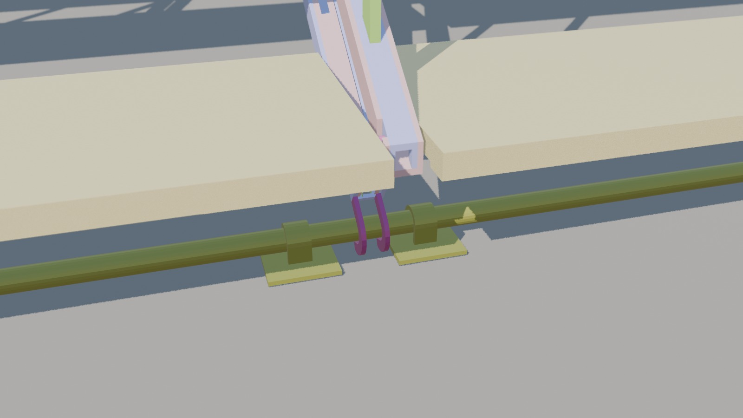
v2/story/chk5/1250.jpg
