calo-lategan/Staircase/v2/story/chk5/1700.jpg

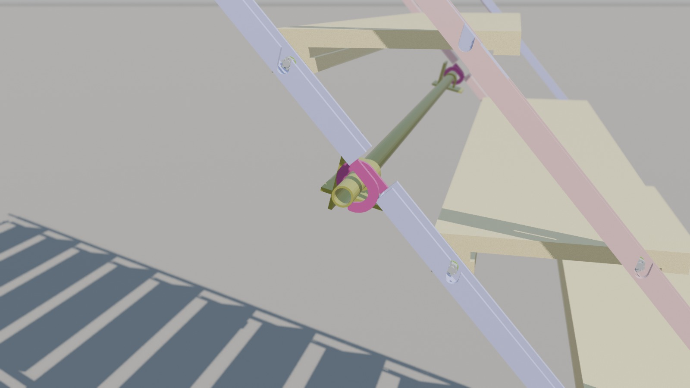
v2/story/chk5/1700.jpg
