calo-lategan/Staircase/v2/story/chk6/0245.jpg

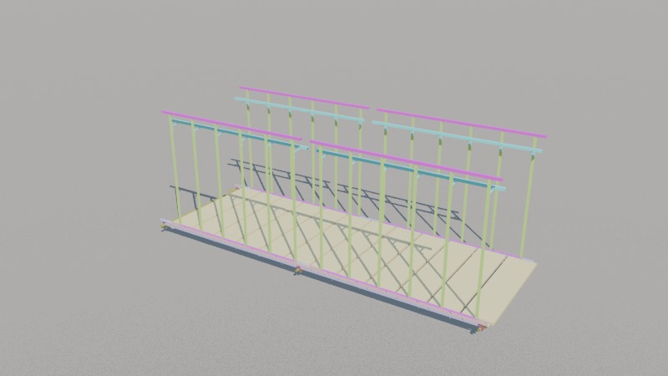
v2/story/chk6/0245.jpg
