calo-lategan/Staircase/v2/story/chk6/0790.jpg

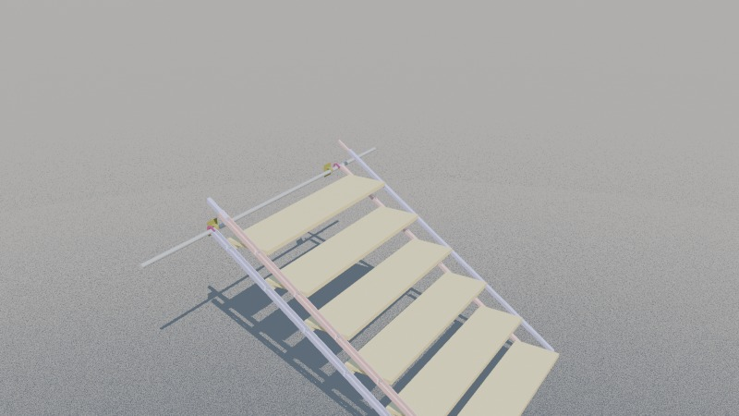
v2/story/chk6/0790.jpg
