calo-lategan/Staircase/v2/story/chk6/1030.jpg

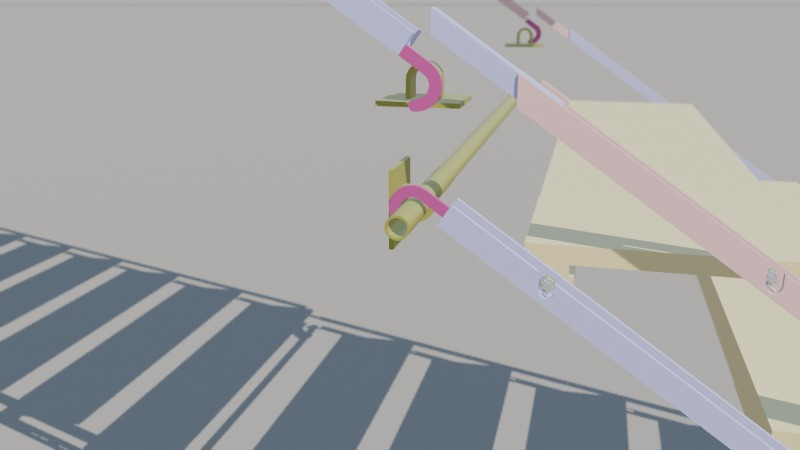
v2/story/chk6/1030.jpg
