calo-lategan/Staircase/v2/story/chk6/1350.jpg

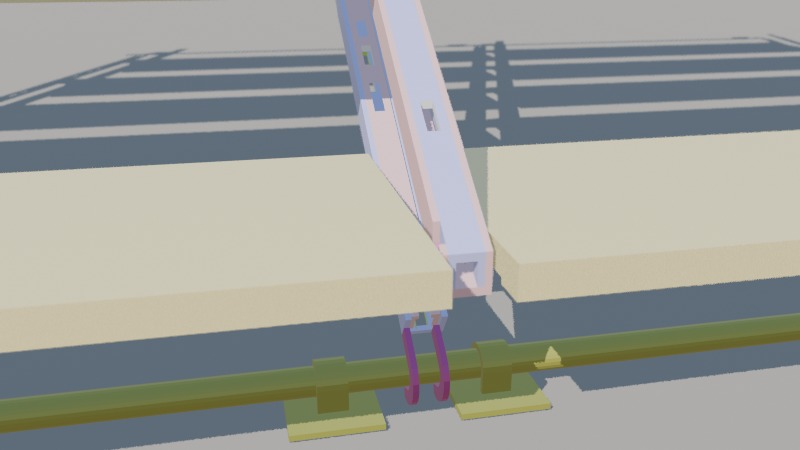
v2/story/chk6/1350.jpg
