calo-lategan/Staircase/v2/out/SS_staircase_v2_fabrication_pack.xlsx

Sheet: Cutting List
Item | Qty | Material | Stock / section | Cut length (mm) | Width (mm) | Thk (mm) | Machining / ops | EN ref / audit
Ball-lock pin Ø12 (secondary) | 4 | A4-80 stainless | Ø12 A4-80 QR pin | 70 | 12 | 12 | through both cheeks + stringer boss at detent; SS lanyard; independent lock | G105 [3]
Ballast/anchor lug | 4 | S355J2H SHS/plate, hot-dip galv EN ISO 1461 + black powder (duplex) | PL 8 | 90 | 52 | 8 | Ø18 slot; kentledge 1400 kg OR ground anchors | L40 [0]
Base pivot bracket | 4 | S355J2H SHS/plate, hot-dip galv EN ISO 1461 + black powder (duplex) | PL 8 + PL 12 | 330 | 130 | 8 | main bore = VERTICAL SLOT Ø20+10 (J-lock float); ctl bore Ø20 H7; EXC2 | EN 12811-1/1090-2
Bolt M12x110 8.8 HDG + nut | 12 | 8.8 HDG | ISO 4014/4032 | 110 | 18 | 12 | saddle through-pair | L33 [14]
Bolt M8x25 csk A4 (pair ends) | 48 | A4-80 | ISO 10642 | 25 | 13 | 8 | tread to carrier seats | L5
Bridge bearing pad | 4 | EPDM 60ShA | 200x150x20 | 200 | 150 | 20 | slotted (sliding) fixing one end = thermal joint | G87 [29]
Carrier (twin cheek) | 24 | S355J2H SHS/plate, hot-dip galv EN ISO 1461 + black powder (duplex) | PL 8 x2 + PL 4 | 155 | 70 | 8 | 2x Ø20 H7 (lower slotted ±0.8 exc. node-3 master); 2x Ø9 csk; cheeks astride stringer | EN 12811-1
Contrast nosing strip | 12 | PA/alu hi-vis | snap strip 24x2 | 860.0 | 24 | 2 | snap-in front edge, rounded | G18 [30]
Control bar | 4 | S355J2H SHS/plate, hot-dip galv EN ISO 1461 + black powder (duplex) | SHS 40x40x4 | 1770.9 | 40 | 40 | 6x Ø20 H7 line-reamed | EN 12811-1 [12]
DU bush 20/16.1x20 | 40 | Steel-backed PTFE composite (DU) + isolating washers | Ø20 DU bush | 20 | 20 | 20 | press in welded boss; isolating washers | L61 [11]
Diagonal brace CHS33.7 | 1 | S355J2H SHS/plate, hot-dip galv EN ISO 1461 + black powder (duplex) | CHS 33.7x2.6 | 1450 | 34 | 2.6 | flattened ends Ø16 pin holes + bushes | G78 [0]
Diagonal brace CHS33.7 | 1 | S355J2H SHS/plate, hot-dip galv EN ISO 1461 + black powder (duplex) | CHS 33.7x2.6 | 1450 | 34 | 2.6 | flattened ends Ø16 pin holes + bushes; per bay free-standing | G78 [0]
EN 131-3 pictogram plate | 1 | alu 1.5 printed | 60x60 | 60 | 60 | 1.5 | ladder-mode base end | G98 [27]
End guardrail panel | 2 | S355J2H SHS/plate, hot-dip galv EN ISO 1461 + black powder (duplex) | SHS 40x4 + CHS26.9 | 1100 | 1700 | 40 | demountable drop-in; rails at 467/783/1100 + toe; sockets on stringer ends | G56/70 [7]
Follower pin Ø16 | 4 | A4-80 stainless | Ø16 h9 bar | 112 | 16 | 16 | through stringer + both cheeks; circlips + R-clip; DOUBLE SHEAR primary lock | L61 [1]
Guardrail post + saddle | 6 | S355J2H SHS/plate, hot-dip galv EN ISO 1461 + black powder (duplex) | SHS 50x50x5 + PL6 saddle | 1072.0 | 50 | 50 | wrap saddle both webs; 2x M12 8.8 pairs lever>=100 [14] | L33/34
Guide cover strip | 4 | S355J2H SHS/plate, hot-dip galv EN ISO 1461 + black powder (duplex) | PL 3 laser | 410 | 50 | 3 | M6x12 @100 crs into outer cheek (finger-guard, G96) | G96 [9]
Handhold extension (ladder) | 2 | S355J2H SHS/plate, hot-dip galv EN ISO 1461 + black powder (duplex) | CHS 40x3 | 1100.0 | 40 | 3 | clip sockets on top post; >=1000 above step-off | G30 [19]
Index plunger Ø12 | 4 | A4-80 stainless | GN 617 type | 44 | 12 | 12 | INDEXING ONLY (not load path); lanyard tab | G105
Leg slider + footplate | 4 | S355J2H SHS/plate, hot-dip galv EN ISO 1461 + black powder (duplex) | SHS 40x40x4 + PL8 | 900.0 | 150 | 150 | engagement >=300 at full ext; datum groove for 165 bottom-rise gauge [18] | G74/75
Leg socket | 4 | S355J2H SHS/plate, hot-dip galv EN ISO 1461 + black powder (duplex) | SHS 50x50x4 | 420 | 50 | 50 | 6x Ø13 @50 | G75
Lifting lug | 4 | S355J2H SHS/plate, hot-dip galv EN ISO 1461 + black powder (duplex) | PL 8 | 80 | 70 | 8 | Ø18 shackle hole; rated w/ dyn factor | L62 [25]
Mesh infill panel | 2 | S355J2H SHS/plate, hot-dip galv EN ISO 1461 + black powder (duplex) | welded mesh 3mm/90ap + PL3 frame | 991 | 700 | 3 | clip-in; aperture <=100 (public/event) | G8/59/71 [6]
Mid rail 1 CHS26.9 | 2 | S355J2H SHS/plate, hot-dip galv EN ISO 1461 + black powder (duplex) | CHS 26.9x2.6 | 1681 | 40 | 3 | returned ends [26]; ext>=300 (G20); 950 rail = ramp config | G64-69/G47
Mid rail 2 CHS26.9 | 2 | S355J2H SHS/plate, hot-dip galv EN ISO 1461 + black powder (duplex) | CHS 26.9x2.6 | 1681 | 40 | 3 | returned ends [26]; ext>=300 (G20); 950 rail = ramp config | G64-69/G47
Module coupler (spigot+cam) | 3 | S355J2H SHS/plate, hot-dip galv EN ISO 1461 + black powder (duplex) | machined + Ø16 spigot h9 | 70 | 76 | 44 | Ø16 H11/h9 fit -> lip<=1; over-centre cam latch; 15deg nosing chamfers -> gap<=8 (G96) | G104/106 [15]
Pivot pin Ø16 | 40 | A4-80 stainless | Ø16 h9 bar | 100 | 16 | 16 | circlip grooves DIN 471 + R-clip retainer | L61
Pivot pin Ø16 (base ctl) | 4 | A4-80 stainless | Ø16 h9 bar | 100 | 16 | 16 | circlips+R-clip | L61
Pivot pin Ø16 (base main) | 4 | A4-80 stainless | Ø16 h9 bar | 100 | 16 | 16 | in vertical float slot; circlips+R-clip | L61
Rail return + end cap | 4 | S355J2H SHS/plate, hot-dip galv EN ISO 1461 + black powder (duplex) | CHS 40x3 bend | 120 | 40 | 3 | 90deg return into post + domed cap, no snag (G72) | G72 [26]
Ramp overlay threshold | 2 | EN AW-6082-T6 serrated plank extrusion (web pitch <=50) | PL 6 folded chamfer | 220 | 1700 | 36 | hooks tread nosing; <=15mm chamfered lip (G84); REQUIRED for ramp detents | G38/84 [10]
Ramp rail 950 CHS26.9 (clip-on) | 2 | S355J2H SHS/plate, hot-dip galv EN ISO 1461 + black powder (duplex) | CHS 26.9x2.6 | 1681 | 40 | 3 | returned ends [26]; ext>=300 (G20); 950 rail = ramp config | G64-69/G47
Rating plate | 4 | SS 1.4301 | PL 1.5 etched | 100 | 75 | 1.5 | class 6 / 7.5 kN/m2 / modes+detents / ballast rule / EN refs / ID / date; 4x Ø3.2 rivets | G94
Rubber foot pad | 4 | NBR 70ShA | PL 10 rubber | 150 | 150 | 10 | bonded + 4x M5 csk retained | G34/L14 [23]
Self-closing gate | 1 | S355J2H SHS/plate, hot-dip galv EN ISO 1461 + black powder (duplex) | SHS 40x4 frame | 980 | 700 | 40 | double torsion-spring hinges; inward opening; hooks std posts | G21 [8]
Sole board | 2 | C24 timber | 500x225x38 | 500 | 225 | 38 | locating studs for footplate | G77 [24]
Stabiliser crossbar | 1 | S355J2H SHS/plate, hot-dip galv EN ISO 1461 + black powder (duplex) | SHS 40x40x4 | 2000.0 | 40 | 40 | pins to base brackets Ø16; rubber swivel feet; REQUIRED ladder mode >=3m | G27 [22]
Stringer | 4 | S355J2H SHS/plate, hot-dip galv EN ISO 1461 + black powder (duplex) | SHS 60x60x5 | 1910.9 | 60 | 60 | 6x Ø20 H7 line-reamed; 1x Ø16.1; ends mitre 30.0deg; EXC2 | EN 12811-1/1993 L26
Toe board FB150x3 | 2 | EN AW-6082-T6 serrated plank extrusion (web pitch <=50) | FB 150x3 alu | 1681 | 40 | 3 | returned ends [26]; ext>=300 (G20); 950 rail = ramp config | G64-69/G47
Top grip rail CHS40x3 | 2 | S355J2H SHS/plate, hot-dip galv EN ISO 1461 + black powder (duplex) | CHS 40x3 | 1681 | 40 | 3 | returned ends [26]; ext>=300 (G20); 950 rail = ramp config | G64-69/G47
Tread plank | 12 | EN AW-6082-T6 serrated plank extrusion (web pitch <=50) | plank 308x55x3 (web pitch 45) | 860.0 | 308.0 | 55.0 | 4x Ø9 csk; serrated (R11); web pitch<=50 [13] | G4-7/L26
U-guide cheek (inner) | 4 | S355J2H SHS/plate, hot-dip galv EN ISO 1461 + black powder (duplex) | PL 8 laser | 440 | 440 | 8 | arc slot R180x16.5 0-65deg + END STOP 69; 5x J-branch 16.5w x 30 deep SQUARE +2.5deg undercut; 5x Ø12.2 | G105/G96 [1][2]
U-guide cheek (outer) | 4 | S355J2H SHS/plate, hot-dip galv EN ISO 1461 + black powder (duplex) | PL 8 laser | 440 | 440 | 8 | identical to inner cheek; 25 spacer bosses | G105/G96

Sheet: Compliance Checks
REF CHECK VALUE RESULT
------------------------------------------------------------------------------
G5 going 175..300 (2h+g cap) 286 mm PASS
G6 rise 165..~205 (Class B) 165 mm PASS
G9 2h+g 540..660 (~600) 616 mm PASS
G10 stair pitch 20..33 deg (public) 29.98 deg PASS
G11 flight rise <=3000 990 mm PASS
G14 risers 3..18 6 PASS
G13 uniformity +/-5 (linkage-exact) 0 mm var PASS
G13 FIRST rise ground->tread0 uniform 165.0 mm PASS
G109 flush deck: ctl bar UNDER slung -90 mm PASS
- ctl ground pivot clears ground z=19.5 PASS
G7/18 nosing overlap 10..25 (t15) 22 mm PASS
G49 deck gap at flat <=25 22.2 mm PASS
G104 module lip <=4 / gap <=25 4 mm PASS
G4 clear width (target 1500) 1500 mm PASS
G4/23 half width stair>=500 ladder>=400 750 mm PASS
G22 rung spacing 225..300 299.2 mm PASS
G26 ladder pitch 65..75 65.0 deg PASS
G29 rung uniformity +/-2 (linkage-exact) 0 mm var PASS
G24 rung depth >=30 (D) 308 mm PASS
G38 public ramp <=4.76 deg 4.76 deg PASS
G38 industrial ramp <=20 deg 20.0 deg PASS
G40 kerb >=100 150 mm PASS
G64 top rail 1100 (event) 1100 mm PASS
G65 grip dia 25..50 (t40) 40 mm PASS
G66/69 all rail gaps <=470 max 317 mm PASS
G67 toe board >=150 (event) 150 mm PASS
G20 rail extension >=300 300 mm PASS
G107 post spacing <=2500 572 mm PASS
G71/8/59 public infill aperture <=100 (mesh) 90 mm PASS
G47 ramp-mode rail 900..1000 (clip-on) 950 mm clip rail PASS
G30 ladder handhold ext >=1000 1100 mm PASS
G27 ladder stabiliser width 2000 mm PASS
G74 footplate >=150x150 150 sq PASS
G75 jack ext <=600 & >=1/3 engaged 600/900 PASS
G55 height:base <=3:1 0.69:1 PASS
L4/44 PRIMARY lock: follower J-slot double shear 28.2/154 kN PASS
G105 SECONDARY lock independent (ball-lock) 28.2/87 kN PASS
G105 branch slot engagement >= 1.0 x pin dia 30 mm PASS
G105 square shoulder + undercut (no cam-out) 2.5 deg PASS
G96 arc slot enclosed by cover strip 3 mm cover PASS
G96 working arc hard end stop (no 90 pocket) stop @69 deg PASS
L7/40 overturning FoS >= 1.5 (with ballast) 11.7/11.2 kNm PASS
L40 ballast/anchor provision specified 1400 kg or ties PASS
L5/6 tread defl (3kN pt) <= 7.5 0.7 mm PASS
L26 tread bending @10kN bridge patch 178 MPa PASS
L26 plank web pitch <=50 (local patch) 45 mm PASS
L26/52 stringer @10kN bridge (SHS60x5 pl.) util 0.95 PASS
L19/23 stringer stair UDL+pt (elastic) 200 MPa PASS
L23 stringer defl <= L/100 & 25 2.6 mm PASS
L33/34 post bending (SHS50x5, crowd) 262 MPa PASS
L33 post base saddle M12 pair lever>=100 wrap saddle PASS
L33 rail bending (CHS40x3, crowd) 61 MPa PASS
L61/12 ctl-bar buckling (SHS40x4) 26/1709 kN PASS
L61 bush bearing (DU, 20 long) <= 20 MPa 13.5 MPa PASS
L61 pivot pin Ø16 double shear 154 kN cap PASS
G104/106 coupler = Ø16 spigot H11/h9 + cam latch lip <=1 by fit PASS
G38 ramp modes REQUIRE overlay deck overlay fitted PASS
------------------------------------------------------------------------------
57 checks, 0 FAIL -- ALL COMPLIANT
NOT VERIFIED BY THIS FILE (site/config/test scope): L27-30 bridge vibration per config;
L32 fatigue; L42 site wind calc; L43 snow; L57 type test EN 12811-3; L65 ground bearing;
G87 thermal joint (bridge bearing pads part); G12/G46/G53/G63 site headroom; G28 tower spacing plan.

Sheet: References
Reference | Type | Link
EN 12811-1 (free copy, WM-Scaffold) | Standard (free third-party copy) | https://www.wm-scaffold.com/wp-content/uploads/2021/06/BS-EN-12811-1-British-Standard-Scaffolding-Performance-Requirement.pdf
EN 12811-2 materials (free copy) | Standard (free third-party copy) | https://www.wm-scaffold.com/wp-content/uploads/2021/06/BS-EN-12811-2-British-Standard-Scaffolding-Material-Requirement-.pdf
EN 1991-1-1 imposed loads (free copy) | Standard (free third-party copy) | https://www.phd.eng.br/wp-content/uploads/2015/12/en.1991.1.1.2002.pdf
HiVoSS / JRC Lightweight Footbridge Vibration | Eurocode guidance (free, EU) | https://eurocodes.jrc.ec.europa.eu/sites/default/files/2021-12/jrc_53442.pdf
Setra Footbridge vibration guide (Cerema) | Eurocode guidance (free, EU) | https://www.cerema.fr/en/centre-ressources/boutique/technical-guide-footbridges
DS Layher Temporary Access / Allround stair | Manufacturer datasheet (EN) | https://www.layher.co.uk/wp-content/uploads/2017/11/Layher-Temporary-Access.pdf
DS PERI UP Public Stair | Manufacturer datasheet (EN) | https://www.peri.com/en/dam/jcr:5ea91375-1eeb-498d-b9e4-971d2618fcdd/peri-up-public-stair-flyer-english.pdf
DS PERI UP Flex Stair 75 | Manufacturer datasheet (EN) | https://www.peri.ltd.uk/products/peri-up-flex-stair-75.html
DS Prolyte StageDex (stairs+deck) | Manufacturer datasheet (EN) | https://www.prolyte.com/getmedia/da36696e-54a8-473f-b4a2-1c76e21cf20b/PROLYTE_StageDex_User_manual_issue1.pdf.aspx
DS Layher Event Deck T16 catalogue | Manufacturer datasheet (EN) | https://layher-content-prod.s3.eu-central-1.amazonaws.com/s3fs-public/2025-01/EN_Catalogue_Event_2024lr.pdf
DS PERI UP Flex Steel Deck UDG-2 | Manufacturer datasheet (EN) | https://www.peri.ie/dam/jcr:7a91f464-59cc-3484-8dea-98625f62027f/peri-up-flex-mobile-working-platform-instructions-for-assembly-and-use.pdf
DS BoSS SOLO 700 mobile tower | Manufacturer datasheet (EN 1004-1) | https://pasma.co.uk/wp-content/uploads/2023/07/BoSS-Instruction-Manual-SOLO-700-Access-Tower.pdf
DS TB Davies TASKMASTER EN131 Pro ladder | Manufacturer datasheet (EN 131) | https://www.tbdavies.co.uk/pdfs/datasheets/datasheet-1102-030-tb-davies-taskmaster-aluminium-professional-extension-ladder.pdf
DS Lyte Ladders catalogue EN131 Pro | Manufacturer datasheet (EN 131) | https://www.tillwite.com/Content/Catalogues/LyteLadders.pdf
DS Layher Access Solutions (ladders/beams) | Manufacturer datasheet (EN) | https://www.layher.co.uk/wp-content/uploads/securepdfs/2024/02/AccessSolutions-Catalogue.pdf
DS Mabey Compact 200 panel bridge | Manufacturer datasheet (EN) | https://mabey.com.au/wp-content/uploads/2022/11/Compact-C200-Bridge-Brochure.pdf
DS Janson Bridging pedestrian bridges | Manufacturer datasheet (EN) | https://files.brintex.com/Occurrence/291/Brochure/7511/brochure.pdf
DS MAADI Make-A-Bridge aluminium | Manufacturer datasheet (EN 1999) | https://maadigroup.com/wp-content/uploads/2022/10/MAADI-Group_Catalogue_aluminum_pedestrian-bridges_other-structures.pdf
DS The Ramp Factory 15t yard ramp | Manufacturer datasheet | https://www.therampfactory.co.uk/yard-ramp-11260x2260x15000kg
DS Loading Dock Systems steel yard ramp | Manufacturer datasheet | https://www.loadingdocksystems.com/files/2021-09/m_yardramp_4111-0076_sept2018.pdf
DS Excellent Systems modular ramp | Manufacturer datasheet | https://easiaccess.co.uk/wp-content/uploads/2023/07/2023-Excellent-Systems-Brochure-Interactive.pdf
DS AA Ramps Entrada modular ramp | Manufacturer datasheet | https://aaramps.com/wp-content/uploads/2020/11/AA-tech-specs-Final-Revised-TW-050917.pdf
DS Layher Bridging system + beams | Manufacturer datasheet (EN) | https://layher.com.au/wp-content/uploads/2025/09/EN_LayherInfo_BridgingInTheSystem_8116354.pdf
