calo-lategan/Staircase/v2/spec/compliance_report.xlsx

Sheet: Geometry compliances
Geometry Compliances - exhaustive
Legend: peach-shaded rows = compliances ADDED beyond the original upload. Final column lists ONLY free/accessible references (no paywalled standards). See 'Free Reference Library' tab for live links.
Module / Function | Component | Parameter / Detail | Minimum | Maximum | Target (Unified Modular) | Relevant EN Standard Reference | Free / Accessible References & Datasheets (no paywall) | EN basis
Stairs | Step (Tread) | Width (clear passing) | 500 mm (EN 12811-1 min) | N/A | 1500 mm (match ramps) | EN 12811-1 | - EN 12811-1 (free copy, WM-Scaffold) - DS PERI UP Public Stair - DS Layher Temporary Access / Allround stair | Governing
Stairs | Step (Tread) | Depth (Going / g) | 150 mm (Class A) / 175 mm (Class B) | 300 mm (cap via 2h+g <= 660) | 250-280 mm | EN 12811-1 (Class B) | - EN 12811-1 (free copy, WM-Scaffold) | Governing
Stairs | Step (Tread) | Height (Rise / h) | 125 mm (Class A) / 165 mm (Class B) | ~205-210 mm (cap via 2h+g <= 660) | 165 mm | EN 12811-1 (Class B) | - EN 12811-1 (free copy, WM-Scaffold) | Governing
Stairs | Step (Tread) | Step overlap (undercut) | 10 mm | N/A | 15 mm | EN 12811-1 | - (EN standard - buy from CEN/BSI; free copies & datasheets in 'Free Reference Library') | Governing
Stairs | Distance | Gap between steps (open riser) | N/A | Per EN 13200 (public child-safe) | Child-safe spacing per EN 13200 (event) | EN 13200 (public) / EN 12811-1 | - (EN standard - buy from CEN/BSI; free copies & datasheets in 'Free Reference Library') | Functional
Stairs | Geometry | 2h + g (rise & going formula) | 540 mm | 660 mm | ~600 mm | EN 12811-1 | - EN 12811-1 (free copy, WM-Scaffold) | Governing
Stairs | Geometry | Angle (pitch) | 20 deg | 45 deg (Ind) / 33 deg (Pub) | <= 33 deg | EN 12811-1 | - EN 12811-1 (free copy, WM-Scaffold) | Governing
Stairs | Flight | Vertical height without landing | N/A | 3000 mm (16 steps) | Max 3000 mm | EN 12811-1 | - EN 12811-1 (free copy, WM-Scaffold) | Governing
Stairs | Clearance | Headroom | 1900 mm (EN 12811-1 min) | N/A | >= 1900 mm (EN min); 2100 enhanced | EN 12811-1 | - (EN standard - buy from CEN/BSI; free copies & datasheets in 'Free Reference Library') | Governing
Stairs | Step (Tread) | Rise/going uniformity within a flight | N/A | +/- 5 mm variation | All steps identical (+/-5 mm) | EN 12811-1 | - (EN standard - buy from CEN/BSI; free copies & datasheets in 'Free Reference Library') | Governing
Stairs | Flight | Number of risers per flight | 3 (min) | 18 (max before landing) | <= 16 risers then landing | EN 12811-1 | - (EN standard - buy from CEN/BSI; free copies & datasheets in 'Free Reference Library') | Governing
Stairs | Landing | Landing length (in direction of travel) | >= stair width (min 800 mm) | N/A | >= 1500 mm (match ramp) | EN 12811-1 | - EN 12811-1 (free copy, WM-Scaffold) | Governing
Stairs | Landing | Landing at change of direction | Full width | N/A | Full width, level | EN 12811-1 | - (EN standard - buy from CEN/BSI; free copies & datasheets in 'Free Reference Library') | Governing
Stairs | Step (Tread) | Slip resistance of tread | R10 / PTV >= 36 wet | N/A | Serrated/perforated, PTV >= 40 | EN 16165 / EN 13036-4 | - (EN standard - buy from CEN/BSI; free copies & datasheets in 'Free Reference Library') | Functional
Stairs | Nosing | Nosing visual contrast / no projecting nosing | N/A | <= 25 mm overhang, rounded | Slip-resistant nosing; child-safe risers for public (EN 13200) | EN 12811-1 / EN 13200 | - (EN standard - buy from CEN/BSI; free copies & datasheets in 'Free Reference Library') | Functional
Stairs | Handrail | Both sides if width > 1200 mm; intermediate if > 2000 mm | Both sides | N/A | Both sides + centre if > 2000 mm | EN 12811-1 | - EN 12811-1 (free copy, WM-Scaffold) | Governing
Stairs | Handrail | Handrail horizontal extension past top/bottom step | 300 mm | N/A | >= 300 mm both ends | EN 12811-1 | - (EN standard - buy from CEN/BSI; free copies & datasheets in 'Free Reference Library') | Governing
Stairs | Access | Self-closing gate at open landing/ladder hole | N/A | N/A | Self-closing, no outward swing over edge | EN 12811-1 | - (EN standard - buy from CEN/BSI; free copies & datasheets in 'Free Reference Library') | Governing
Ladder (straight) | Rung | Spacing (rise between rungs) | 225 mm | 300 mm | 250 mm (equal) | EN 131-1 | - DS TB Davies TASKMASTER EN131 Pro ladder | Governing
Ladder (straight) | Rung | Width (clear inside stiles) | 280 mm | N/A | >= 400 mm | EN 131-1 | - (EN standard - buy from CEN/BSI; free copies & datasheets in 'Free Reference Library') | Governing
Ladder (straight) | Rung | Depth (standing surface) | 20 mm | N/A | >= 30 mm (D-section) | EN 131-1 | - DS TB Davies TASKMASTER EN131 Pro ladder | Governing
Ladder (straight) | Stile / Leg | Width outside-to-outside | N/A | N/A | Per EN 131-1 base table | EN 131-1 | - (EN standard - buy from CEN/BSI; free copies & datasheets in 'Free Reference Library') | Governing
Ladder (straight) | Geometry | Angle (leaning pitch) | 65 deg | 75 deg | 75 deg (1:4 rule) | EN 131-1 | - (EN standard - buy from CEN/BSI; free copies & datasheets in 'Free Reference Library') | Governing
Ladder (straight) | Stabiliser | Base width extension | varies by length | N/A | Required if >= 3 m height | EN 131-1 | - (EN standard - buy from CEN/BSI; free copies & datasheets in 'Free Reference Library') | Governing
Ladder (straight) | Clearance | Distance behind rung to wall | 150 mm | N/A | >= 150 mm | EN 131 | - (EN standard - buy from CEN/BSI; free copies & datasheets in 'Free Reference Library') | Governing
Ladder (straight) | Rung | Rung spacing tolerance / uniformity | N/A | +/- 2 mm | Equal incl. top & bottom (+/-2 mm) | EN 131-1 | - (EN standard - buy from CEN/BSI; free copies & datasheets in 'Free Reference Library') | Governing
Ladder (straight) | Top / Exit | Handhold extension above landing | 1000 mm (>= 5 rungs) | N/A | >= 1100 mm above stepping-off level | EN 131 | - (EN standard - buy from CEN/BSI; free copies & datasheets in 'Free Reference Library') | Governing
Ladder (straight) | Length | Max length leaning straight ladder | N/A | 9.1 m working length (then rest/secure) | <= 9.1 m; secure top & bottom | EN 131-2 | - (EN standard - buy from CEN/BSI; free copies & datasheets in 'Free Reference Library') | Governing
Ladder (straight) | Clearance | Climbing space in front of rungs | 600 mm | N/A | >= 650 mm clear | EN 131 | - (EN standard - buy from CEN/BSI; free copies & datasheets in 'Free Reference Library') | Governing
Ladder (straight) | Clearance | Lateral clear width each side of ladder centre | 150 mm | N/A | >= 150 mm (>= rung half-width) | EN 131 | - (EN standard - buy from CEN/BSI; free copies & datasheets in 'Free Reference Library') | Governing
Ladder (straight) | Feet | Anti-slip feet / ground grip | Base slip <= 40 mm | N/A | Slip-resistant feet, levelled base | EN 131-2 | - (EN standard - buy from CEN/BSI; free copies & datasheets in 'Free Reference Library') | Governing
Ladder (straight) | Fall protection | Safety cage / fall-arrest line (if FIXED vertical) | >3 m needs cage or fall arrest | N/A | Fall-arrest line preferred (fixed use) | EN 131 | - (EN standard - buy from CEN/BSI; free copies & datasheets in 'Free Reference Library') | Governing
Ladder (straight) | Rung | Slip resistance of rung | Serrated / ribbed | N/A | Ribbed + R-rating | EN 131-2 | - (EN standard - buy from CEN/BSI; free copies & datasheets in 'Free Reference Library') | Governing
Ramp (Pod) | Floor | Width (clear passing) | 600 mm (Ind) / 1500 mm (Pub) | N/A | 1500 mm | EN 12811-1 / EN 17210 | - EN 12811-1 (free copy, WM-Scaffold) - DS Excellent Systems modular ramp - DS AA Ramps Entrada modular ramp | Functional
Ramp (Pod) | Floor | Angle (gradient) | N/A | 20 deg (Ind) / 4.76 deg (Pub) | Max 1:12 (4.76 deg) ADA/Pub | EN 12811-1 / EN 17210 | - (EN standard - buy from CEN/BSI; free copies & datasheets in 'Free Reference Library') | Functional
Ramp (Pod) | Flight | Distance without resting landing | N/A | 10 m (1:20), 5 m (1:12) | Max 5 m continuous | EN 17210 / EN 12811-1 | - (EN standard - buy from CEN/BSI; free copies & datasheets in 'Free Reference Library') | Functional
Ramp (Pod) | Edge | Kerb / upstand height | 100 mm | N/A | 100 mm | EN 17210 / EN 12811-1 | - (EN standard - buy from CEN/BSI; free copies & datasheets in 'Free Reference Library') | Functional
Ramp (Pod) | Landing | Landing length top & bottom | 1500 mm | N/A | >= 1500 mm clear of door swing | EN 17210 / EN 12811-1 | - (EN standard - buy from CEN/BSI; free copies & datasheets in 'Free Reference Library') | Functional
Ramp (Pod) | Landing | Intermediate landing length | 1200 mm | N/A | >= 1200 mm | EN 17210 / EN 12811-1 | - (EN standard - buy from CEN/BSI; free copies & datasheets in 'Free Reference Library') | Functional
Ramp (Pod) | Flight | Max rise per flight | N/A | 500 mm (1:20) / 166 mm (1:12) | <= 500 mm per run | EN 17210 / EN 12811-1 | - (EN standard - buy from CEN/BSI; free copies & datasheets in 'Free Reference Library') | Functional
Ramp (Pod) | Floor | Cross-fall (lateral slope) | N/A | 1:40 | <= 1:40 | EN 17210 / EN 12811-1 | - (EN standard - buy from CEN/BSI; free copies & datasheets in 'Free Reference Library') | Functional
Ramp (Pod) | Floor | Slip resistance (wet) | PTV >= 36 wet | N/A | PTV >= 40 wet | EN 16165 / EN 13036-4 | - (EN standard - buy from CEN/BSI; free copies & datasheets in 'Free Reference Library') | Functional
Ramp (Pod) | Clearance | Headroom over ramp | 2100 mm | N/A | >= 2100 mm | EN 17210 / EN 12811-1 | - (EN standard - buy from CEN/BSI; free copies & datasheets in 'Free Reference Library') | Functional
Ramp (Pod) | Handrail | Handrails both sides; height to pitch line | 900 mm | 1000 mm | 900-1000 mm (1100 landings) | EN 17210 / EN 12811-1 | - (EN standard - buy from CEN/BSI; free copies & datasheets in 'Free Reference Library') | Functional
Platform | Floor | Width | 600 mm | N/A | 1500 mm (match elements) | EN 12811-1 | - EN 12811-1 (free copy, WM-Scaffold) - DS PERI UP Flex Steel Deck UDG-2 - DS Layher Event Deck T16 catalogue | Governing
Platform | Floor | Deck gap tolerance | N/A | 25 mm | <= 25 mm | EN 12811-1 | - EN 12811-1 (free copy, WM-Scaffold) | Governing
Platform | Floor | Width class (system) | W06 = 0.6 m | W24 = 2.4 m | W12-W15 (1.2-1.8 m) | EN 12811-1 Table 1 | - EN 12811-1 (free copy, WM-Scaffold) | Governing
Platform | Floor | Gap platform-to-face (structure side) | N/A | 300 mm (else guard) | <= 80 mm or guarded | EN 12811-1 | - EN 12811-1 (free copy, WM-Scaffold) | Governing
Platform | Access | Trap-door / access opening size | 450 x 600 mm | N/A | >= 0.45 x 0.60 m | EN 12811-1 cl.5.8.3 | - EN 12811-1 (free copy, WM-Scaffold) | Governing
Platform | Clearance | Headroom above platform | 1900 mm | N/A | >= 1.90 m | EN 12811-1 cl.5.3 | - EN 12811-1 (free copy, WM-Scaffold) | Governing
Platform | Floor | Slip resistance of deck | R10 / PTV >= 36 | N/A | Perforated/anti-slip ply | EN 13374 / EN 16165 | - (EN standard - buy from CEN/BSI; free copies & datasheets in 'Free Reference Library') | Functional
Platform | Stability | Free-standing height : base ratio | N/A | 3:1 (outdoor) / 3.5:1 (indoor) | <= 3:1 outdoor or tie/ballast | EN 1004-1 | - (EN standard - buy from CEN/BSI; free copies & datasheets in 'Free Reference Library') | Design-derived
Platform | Edge | Edge protection on all open sides | Guardrail + toe board | N/A | Full perimeter where fall > 2 m | EN 13374 | - (EN standard - buy from CEN/BSI; free copies & datasheets in 'Free Reference Library') | Governing
Bridge | Geometry | Clear width | 600 mm | N/A | 1500 mm | EN 1991-2 (pedestrian) | - HiVoSS / JRC Lightweight Footbridge Vibration - DS Mabey Compact 200 panel bridge - DS Janson Bridging pedestrian bridges - DS MAADI Make-A-Bridge aluminium | Governing
Bridge | Parapet | Parapet / guardrail height | 1100 mm | N/A | >= 1100 mm | EN 1991-2 / EN 13374 | - HiVoSS / JRC Lightweight Footbridge Vibration | Governing
Bridge | Parapet | Infill / vertical bar gap | N/A | 100 mm | <= 100 mm sphere | EN 1991-2 / EN 13374 | - (EN standard - buy from CEN/BSI; free copies & datasheets in 'Free Reference Library') | Governing
Bridge | Deck | Slip resistance of deck | PTV >= 36 wet | N/A | Anti-slip deck plate | EN 16165 / EN 13036-4 | - (EN standard - buy from CEN/BSI; free copies & datasheets in 'Free Reference Library') | Functional
Bridge | Deck | Cross-fall / drainage | N/A | 1:40 | <= 1:40 for drainage | EN 1991-2 | - (EN standard - buy from CEN/BSI; free copies & datasheets in 'Free Reference Library') | Governing
Bridge | Approach | Ramped approach gradient | N/A | 1:12 (Pub) / 1:20 ideal | <= 1:12 accessible | EN 17210 / EN 12811-1 | - (EN standard - buy from CEN/BSI; free copies & datasheets in 'Free Reference Library') | Functional
Bridge | Clearance | Headroom over deck | 2100 mm | N/A | >= 2100 mm | EN 1991-2 / EN 13374 | - (EN standard - buy from CEN/BSI; free copies & datasheets in 'Free Reference Library') | Governing
Handrail / Guardrail | Top Rail | Height from floor / pitch line | 1100 mm (Event) / 1000 mm (Ind) | N/A | 1100 mm | EN 13374 / EN 12811-1 | - EN 12811-1 (free copy, WM-Scaffold) | Governing
Handrail / Guardrail | Top Rail | Diameter / width (grip) | 25 mm | 50 mm | 40 mm | EN 12811-1 | - (EN standard - buy from CEN/BSI; free copies & datasheets in 'Free Reference Library') | Governing
Handrail / Guardrail | Middle Rail | Distance to top rail or toe board | N/A | 470 mm (both grades) | <= 470 mm gap | EN 13374 / EN 12811-1 | - EN 12811-1 (free copy, WM-Scaffold) | Governing
Handrail / Guardrail | Toe Board | Height from floor | 150 mm (Event) / 100 mm (Ind) | N/A | 150 mm | EN 13374 / EN 12811-1 | - EN 12811-1 (free copy, WM-Scaffold) | Governing
Handrail / Guardrail | Clearance | Distance to surrounding objects | 50 mm (min) / 100 mm (ideal) | N/A | 100 mm | EN 12811-1 | - (EN standard - buy from CEN/BSI; free copies & datasheets in 'Free Reference Library') | Governing
Handrail / Guardrail | Infill | Any gap in side protection (all directions) | N/A | 470 mm | <= 470 mm (or <=100 mm mesh public) | EN 13374 / EN 12811-1 | - EN 12811-1 (free copy, WM-Scaffold) | Governing
Handrail / Guardrail | Both sides | Guardrail on both open sides | Both sides | N/A | Both sides, full length | EN 13374 | - EN 12811-1 (free copy, WM-Scaffold) | Governing
Handrail / Guardrail | Children | Second / lower rail for public crowds | ~600 mm | N/A | Add lower rail at ~600 mm (event) | EN 13200 | - (EN standard - buy from CEN/BSI; free copies & datasheets in 'Free Reference Library') | Functional
Handrail / Guardrail | Ends | Handrail returns / no snag ends | Returned to post/wall | N/A | Returned, smooth, no sharp ends | EN 12811-1 | - (EN standard - buy from CEN/BSI; free copies & datasheets in 'Free Reference Library') | Governing
Handrail / Guardrail | Continuity | Continuous over flights & landings | Continuous | N/A | Continuous, both sides | EN 12811-1 | - (EN standard - buy from CEN/BSI; free copies & datasheets in 'Free Reference Library') | Governing
Legs / Support | Base | Footplate dimension | 150 x 150 mm | N/A | 150 x 150 mm minimum | EN 12811-1 | - EN 12811-1 (free copy, WM-Scaffold) | Governing
Legs / Support | Base jack | Adjustable base jack extension | N/A | 600 mm (typ. max) | <= 1/3 length engaged | EN 1004-1 / EN 12811-1 | - EN 12811-1 (free copy, WM-Scaffold) | Governing
Legs / Support | Verticality | Out-of-plumb / level tolerance | N/A | 1% (1:100) | <= 1:100 plumb; sole boards level | EN 12811-1 | - EN 12811-1 (free copy, WM-Scaffold) | Design-derived
Legs / Support | Sole board | Sole board / base bearing | N/A | N/A | Spread to keep ground pressure within bearing | EN 12811-1 | - EN 12811-1 (free copy, WM-Scaffold) | Design-derived
Legs / Support | Bracing / ties | Tie / brace spacing (free-standing) | N/A | Per height & wind | Diagonal bracing every bay; ties per design | EN 12811-1 / EN 1004-1 | - EN 12811-1 (free copy, WM-Scaffold) | Design-derived
Connections | Couplers / spigots | Coupler engagement / pin locking | Locked / pinned | N/A | Positive lock; EN 74 class B if swivel | EN 74-1 / EN 12811-1 | - EN 12811-1 (free copy, WM-Scaffold) | Governing
Platform | Stability | Max free-standing tower height (no ties) | 8 m (outdoor) | 12 m (indoor) | Tie/ballast above limit | EN 1004-1 | - EN 12811-1 (free copy, WM-Scaffold) | Design-derived
Stairs | Flight | Access opening at landing | 450 x 600 mm | N/A | >= 0.45 x 0.60 m | EN 12811-1 cl.5.8.3 | - EN 12811-1 (free copy, WM-Scaffold) | Governing
All units | Connection | Erection / assembly fit-up tolerance | N/A | Per system | Pinned, no forced fit; gaps <= 25 mm | EN 12811-1 / EN 1004-1 | - EN 12811-1 (free copy, WM-Scaffold) | Governing
Ramp (Pod) | Landing | Turning space at direction change | 1500 x 1500 mm | N/A | >= 1500 x 1500 mm | EN 17210 | - (EN 17210 accessibility) | Functional
Ramp (Pod) | Threshold | Level threshold / upstand at transitions | N/A | 15 mm (chamfered) | <= 15 mm, chamfered | EN 17210 | - (EN 17210 accessibility) | Functional
Platform | Stability | Vertical spacing between platforms | N/A | 2.25 m | <= 2.25 m | EN 1004-1 | - EN 12811-1 (free copy, WM-Scaffold) | Governing
Bridge | Geometry | Max span before intermediate support | N/A | Config / design-dependent | Per EN 1990/EN 1993 SLS+ULS | EN 1990 / EN 1993 / EN 1999 | - HiVoSS / JRC Lightweight Footbridge Vibration | Design-derived
Bridge | Supports | Expansion / articulation (thermal) | Provide movement joint | N/A | Free thermal movement at one end | EN 1991-1-5 / EN 1993 | - EN 12811-1 (free copy, WM-Scaffold) | Design-derived
Bridge | Deck | Pre-camber / dead-load offset | Offset permanent sag | N/A | Pre-camber to net-zero sag at SLS | EN 1993 / EN 1999 | - EN 12811-1 (free copy, WM-Scaffold) | Design-derived
Ladder (straight) | Top | Top support / resting bearing | Both stiles bear | N/A | Stable bearing both stiles; secured | EN 131-2 | - (EN 131 - product standard) | Governing
Ladder (straight) | Base | First rung height from base | N/A | Per EN 131 set-up | Equal to rung pitch at base | EN 131-1 | - (EN 131 - product standard) | Governing
Stairs | Step (Tread) | Effective going (incl. nosing overlap) | Going + overlap | N/A | Going + 15 mm nosing | EN 12811-1 | - EN 12811-1 (free copy, WM-Scaffold) | Governing
Platform | Access | Ground to first platform / safe access | Internal ladder/stair access | N/A | Provide internal access < 4.6 m rise | EN 1004-1 / EN 12811-1 | - EN 12811-1 (free copy, WM-Scaffold) | Governing
All units | Corrosion | Galvanizing / coating | Hot-dip galv EN ISO 1461 | same + UV/coastal where needed | Protection to exposure | EN ISO 1461 / EN 12811-2 | - EN 12811-2 materials (free copy) | Governing
All units | Marking / label | Permanent ID & rating plate | Durable plate per component/unit | same | Load class, max load, mfr, EN, ID, date | EN 12811-1 cl.4 / EN 131-3 | - EN 12811-1 (free copy, WM-Scaffold) | Governing
All units | Slip resistance | Walking-surface slip class | PTV >= 36 / R10 | PTV >= 40 / R11 (event) | Wet pendulum / R-rating | EN 16165 / EN 13036-4 | - (EN standard - buy from CEN/BSI; free copies & datasheets in 'Free Reference Library') | Functional
All units | Edge / gap safety | Finger-trap & shear points | Guarded / >25 mm or <8 mm | same | No trap/shear in moving joints | EN 12811-1 | - (EN standard - buy from CEN/BSI; free copies & datasheets in 'Free Reference Library') | Governing
All units | Assembly | Instruction manual & method statement | Supplied per EN 1298 | same | Erection/dismantle guidance | EN 1298 / EN 1004-2 | - (EN standard - buy from CEN/BSI; free copies & datasheets in 'Free Reference Library') | Governing
Ladder (straight) | Marking | Ladder pictograms & user instructions | Per EN 131-3 | same | Mandatory markings | EN 131-3 | - (EN standard - buy from CEN/BSI; free copies & datasheets in 'Free Reference Library') | Governing
Stairs / Platform | Edge protection | Temporary edge protection class | Class A (flat) / B (10-30 deg) | same | Class A/B/C per pitch | EN 13374 | - EN 12811-1 (free copy, WM-Scaffold) | Governing
Event use | Event safety | Temporary demountable structure compliance | Per EN 17879 | Per EN 17879 / EN 13200 | Procurement/design/use | EN 17879 / EN 13200 / EN 13814 | - (EN standard - buy from CEN/BSI; free copies & datasheets in 'Free Reference Library') | Functional
Construction use | Scaffold compliance | Access & egress good practice | Per EN 12811-1 / EN 12810 | same | EN access/egress provisions | EN 12811-1 / EN 12810 | - EN 12811-1 (free copy, WM-Scaffold) | Governing
Construction use | System scaffold | Prefabricated system conformity | Type test per EN 12810 | same | If modular system scaffold | EN 12810-1 / EN 12811-1 | - EN 12811-1 (free copy, WM-Scaffold) | Governing
All units | CE marking | Product conformity (CE) & DoP | Declaration of performance | same | Where in scope of hEN | EN 12811-1 / EN 1004-1 | - EN 12811-1 (free copy, WM-Scaffold) | Design-derived
Connections | Module interface | Module-to-module alignment / deck continuity | Level lip <= 4 mm | Gap <= 25 mm | Flush join, lip <=4 mm, gap <=25 mm | EN 12811-1 / EN 1090-2 | - EN 12811-1 (free copy, WM-Scaffold) | Governing
Connections | Locking mechanism | Positive locking of fold / convert joints | Captive pins | N/A | Lockable, captive, no unintended release | EN 12811-1 / EN 1090-2 | - EN 12811-1 (free copy, WM-Scaffold) | Governing
Connections | Width extension | Module join alignment when extended in width | Aligned within tolerance | N/A | Continuous deck & rail line across joins | EN 12811-1 / EN 1090-2 | - EN 12811-1 (free copy, WM-Scaffold) | Governing
Handrail / Guardrail | Posts | Guardrail post spacing (max span) | N/A | 2.5 m (typ.) | <= 2.5 m or per load test | EN 13374 / EN 12811-1 | - EN 12811-1 (free copy, WM-Scaffold) | Design-derived
All units | Fabrication | Fabrication / dimensional tolerance (manufacture) | Per EN 1090-2 class | N/A | Execution class EXC2 (min) | EN 1090-2 | - (EN standard - buy from CEN/BSI) | Governing
Platform | Deck | Deck-to-deck level lip / trip across joins | N/A | 4 mm | <= 4 mm vertical lip | EN 12811-1 | - EN 12811-1 (free copy, WM-Scaffold) | Governing

Sheet: Load compliances
Load Compliances - exhaustive
Legend: peach-shaded rows = compliances ADDED beyond the original upload. Final column lists ONLY free/accessible references (no paywalled standards). See 'Free Reference Library' tab for live links.
Module / Function | Component | Load Type | Required Parameter | Value (Industrial/Construction) | Value (Public/Event/Heavy) | Relevant EN Standard Reference | Free / Accessible References & Datasheets (no paywall) | EN basis
Stairs | Floor / Steps | Area load (UDL) | Uniformly distributed | 1.5 to 5.0 kN/m2 | 5.0 to 7.5 kN/m2 (target) | EN 1991-1-1 Cat C5 / EN 12811-1 | - EN 1991-1-1 imposed loads (free copy) - EN 12811-1 (free copy, WM-Scaffold) | Governing
Stairs | Step (Tread) | Point load | Localised weight | 1.5 kN on 200x200 mm | 3.0 kN on 200x200 mm (Cat C) | EN 12811-1 / EN 1991-1-1 | - EN 1991-1-1 imposed loads (free copy) - EN 12811-1 (free copy, WM-Scaffold) | Governing
Stairs | Floor / Steps | Deflection | Max bending | L/100 and <= 25 mm (EN 12811-1) | L/100 (L/300 = enhanced comfort) | EN 12811-1 | - EN 12811-1 (free copy, WM-Scaffold) | Governing
Stairs | Flight | Horizontal load on stair structure | Sway / surge | 0.3 kN or 2.5% vertical | 3.0 kN/m crowd (event) | EN 12811-1 / EN 1991-1-1 | - EN 12811-1 (free copy, WM-Scaffold) - EN 1991-1-1 imposed loads (free copy) | Governing
Ladder (straight) | Rung | Point load | Weight on single rung | 1.5 kN (150 kg) | 1.5 kN (150 kg) | EN 131 Professional | - DS TB Davies TASKMASTER EN131 Pro ladder | Governing
Ladder (straight) | Stile / Leg | Vertical load | Compression per leg | 1.5 kN | 1.5 kN | EN 131 Professional | - (EN standard - buy from CEN/BSI; free copies & datasheets in 'Free Reference Library') | Governing
Ladder (straight) | Rung | Torsion load | Rotational on rung | 50 Nm | 50 Nm | EN 131-2 | - (EN standard - buy from CEN/BSI; free copies & datasheets in 'Free Reference Library') | Governing
Ladder (straight) | Whole ladder | Max total load | Climber + tools | 150 kg total | 150 kg total | EN 131-2 | - (EN standard - buy from CEN/BSI; free copies & datasheets in 'Free Reference Library') | Governing
Ladder (straight) | Rung | Rung strength (static test) | No fracture/crack | 275 kg (Professional) | 275 kg (Professional) | EN 131-2 | - (EN standard - buy from CEN/BSI; free copies & datasheets in 'Free Reference Library') | Governing
Ladder (straight) | Whole ladder | Durability (cyclic) | Fatigue cycles | 50,000 cycles | 50,000 cycles | EN 131-2 | - (EN standard - buy from CEN/BSI; free copies & datasheets in 'Free Reference Library') | Governing
Ladder (straight) | Feet | Base slip resistance | Foot slip test | Feet move <= 40 mm | Feet move <= 40 mm | EN 131-2 | - (EN standard - buy from CEN/BSI; free copies & datasheets in 'Free Reference Library') | Governing
Ladder (straight) | Stile | Lateral deflection / twist | Bend test | Within EN 131-2 limit | Within EN 131-2 limit | EN 131-2 | - (EN standard - buy from CEN/BSI; free copies & datasheets in 'Free Reference Library') | Governing
Ramp (Pod) | Floor | Area load (UDL) | Uniformly distributed | 5.0 kN/m2 | 5.0 to 7.5 kN/m2 | EN 1991-1-1 / EN 17210 | - EN 1991-1-1 imposed loads (free copy) | Functional
Ramp (Pod) | Floor | Point load | Localised weight | 1.5 kN | 3.0 kN | EN 1991-1-1 | - EN 1991-1-1 imposed loads (free copy) | Governing
Ramp (Pod) | Floor | Deflection | Max bending | L / 300 | L / 300 | EN 12811-1 / EN 1990 | - EN 12811-1 (free copy, WM-Scaffold) | Governing
Platform | Floor | Area load (UDL) | Uniformly distributed | 6.0 kN/m2 (Class 6) | 7.5 kN/m2 (StageDex equiv) | EN 12811-1 / EN 1991-1-1 | - EN 12811-1 (free copy, WM-Scaffold) - DS Prolyte StageDex (stairs+deck) - DS Layher Event Deck T16 catalogue | Governing
Platform | Floor | Point load | Localised weight | 3.0 kN on 500x500 mm (F1) | 3.0 kN on 500x500 mm (F1) | EN 12811-1 | - EN 12811-1 (free copy, WM-Scaffold) | Governing
Platform | Floor | Concentrated load F1 / F2 | 500x500 / 200x200 | 1.5-3.0 kN / 1.0 kN | 3.0 kN / 1.0 kN | EN 12811-1 cl.6.2 | - EN 12811-1 (free copy, WM-Scaffold) | Governing
Platform | Floor | Partial-area load q2 (class 4-6) | On 0.4-0.5 area | 5.0 kN/m2 | 10.0 kN/m2 (class 6) | EN 12811-1 Table 3 | - EN 12811-1 (free copy, WM-Scaffold) | Governing
Platform | Floor | Deflection | Max bending | L / 100 and <= 25 mm | L / 100 and <= 25 mm | EN 12811-1 cl.6.3 | - EN 12811-1 (free copy, WM-Scaffold) | Governing
Platform | Floor | Horizontal working load | Sway | 2.5% of bay q1 or 0.3 kN | 2.5% of bay q1 or 0.3 kN | EN 12811-1 | - EN 12811-1 (free copy, WM-Scaffold) | Governing
Bridge | Floor | Area load (UDL) | Uniformly distributed | 5.0 kN/m2 | 5.0 kN/m2 (LM4) | EN 1990 / EN 1991-2 | - HiVoSS / JRC Lightweight Footbridge Vibration - EN 1991-1-1 imposed loads (free copy) | Governing
Bridge | Floor | Point load | Localised weight | 10 kN on 0.1x0.1 m (EN 1991-2) | 10 kN on 0.1x0.1 m (EN 1991-2) | EN 1991-2 cl.5.3.2.2 | - HiVoSS / JRC Lightweight Footbridge Vibration | Governing
Bridge | Floor | Dynamic / vibration (vertical) | Accel limit | < 0.7 m/s2 (EN 1990/A1) | < 0.7 m/s2 | EN 1990/A1 Annex A2 / HiVoSS / Setra | - HiVoSS / JRC Lightweight Footbridge Vibration - Sétra Footbridge vibration guide (Cerema) | Governing
Bridge | Floor | Dynamic / vibration (lateral) | Accel limit | < 0.2 m/s2 (0.4 crowd) | < 0.2 m/s2 (0.4 crowd) | EN 1990/A1 Annex A2 / HiVoSS / Setra | - HiVoSS / JRC Lightweight Footbridge Vibration - Sétra Footbridge vibration guide (Cerema) | Governing
Bridge | Floor | Horizontal longitudinal force | Braking / surge | 10% of total UDL | 10% of total UDL | EN 1991-2 cl.5.4 | - HiVoSS / JRC Lightweight Footbridge Vibration | Governing
Bridge | Floor | Frequency trigger for dynamic check | Natural frequency | f_vert < 5 Hz / f_lat < 2.5 Hz | same | EN 1990/A1 Annex A2 | - HiVoSS / JRC Lightweight Footbridge Vibration - Sétra Footbridge vibration guide (Cerema) | Governing
Bridge | Floor | Deflection | Max bending | L / 250 | L / 360 (public comfort) | EN 1990/A2 / EN 1993 / EN 1999 | - (EN standard - buy from CEN/BSI; free copies & datasheets in 'Free Reference Library') | Governing
Bridge | Structure | Fatigue (repeated erection + traffic) | Stress cycles | Check EN 1993-1-9 / EN 1999-1-3 | same | EN 1993-1-9 / EN 1999-1-3 | - (EN standard - buy from CEN/BSI; free copies & datasheets in 'Free Reference Library') | Functional
Handrail / Guardrail | Top Rail | Line load | Horizontal along rail | 0.3 kN point (EN 12811-1) + 0.5 kN/m (EN 1991-1-1 Cat A-C) | 3.0 kN/m line load (EN 1991-1-1 Cat C5 crowd) | EN 12811-1 / EN 1991-1-1 | - EN 12811-1 (free copy, WM-Scaffold) - EN 1991-1-1 imposed loads (free copy) | Governing
Handrail / Guardrail | Top Rail | Point load | Horizontal/vertical pinpoint | 1.25 kN | 1.25 kN | EN 12811-1 (1.25 kN guardrail) | - EN 12811-1 (free copy, WM-Scaffold) | Governing
Handrail / Guardrail | Middle Rail | Point load | Horizontal push | 1.25 kN | 1.25 kN | EN 12811-1 (1.25 kN guardrail) | - EN 12811-1 (free copy, WM-Scaffold) | Governing
Handrail / Guardrail | Toe Board | Point load | Horizontal push | 0.15 kN | 0.15 kN | EN 13374 Class A | - EN 12811-1 (free copy, WM-Scaffold) | Governing
Handrail / Guardrail | Infill | Infill / mesh load | Point on infill | 0.3 kN on 0.3 m sq | 0.3 kN on 0.3 m sq | EN 13374 / EN 1991-1-1 | - EN 12811-1 (free copy, WM-Scaffold) - EN 1991-1-1 imposed loads (free copy) | Governing
Legs / Support | Column | Axial load | Vertical downward | Derived from area load | Derived from area load | EN 1993 (Steel) / EN 1999 (Alu) | - EN 12811-1 (free copy, WM-Scaffold) | Design-derived
Legs / Support | Base / Tie | Lateral load | Wind / sway bracing | < 1.0% of vertical load | < 1.0% of vertical load | EN 12811-1 / EN 1991-1-4 | - EN 12811-1 (free copy, WM-Scaffold) | Governing
Legs / Support | Whole unit | Overturning / stability | Restoring vs overturning | FoS >= 1.5 (or ballast) | FoS >= 1.5 | EN 1991-1-4 / EN 1004-1 | - EN 12811-1 (free copy, WM-Scaffold) | Design-derived
Legs / Support | Base | Uplift / anchorage | Tie-down where wind governs | Per wind calc | Per wind calc | EN 1991-1-4 / EN 12811-1 | - EN 12811-1 (free copy, WM-Scaffold) | Design-derived
Environmental | Whole unit | Wind load | Pressure on frame/sheeting | Per EN 1991-1-4 (site) | Per EN 1991-1-4 (exposed/event) | EN 1991-1-4 | - EN 12811-1 (free copy, WM-Scaffold) | Design-derived
Environmental | Roof / canopy | Snow load (only if covered) | Roof / cover load | Per EN 1991-1-3 | Per EN 1991-1-3 | EN 1991-1-3 | - EN 12811-1 (free copy, WM-Scaffold) | Design-derived
All units | Whole structure | Basis of design (partial factors) | ULS combination | gG = 1.35, gQ = 1.5 | gG = 1.35, gQ = 1.5 | EN 1990 | - EN 1991-1-1 imposed loads (free copy) | Governing
All units | Whole structure | Notional horizontal / imperfection load | Global stability | 0.5-1.0% of vertical | 0.5-1.0% of vertical | EN 1990 / EN 12811-1 | - EN 12811-1 (free copy, WM-Scaffold) | Design-derived
Ladder (straight) | Whole ladder | Area load (UDL) | Uniformly distributed | N/A - point/rung load governs | N/A - point/rung load governs | EN 131 | - (EN 131 - product standard) | Design-derived
Ramp (Pod) | Floor | Horizontal load (surge / handrail) | Lateral push | 0.3 kN point (EN 12811-1) | 3.0 kN/m crowd (EN 1991-1-1 Cat C5) | EN 12811-1 / EN 1991-1-1 | - EN 1991-1-1 imposed loads (free copy) | Governing
Ramp (Pod) | Floor | Longitudinal / braking on slope | Down-slope force | Self-weight slope component (EN 1990) | Self-weight slope component (EN 1990) | EN 1990 / EN 1991-1-1 | - EN 1991-1-1 imposed loads (free copy) | Governing
Stairs | Landing | Area + point load (as treads) | UDL + point on landing | 1.0 kN/m2 + 1.5 kN on 200x200 | 5.0-7.5 kN/m2 + 3.0 kN on 200x200 | EN 12811-1 cl.6.2 / EN 1991-1-1 | - EN 12811-1 (free copy, WM-Scaffold) | Governing
Handrail / Guardrail | Whole barrier | Area / infill UDL | Distributed on infill | 0.5 kN/m2 (EN 1991-1-1) | 1.0 kN/m2 (event) | EN 1991-1-1 / EN 13374 | - EN 1991-1-1 imposed loads (free copy) | Governing
Legs / Support | Column | Concentrated leg reaction (point) | Single-leg max reaction | Derived from area + F1 (EN 12811-1) | Derived from area + F1 | EN 12811-1 / EN 1993/1999 | - EN 12811-1 (free copy, WM-Scaffold) | Design-derived
Bridge | Deck | Local wheel / service point (area+point) | Patch + point | 5.0 kN/m2 + 10 kN/0.1x0.1 m | 5.0 kN/m2 + 10 kN/0.1x0.1 m | EN 1991-2 | - HiVoSS / JRC Lightweight Footbridge Vibration | Governing
All units | Material - steel | Steel grade & yield | Min yield strength | S235 (235 N/mm2) min | S275/S355 where needed | EN 1993-1-1 / EN 10219 / EN 12811-2 | - EN 12811-2 materials (free copy) | Governing
All units | Material - aluminium | Aluminium alloy | Alloy & temper | EN AW-6082-T6 / 6063-T6 | same | EN 1999-1-1 / EN 12811-2 | - EN 12811-2 materials (free copy) | Governing
All units | Material - timber deck | Plywood / board grade | Bending strength & Class 0 fire | 18 mm birch ply / WBP | Class 0 / Euroclass B (event) | EN 12811-2 / EN 13501-1 | - EN 12811-2 materials (free copy) | Governing
All units | Documentation | Design check & sign-off | Independent design verification | Per EN 1990 reliability | Independent check for event structures | EN 1990 / EN 13814 / EN 17879 | - (EN standard - buy from CEN/BSI; free copies & datasheets in 'Free Reference Library') | Design-derived
All units | Testing | Type / load test of system | Physical verification | Load test per EN 12811-3 | same + dynamic for stages/bridges | EN 12811-3 / EN 1004-2 | - EN 12811-1 (free copy, WM-Scaffold) | Governing
Ladder (straight) | Certification | EN 131 Professional duty | Trade/hire classification | EN 131 Professional (not Domestic) | same | EN 131-1/-2/-3 | - (EN standard - buy from CEN/BSI; free copies & datasheets in 'Free Reference Library') | Governing
Bridge | Dynamic sign-off | Per-configuration vibration assessment | Setra/HiVoSS check each span x width | Mandatory for light decks | Mandatory (crowd lock-in) | EN 1990/A1 / HiVoSS / Setra | - HiVoSS / JRC Lightweight Footbridge Vibration - Sétra Footbridge vibration guide (Cerema) | Design-derived
All units | Basis of design | Limit-state design & load combinations | EN 1990 ULS/SLS partial factors | gG 1.35 / gQ 1.5 | same | EN 1990 | - EN 1991-1-1 imposed loads (free copy) | Governing
Connections | Coupler / pin / hinge | Connection design load (shear / slip) | Joint capacity | 1.0 kN slip (EN 74-1) / pin shear by design | Same + crowd uplift | EN 74-1 / EN 12811-1 | - EN 12811-1 (free copy, WM-Scaffold) | Design-derived
All units | Lifting / handling | Lifting point & handling load | Erect / transport | Dynamic handling factor by design | Same | EN 1991 / EN 13155 | - (EN standard - buy from CEN/BSI) | Design-derived
Bridge | Structure | Thermal action force | Expansion / restraint | Per EN 1991-1-5 range | Per EN 1991-1-5 range | EN 1991-1-5 | - (EN standard - buy from CEN/BSI) | Design-derived
Stairs / Platform / Bridge | Edge protection | Edge-protection arrest energy (inclined) | Dynamic arrest | Class C dynamic (if pitch 30-45 deg) | Class C dynamic | EN 13374 | - EN 12811-1 (free copy, WM-Scaffold) | Governing
Legs / Support | Foundation | Ground bearing pressure | Base bearing | <= allowable bearing by design | <= allowable bearing | EN 1997 / EN 12811-1 | - EN 12811-1 (free copy, WM-Scaffold) | Design-derived
All units | Whole structure | Load combination & accidental cases | ULS/SLS/accidental | Per EN 1990 (+ EN 1991-1-7 accidental) | Same | EN 1990 / EN 1991-1-7 | - EN 1991-1-1 imposed loads (free copy) | Governing

Sheet: Free Reference Library
Free Reference Library - EN standards & datasheets only
Free EN-standard copies, EN-product datasheets, and pan-European Eurocode (JRC/Setra) footbridge guidance. UK national documents excluded per scope. These are the live links behind column H of the Geometry & Load sheets.
Reference (free / accessible) | Type | Direct link (click)
EN 12811-1 (free copy, WM-Scaffold) | Standard (free third-party copy) | https://www.wm-scaffold.com/wp-content/uploads/2021/06/BS-EN-12811-1-British-Standard-Scaffolding-Performance-Requirement.pdf
EN 12811-2 materials (free copy) | Standard (free third-party copy) | https://www.wm-scaffold.com/wp-content/uploads/2021/06/BS-EN-12811-2-British-Standard-Scaffolding-Material-Requirement-.pdf
EN 1991-1-1 imposed loads (free copy) | Standard (free third-party copy) | https://www.phd.eng.br/wp-content/uploads/2015/12/en.1991.1.1.2002.pdf
HiVoSS / JRC Lightweight Footbridge Vibration | Eurocode guidance (free, EU) | https://eurocodes.jrc.ec.europa.eu/sites/default/files/2021-12/jrc_53442.pdf
Setra Footbridge vibration guide (Cerema) | Eurocode guidance (free, EU) | https://www.cerema.fr/en/centre-ressources/boutique/technical-guide-footbridges
DS Layher Temporary Access / Allround stair | Manufacturer datasheet (EN) | https://www.layher.co.uk/wp-content/uploads/2017/11/Layher-Temporary-Access.pdf
DS PERI UP Public Stair | Manufacturer datasheet (EN) | https://www.peri.com/en/dam/jcr:5ea91375-1eeb-498d-b9e4-971d2618fcdd/peri-up-public-stair-flyer-english.pdf
DS PERI UP Flex Stair 75 | Manufacturer datasheet (EN) | https://www.peri.ltd.uk/products/peri-up-flex-stair-75.html
DS Prolyte StageDex (stairs+deck) | Manufacturer datasheet (EN) | https://www.prolyte.com/getmedia/da36696e-54a8-473f-b4a2-1c76e21cf20b/PROLYTE_StageDex_User_manual_issue1.pdf.aspx
DS Layher Event Deck T16 catalogue | Manufacturer datasheet (EN) | https://layher-content-prod.s3.eu-central-1.amazonaws.com/s3fs-public/2025-01/EN_Catalogue_Event_2024lr.pdf
DS PERI UP Flex Steel Deck UDG-2 | Manufacturer datasheet (EN) | https://www.peri.ie/dam/jcr:7a91f464-59cc-3484-8dea-98625f62027f/peri-up-flex-mobile-working-platform-instructions-for-assembly-and-use.pdf
DS BoSS SOLO 700 mobile tower | Manufacturer datasheet (EN 1004-1) | https://pasma.co.uk/wp-content/uploads/2023/07/BoSS-Instruction-Manual-SOLO-700-Access-Tower.pdf
DS TB Davies TASKMASTER EN131 Pro ladder | Manufacturer datasheet (EN 131) | https://www.tbdavies.co.uk/pdfs/datasheets/datasheet-1102-030-tb-davies-taskmaster-aluminium-professional-extension-ladder.pdf
DS Lyte Ladders catalogue EN131 Pro | Manufacturer datasheet (EN 131) | https://www.tillwite.com/Content/Catalogues/LyteLadders.pdf
DS Layher Access Solutions (ladders/beams) | Manufacturer datasheet (EN) | https://www.layher.co.uk/wp-content/uploads/securepdfs/2024/02/AccessSolutions-Catalogue.pdf
DS Mabey Compact 200 panel bridge | Manufacturer datasheet (EN) | https://mabey.com.au/wp-content/uploads/2022/11/Compact-C200-Bridge-Brochure.pdf
DS Janson Bridging pedestrian bridges | Manufacturer datasheet (EN) | https://files.brintex.com/Occurrence/291/Brochure/7511/brochure.pdf
DS MAADI Make-A-Bridge aluminium | Manufacturer datasheet (EN 1999) | https://maadigroup.com/wp-content/uploads/2022/10/MAADI-Group_Catalogue_aluminum_pedestrian-bridges_other-structures.pdf
DS The Ramp Factory 15t yard ramp | Manufacturer datasheet | https://www.therampfactory.co.uk/yard-ramp-11260x2260x15000kg
DS Loading Dock Systems steel yard ramp | Manufacturer datasheet | https://www.loadingdocksystems.com/files/2021-09/m_yardramp_4111-0076_sept2018.pdf
DS Excellent Systems modular ramp | Manufacturer datasheet | https://easiaccess.co.uk/wp-content/uploads/2023/07/2023-Excellent-Systems-Brochure-Interactive.pdf
DS AA Ramps Entrada modular ramp | Manufacturer datasheet | https://aaramps.com/wp-content/uploads/2020/11/AA-tech-specs-Final-Revised-TW-050917.pdf
DS Layher Bridging system + beams | Manufacturer datasheet (EN) | https://layher.com.au/wp-content/uploads/2025/09/EN_LayherInfo_BridgingInTheSystem_8116354.pdf
