calo-lategan/Staircase/v2/out/v2c_parts_grid.png

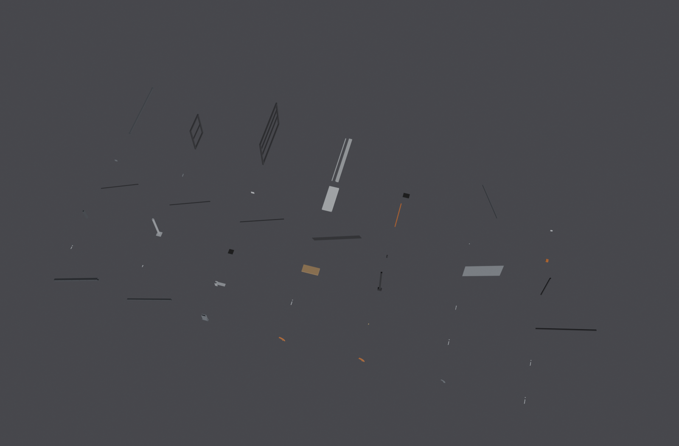
v2/out/v2c_parts_grid.png
