calo-lategan/Staircase/v2/out/full_v2.step

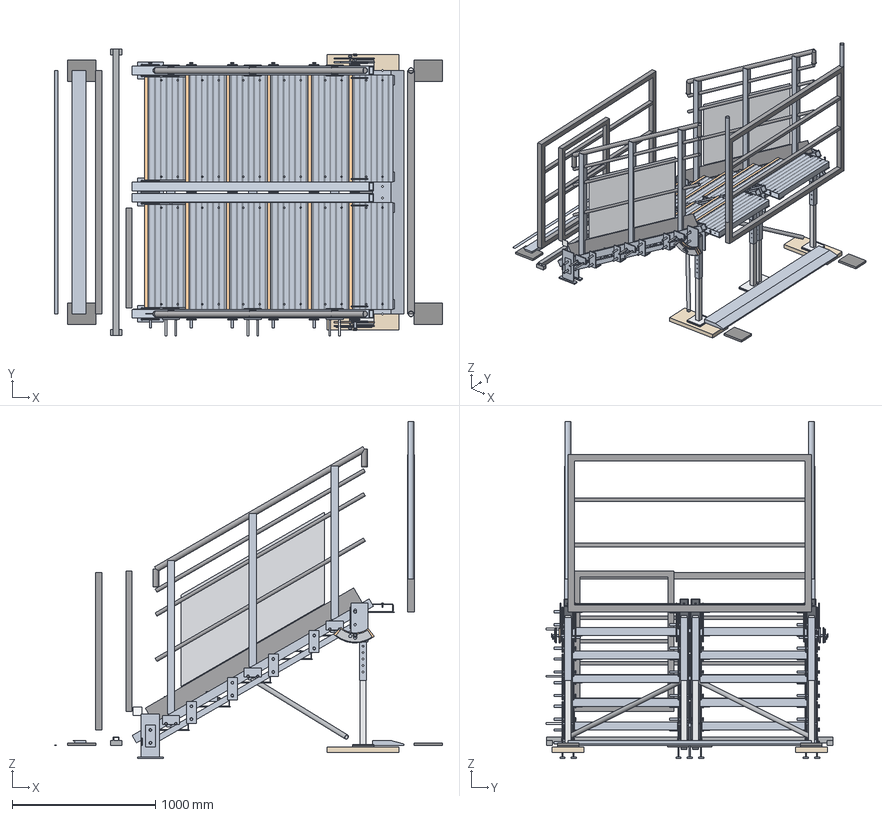
[picture p141: CAD file, 2026-09-26]
v2/out/full_v2.step
2710.0 x 2004.0 x 2355.0 mm
PRT-11-A0
BLT-M12-A0-0.5--34
BLT-M12-A0-0.5-34
BLT-M12-A0-2.5--34
BLT-M12-A0-2.5-34
BLT-M12-A0-4.5--34
BLT-M12-A0-4.5-34
RET-A0-bottom
RET-A0-top
PRT-11-A1
PRT-11-B0
PRT-11-B1
BLT-M12-B1-0.5--34
BLT-M12-B1-0.5-34
BLT-M12-B1-2.5--34
BLT-M12-B1-2.5-34
BLT-M12-B1-4.5--34
BLT-M12-B1-4.5-34
RET-B1-bottom
RET-B1-top
BLT-M8-A-0--30-0.25
BLT-M8-A-0--30-0.62
BLT-M8-A-0-780-0.25
BLT-M8-A-0-780-0.62
BLT-M8-A-1--30-0.25
BLT-M8-A-1--30-0.62
BLT-M8-A-1-780-0.25
BLT-M8-A-1-780-0.62
BLT-M8-A-2--30-0.25
BLT-M8-A-2--30-0.62
BLT-M8-A-2-780-0.25
BLT-M8-A-2-780-0.62
BLT-M8-A-3--30-0.25
BLT-M8-A-3--30-0.62
BLT-M8-A-3-780-0.25
BLT-M8-A-3-780-0.62
BLT-M8-A-4--30-0.25
BLT-M8-A-4--30-0.62
BLT-M8-A-4-780-0.25
BLT-M8-A-4-780-0.62
BLT-M8-A-5--30-0.25
BLT-M8-A-5--30-0.62
BLT-M8-A-5-780-0.25
BLT-M8-A-5-780-0.62
BLT-M8-B-0-860-0.25
BLT-M8-B-0-860-0.62
BLT-M8-B-0-1670-0.25
BLT-M8-B-0-1670-0.62
BLT-M8-B-1-860-0.25
BLT-M8-B-1-860-0.62
BLT-M8-B-1-1670-0.25
BLT-M8-B-1-1670-0.62
BLT-M8-B-2-860-0.25
BLT-M8-B-2-860-0.62
BLT-M8-B-2-1670-0.25
BLT-M8-B-2-1670-0.62
BLT-M8-B-3-860-0.25
BLT-M8-B-3-860-0.62
BLT-M8-B-3-1670-0.25
BLT-M8-B-3-1670-0.62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
