calo-lategan/Staircase/v2/out/parts/Pivot_pin_Ø16_(base_main).step

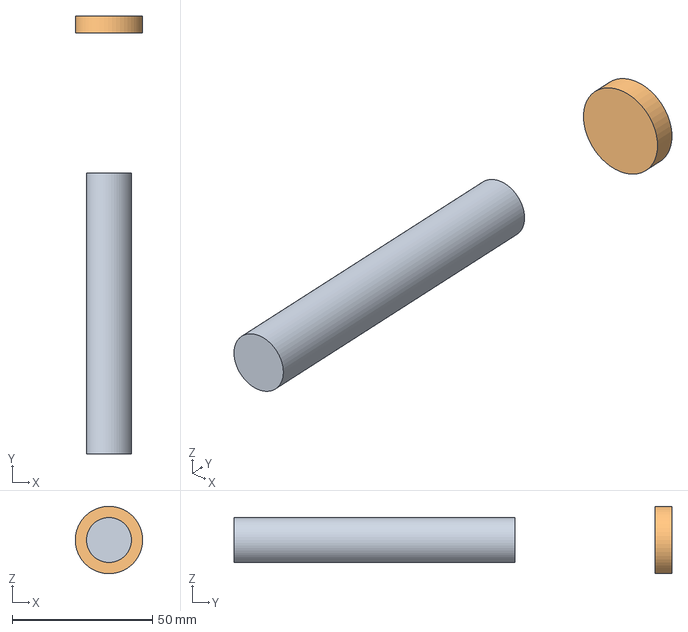
[picture p142: CAD file, 2026-09-26]
v2/out/parts/Pivot_pin_Ø16_(base_main).step
24.0 x 156.0 x 24.0 mm
