calo-lategan/Staircase/v2/out/parts/Mesh_infill_panel.step

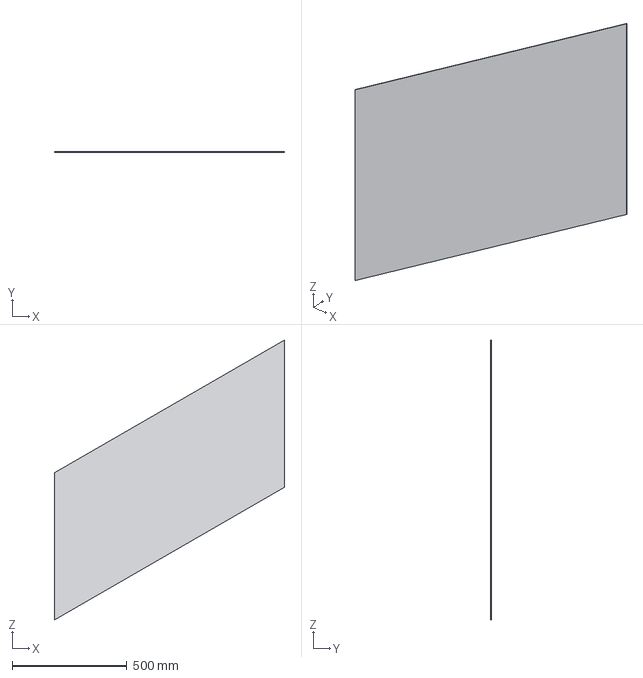
[picture p143: CAD file, 2026-09-26]
v2/out/parts/Mesh_infill_panel.step
1001.0 x 3.00 x 1217.5 mm
