calo-lategan/Staircase/v2/out/parts/Sole_board.step

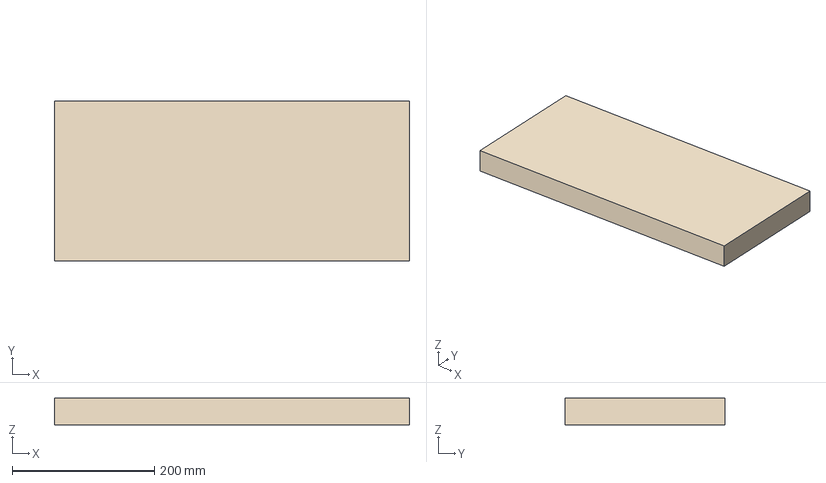
[picture p144: CAD file, 2026-09-26]
v2/out/parts/Sole_board.step
500.0 x 225.0 x 38.0 mm
