calo-lategan/Staircase/v2/out/parts/EN_131-3_pictogram_plate.step

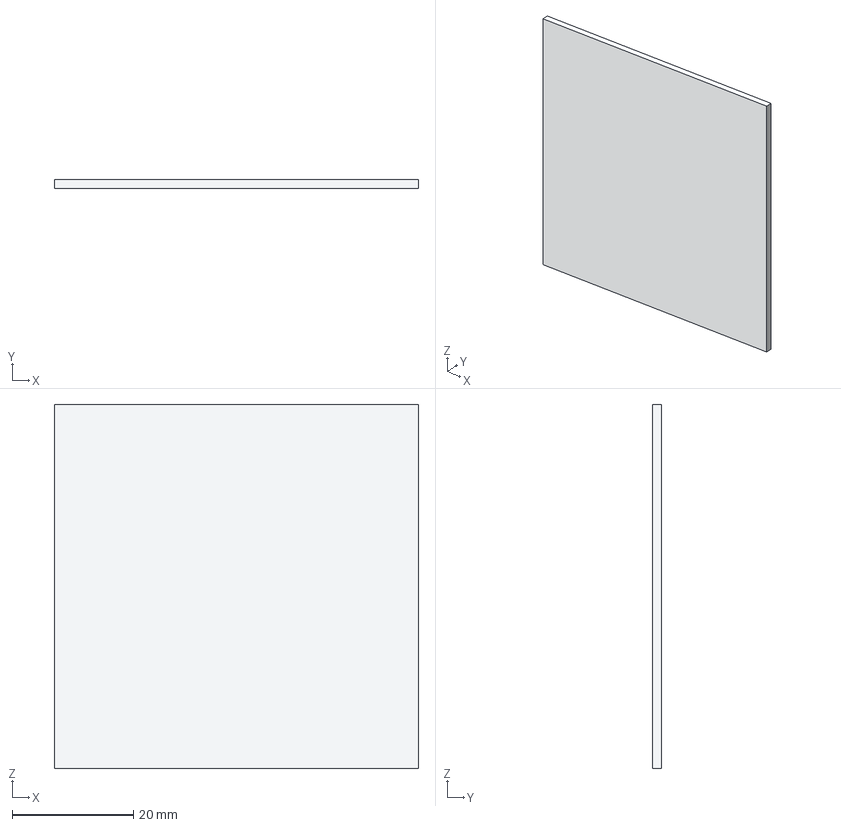
[picture p145: CAD file, 2026-09-26]
v2/out/parts/EN_131-3_pictogram_plate.step
60.0 x 1.50 x 60.0 mm
