calo-lategan/Staircase/v2/out/parts/Mid_rail_1_CHS26.9.step

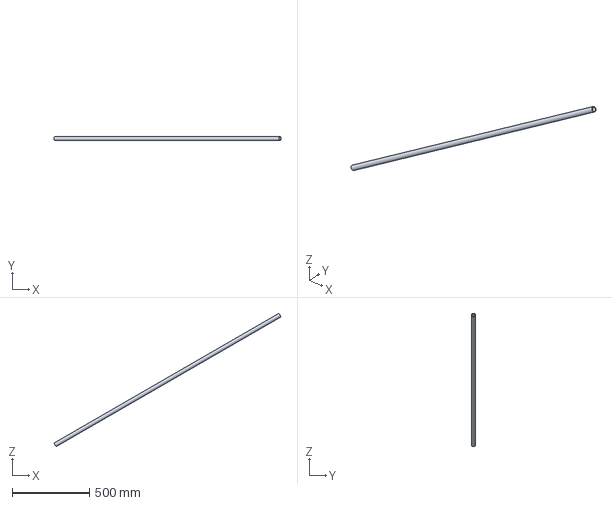
[picture p146: CAD file, 2026-09-26]
v2/out/parts/Mid_rail_1_CHS26.9.step
1469.3 x 26.9 x 863.2 mm
