calo-lategan/Staircase/v2/out/parts/Pivot_pin_Ø16_(ctl_gnd).step

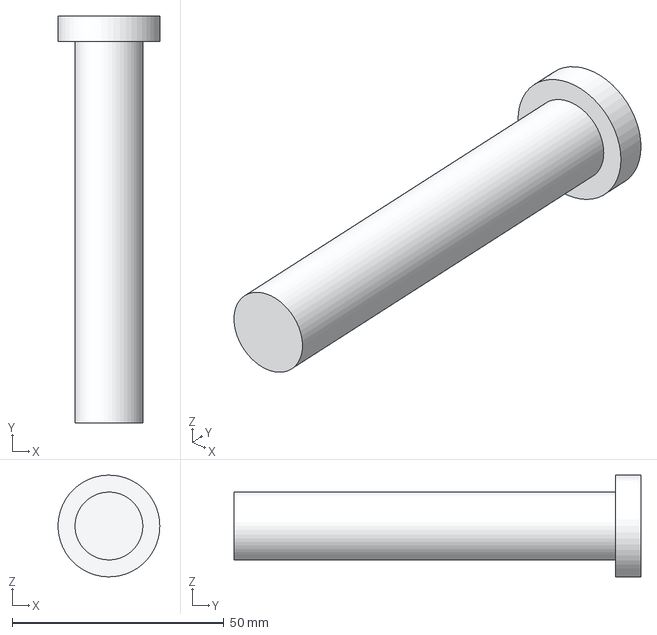
[picture p147: CAD file, 2026-09-26]
v2/out/parts/Pivot_pin_Ø16_(ctl_gnd).step
24.0 x 96.0 x 24.0 mm
