calo-lategan/Staircase/v2/out/parts/Follower_pin_Ø16.step

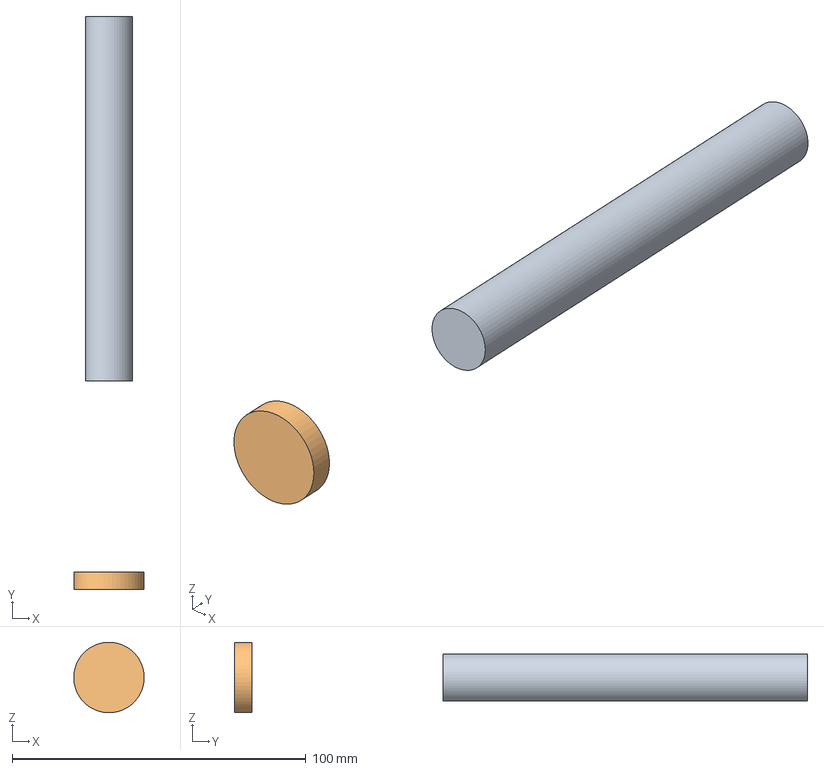
[picture p148: CAD file, 2026-09-26]
v2/out/parts/Follower_pin_Ø16.step
24.0 x 195.0 x 24.0 mm
