calo-lategan/Staircase/v2/out/parts/U-guide_cheek_(inner).step

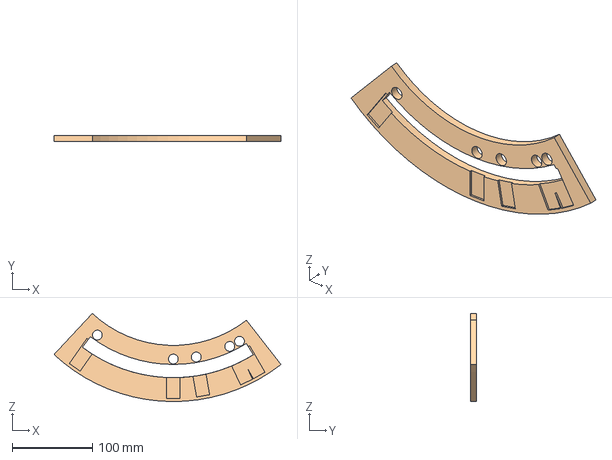
[picture p149: CAD file, 2026-09-26]
v2/out/parts/U-guide_cheek_(inner).step
282.9 x 8.00 x 109.8 mm
