calo-lategan/Staircase/v2/out/parts/Leg_upper_(pivot_head_+_socket).step

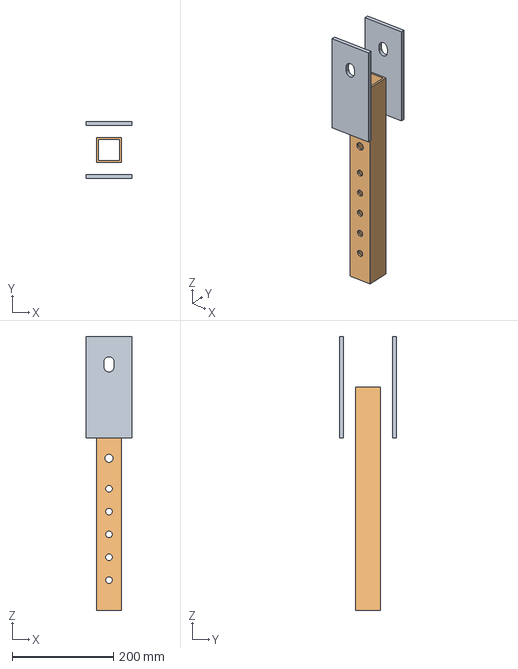
[picture p150: CAD file, 2026-09-26]
v2/out/parts/Leg_upper_(pivot_head_+_socket).step
90.0 x 112.0 x 540.0 mm
