calo-lategan/Staircase/v2/out/parts/Rating_plate.step

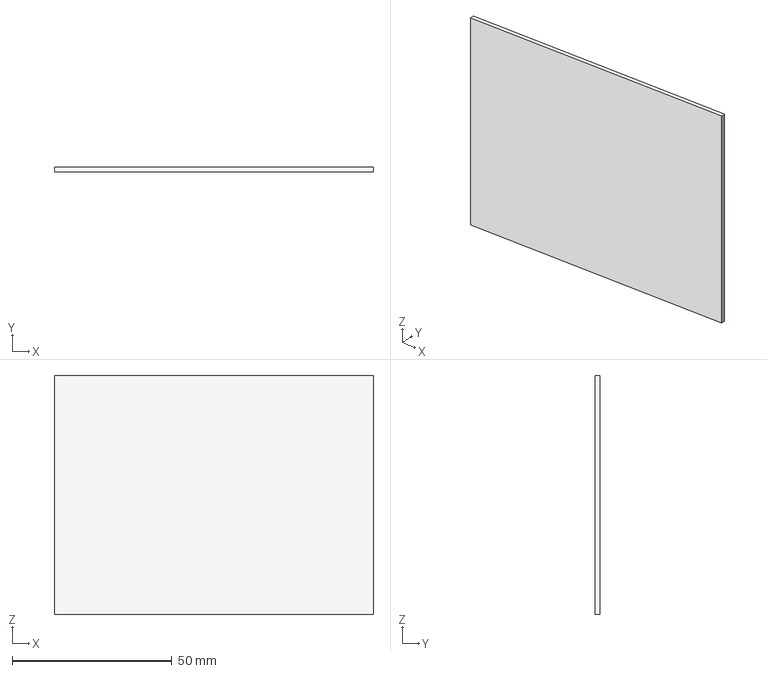
[picture p151: CAD file, 2026-09-26]
v2/out/parts/Rating_plate.step
100.0 x 1.50 x 75.0 mm
