calo-lategan/Staircase/v2/out/parts/Module_coupler_(spigot+cam).step

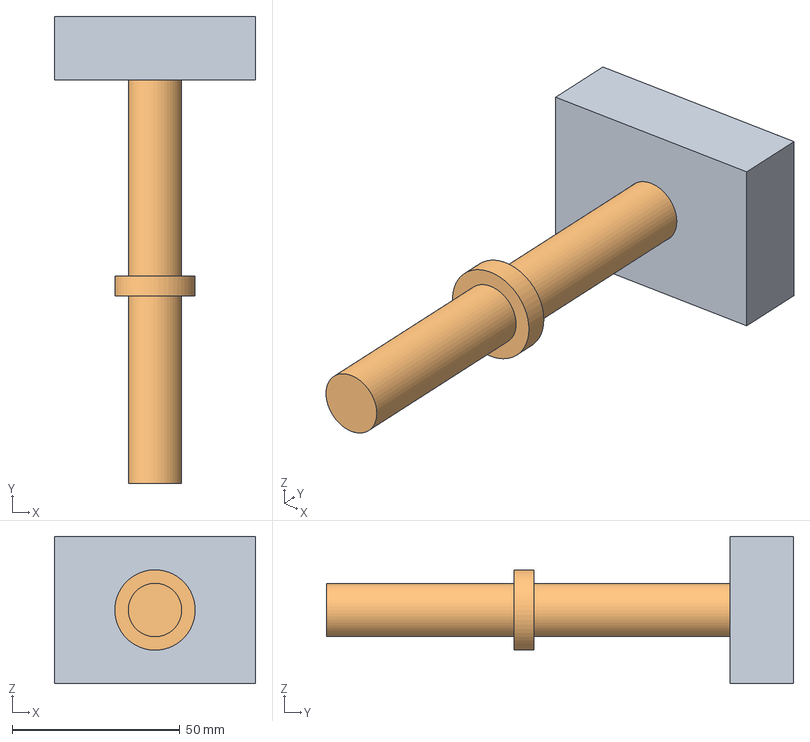
[picture p152: CAD file, 2026-09-26]
v2/out/parts/Module_coupler_(spigot+cam).step
60.0 x 139.5 x 44.0 mm
