calo-lategan/Staircase/v2/out/parts/Stabiliser_crossbar.step

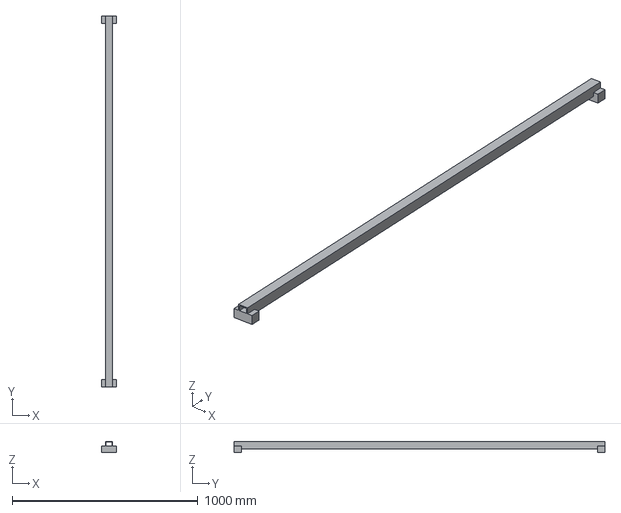
[picture p153: CAD file, 2026-09-26]
v2/out/parts/Stabiliser_crossbar.step
80.0 x 2000.0 x 60.0 mm
