calo-lategan/Staircase/v2/out/parts/Acetal_bush_20-16.2.step

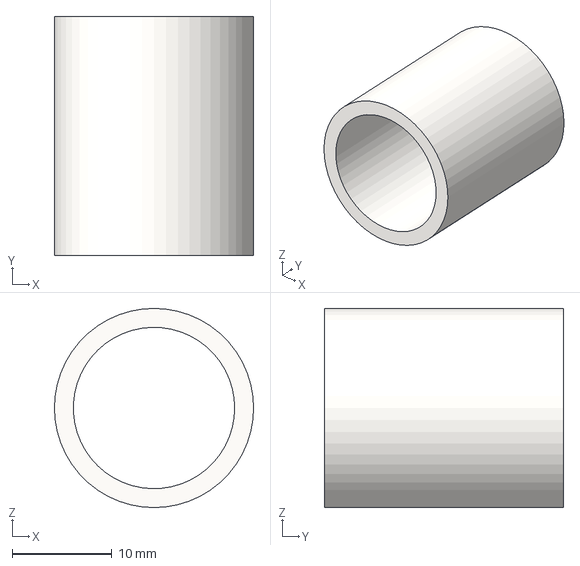
[picture p154: CAD file, 2026-09-26]
v2/out/parts/Acetal_bush_20-16.2.step
20.0 x 24.0 x 20.0 mm
