calo-lategan/Staircase/v2/out/parts/Ramp_overlay_threshold.step

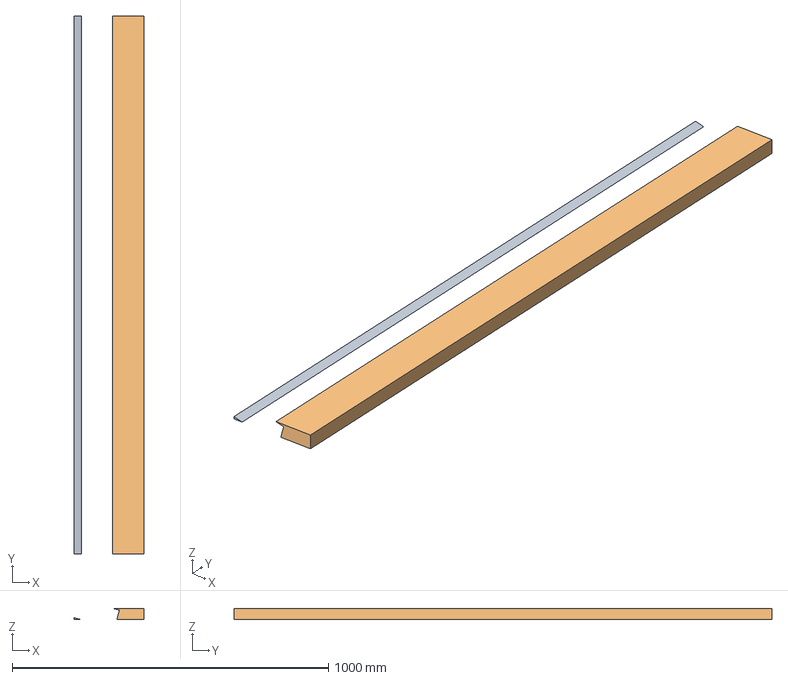
[picture p155: CAD file, 2026-09-26]
v2/out/parts/Ramp_overlay_threshold.step
220.0 x 1700.0 x 36.0 mm
