calo-lategan/Staircase/v2/out/parts/Bridge_bearing_pad.step

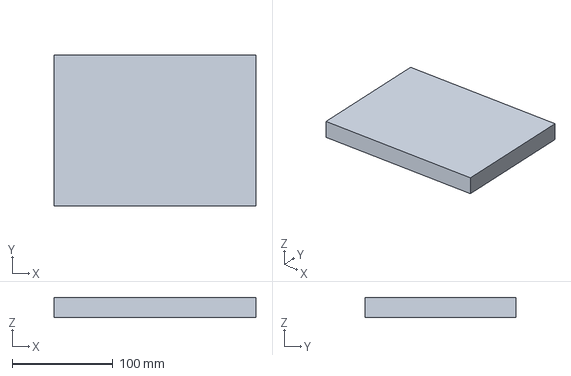
[picture p156: CAD file, 2026-09-26]
v2/out/parts/Bridge_bearing_pad.step
200.0 x 150.0 x 20.0 mm
