calo-lategan/Staircase/v2/out/parts/Latch_arm_+_plunger.step

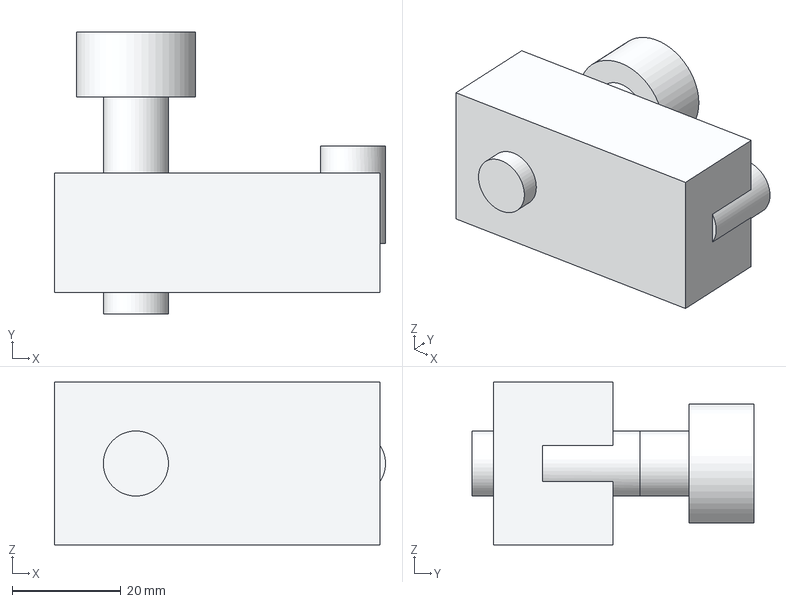
[picture p157: CAD file, 2026-09-26]
v2/out/parts/Latch_arm_+_plunger.step
61.0 x 52.0 x 30.0 mm
