calo-lategan/Staircase/v2/out/parts/Guide_cover_strip.step

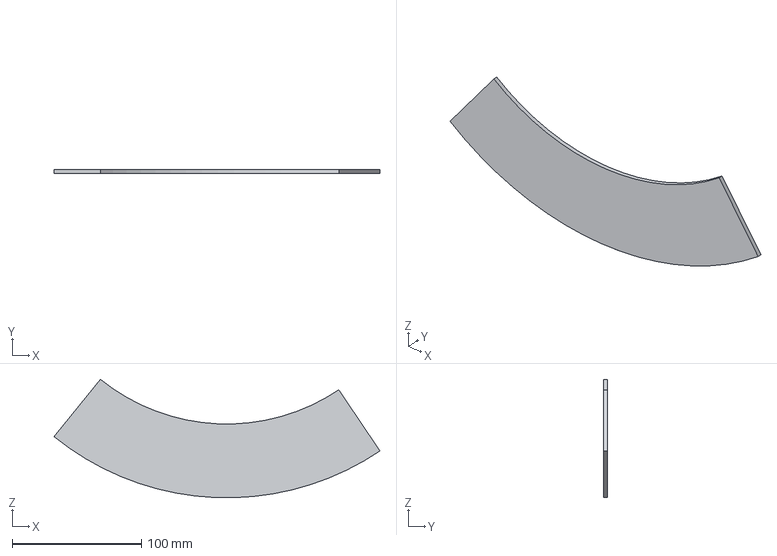
[picture p158: CAD file, 2026-09-26]
v2/out/parts/Guide_cover_strip.step
252.0 x 3.00 x 91.5 mm
