calo-lategan/Staircase/v2/out/parts/Leg_upper_(single_head).step

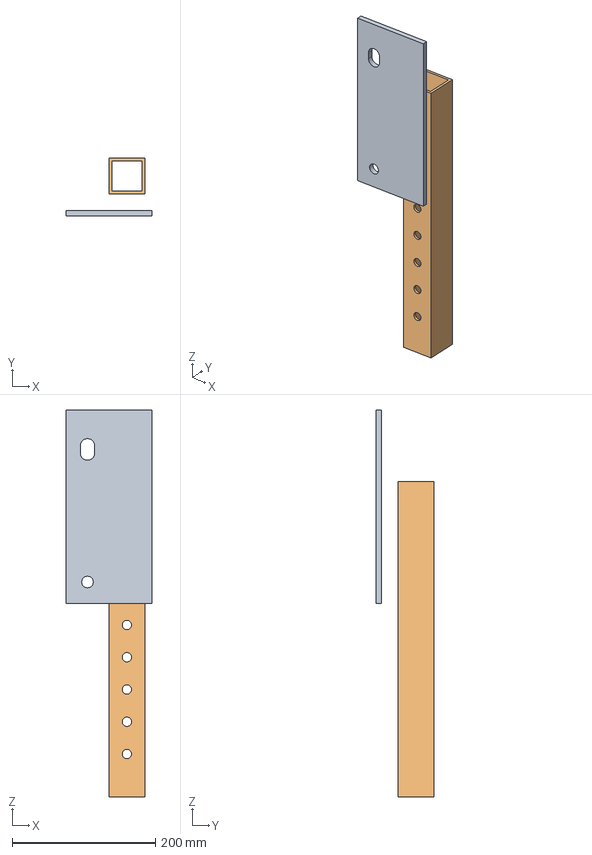
[picture p159: CAD file, 2026-09-26]
v2/out/parts/Leg_upper_(single_head).step
120.0 x 81.0 x 540.0 mm
