calo-lategan/Staircase/v2/out/parts/Diagonal_brace_CHS33.7.step

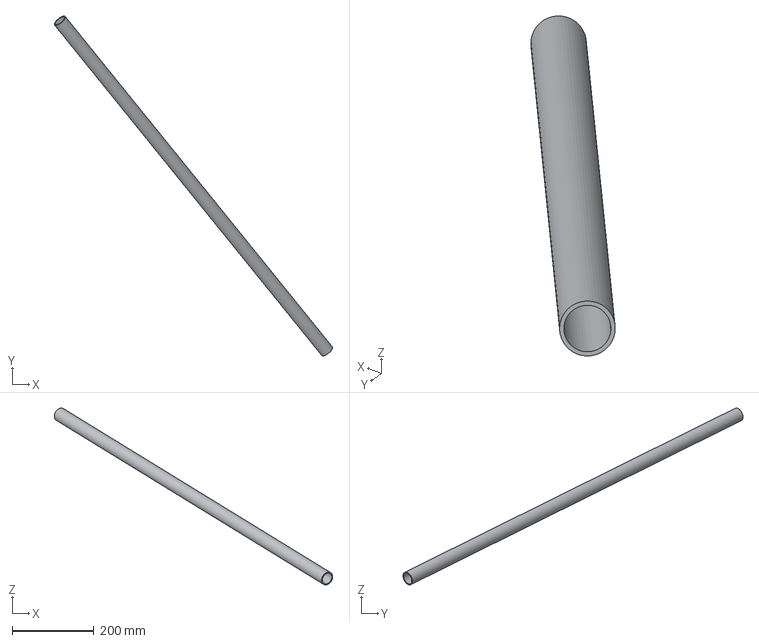
[picture p160: CAD file, 2026-09-26]
v2/out/parts/Diagonal_brace_CHS33.7.step
682.3 x 833.2 x 433.4 mm
