calo-lategan/Staircase/v2/out/parts/Carrier_(seam-clipped).step

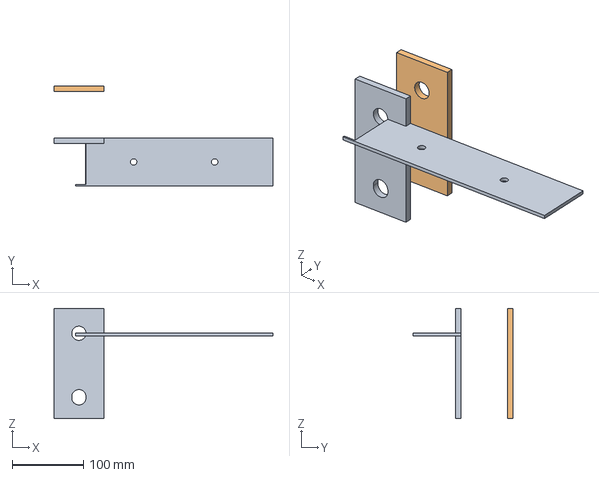
[picture p161: CAD file, 2026-09-26]
v2/out/parts/Carrier_(seam-clipped).step
308.0 x 141.0 x 155.0 mm
