calo-lategan/Staircase/v2/out/parts/Toe_board_FB150x3.step

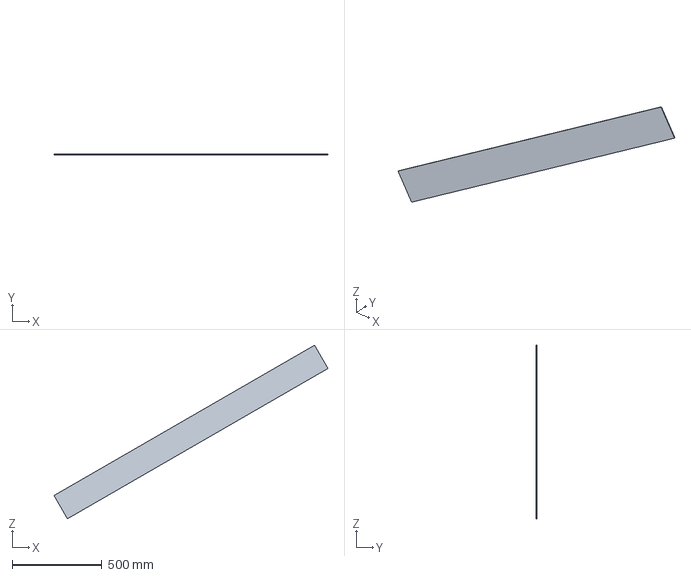
[picture p162: CAD file, 2026-09-26]
v2/out/parts/Toe_board_FB150x3.step
1530.8 x 3.00 x 969.8 mm
