calo-lategan/Staircase/v2/out/parts/Rail_return_+_end_cap.step

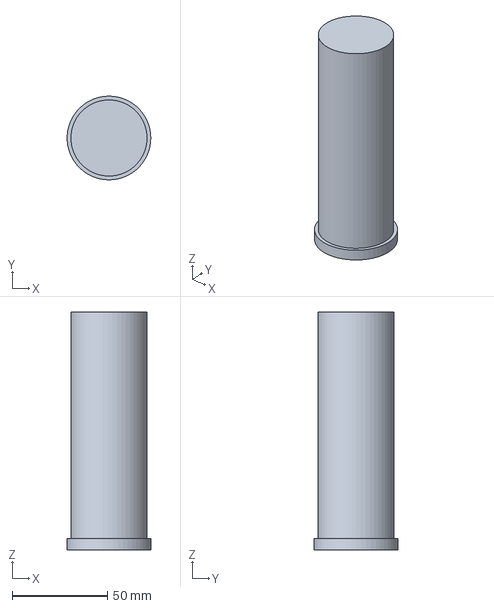
[picture p163: CAD file, 2026-09-26]
v2/out/parts/Rail_return_+_end_cap.step
44.0 x 44.0 x 125.0 mm
