calo-lategan/Staircase/v2/out/parts/Ball-lock_pin_Ø12_(secondary).step

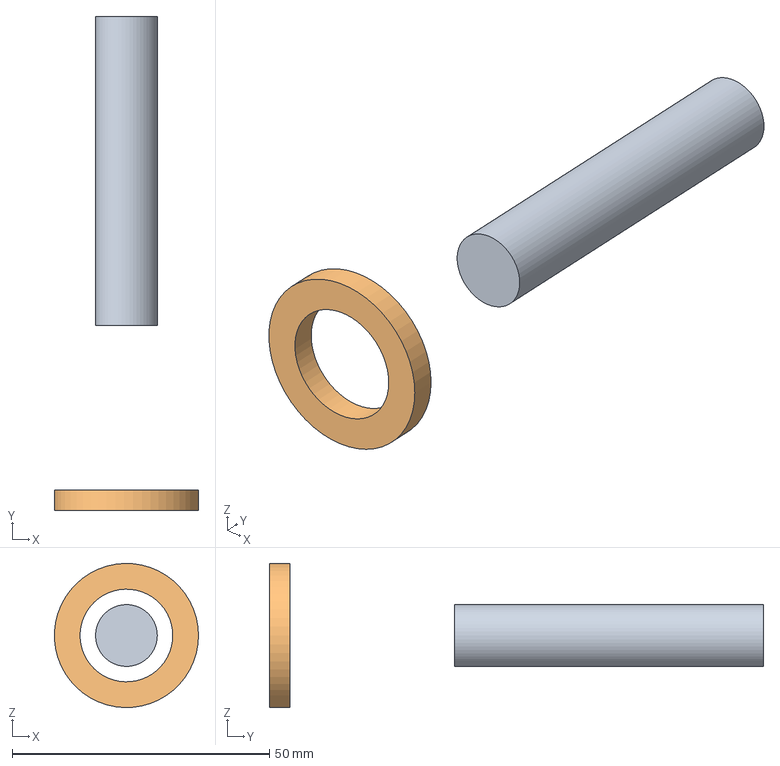
[picture p164: CAD file, 2026-09-26]
v2/out/parts/Ball-lock_pin_Ø12_(secondary).step
28.0 x 96.0 x 28.0 mm
