calo-lategan/Staircase/v2/out/parts/Index_plunger_Ø12.step

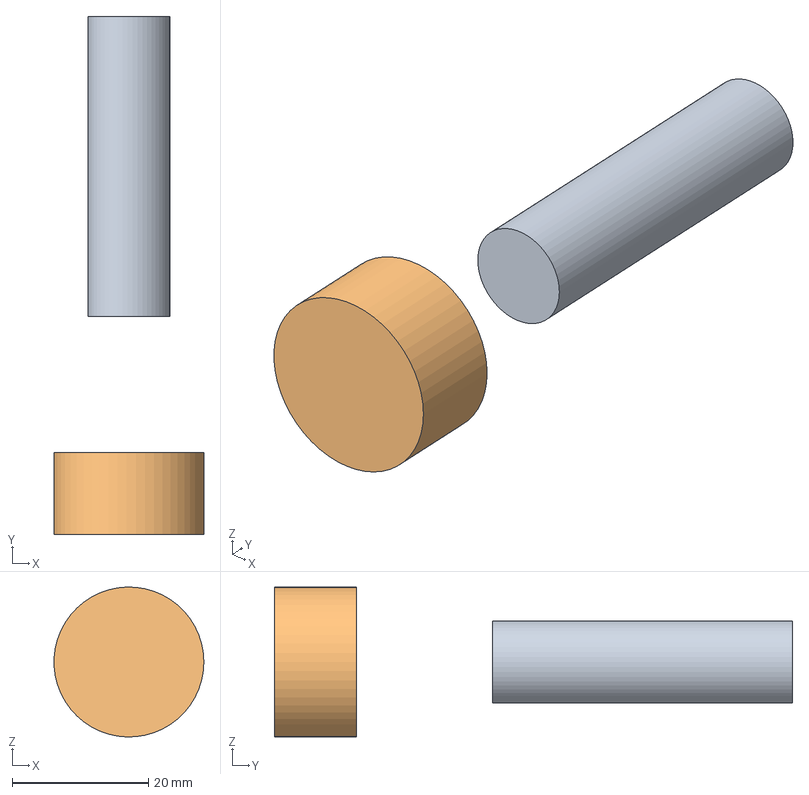
[picture p165: CAD file, 2026-09-26]
v2/out/parts/Index_plunger_Ø12.step
22.0 x 76.0 x 22.0 mm
