calo-lategan/Staircase/v2/out/parts/Top_grip_rail_CHS40x3.step

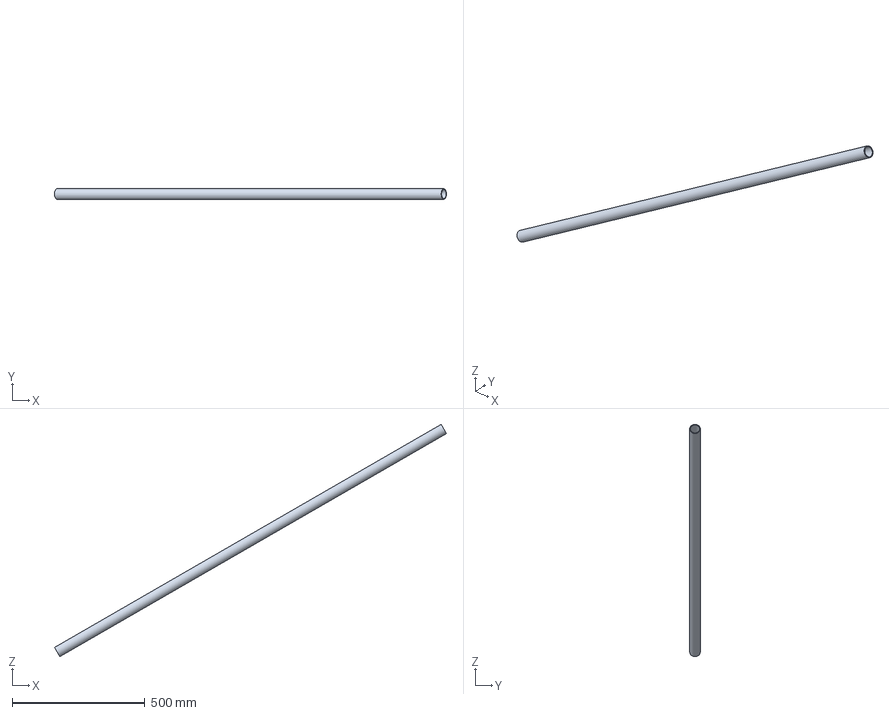
[picture p166: CAD file, 2026-09-26]
v2/out/parts/Top_grip_rail_CHS40x3.step
1475.8 x 40.0 x 874.5 mm
