calo-lategan/Staircase/v2/out/parts/Lifting_lug.step

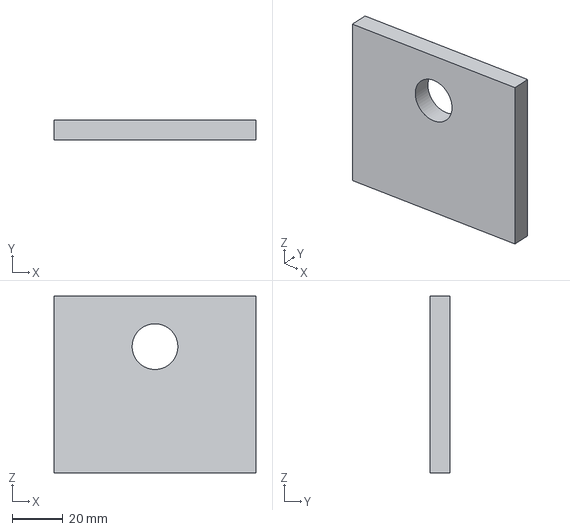
[picture p167: CAD file, 2026-09-26]
v2/out/parts/Lifting_lug.step
80.0 x 8.00 x 70.0 mm
