calo-lategan/Staircase/v2/out/parts/Base_pivot_bracket.step

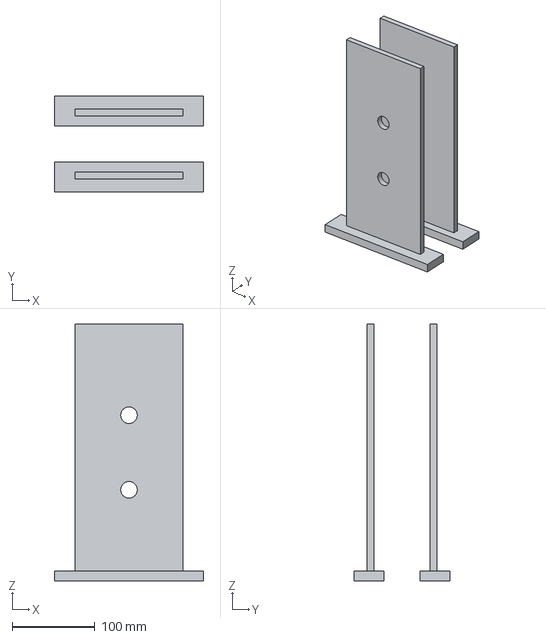
[picture p168: CAD file, 2026-09-26]
v2/out/parts/Base_pivot_bracket.step
180.0 x 116.0 x 310.0 mm
