calo-lategan/Staircase/v2/out/parts/Rubber_foot_pad.step

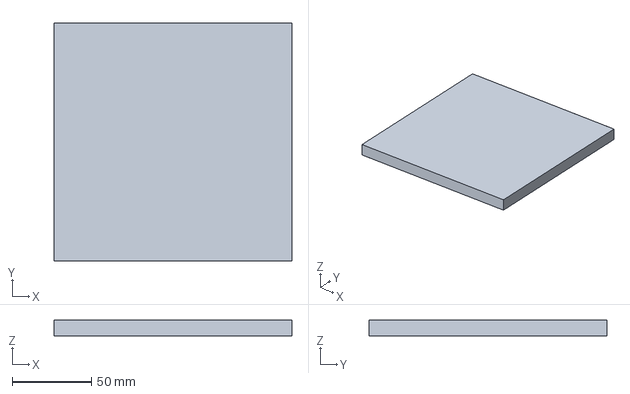
[picture p169: CAD file, 2026-09-26]
v2/out/parts/Rubber_foot_pad.step
150.0 x 150.0 x 10.0 mm
