calo-lategan/Staircase/v2/out/parts/Contrast_nosing_strip.step

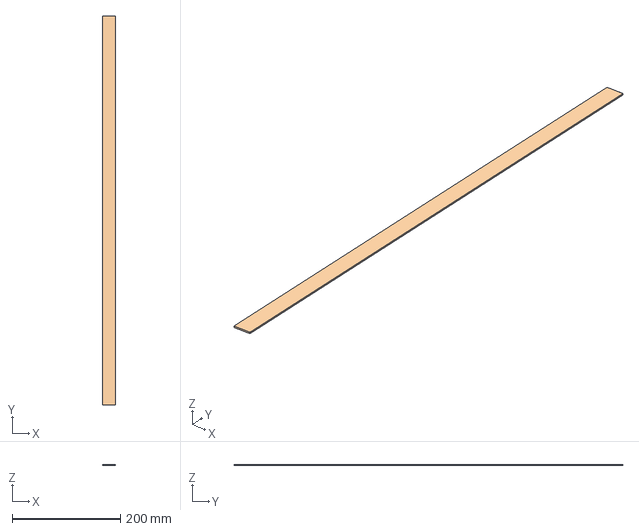
[picture p170: CAD file, 2026-09-26]
v2/out/parts/Contrast_nosing_strip.step
24.0 x 718.0 x 2.00 mm
