calo-lategan/Staircase/v2/out/parts/Handhold_extension_(ladder).step

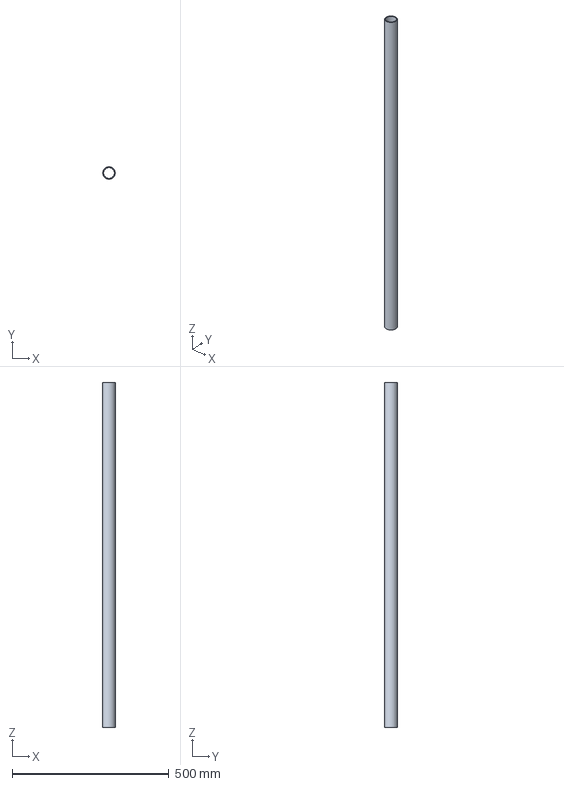
[picture p171: CAD file, 2026-09-26]
v2/out/parts/Handhold_extension_(ladder).step
40.0 x 40.0 x 1100.0 mm
