calo-lategan/Staircase/v2/out/parts/Tread_plank.step

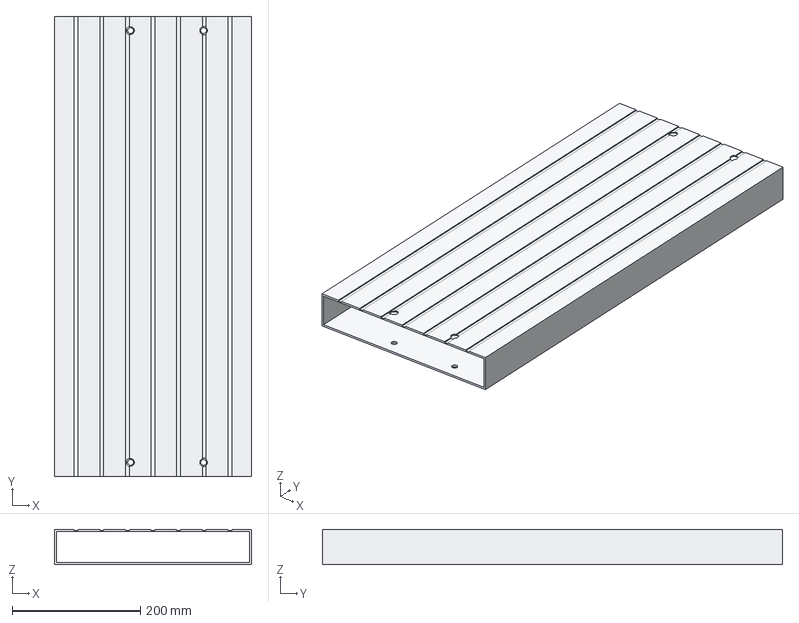
[picture p172: CAD file, 2026-09-26]
v2/out/parts/Tread_plank.step
308.0 x 718.0 x 55.0 mm
