calo-lategan/Staircase/v2/out/parts/Leg_upper_(twin_head).step

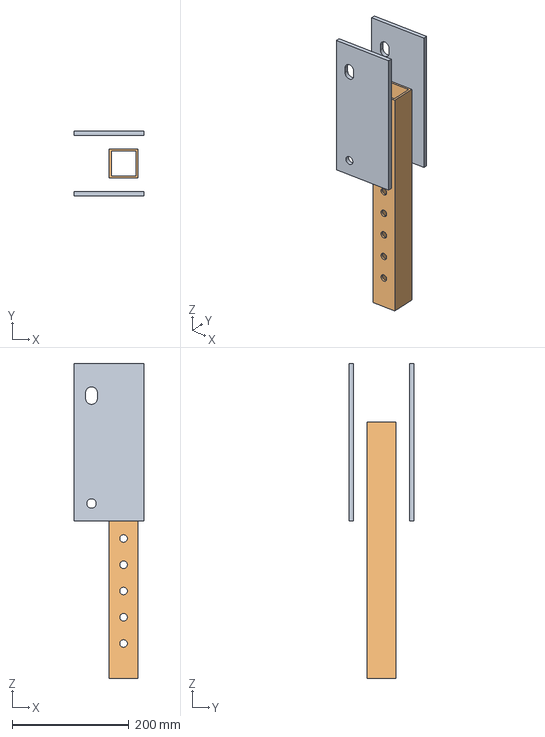
[picture p173: CAD file, 2026-09-26]
v2/out/parts/Leg_upper_(twin_head).step
120.0 x 112.0 x 540.0 mm
