calo-lategan/Staircase/v2/out/parts/Stringer.step

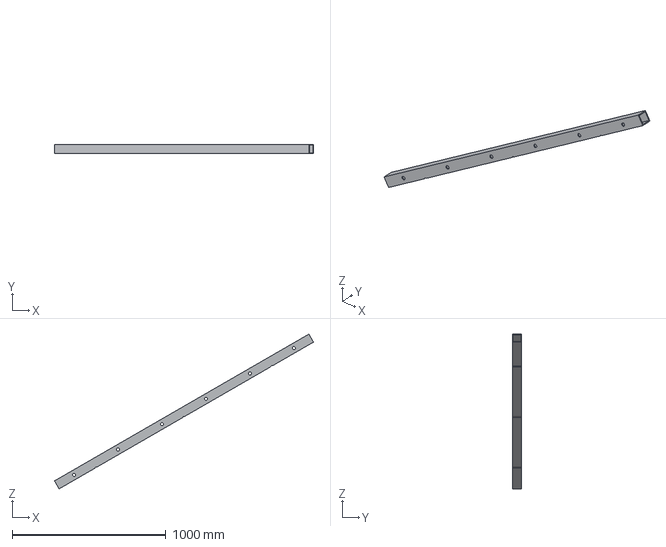
[picture p174: CAD file, 2026-09-26]
v2/out/parts/Stringer.step
1685.2 x 60.0 x 1006.9 mm
