calo-lategan/Staircase/v2/out/parts/U-guide_quadrant_plate.step

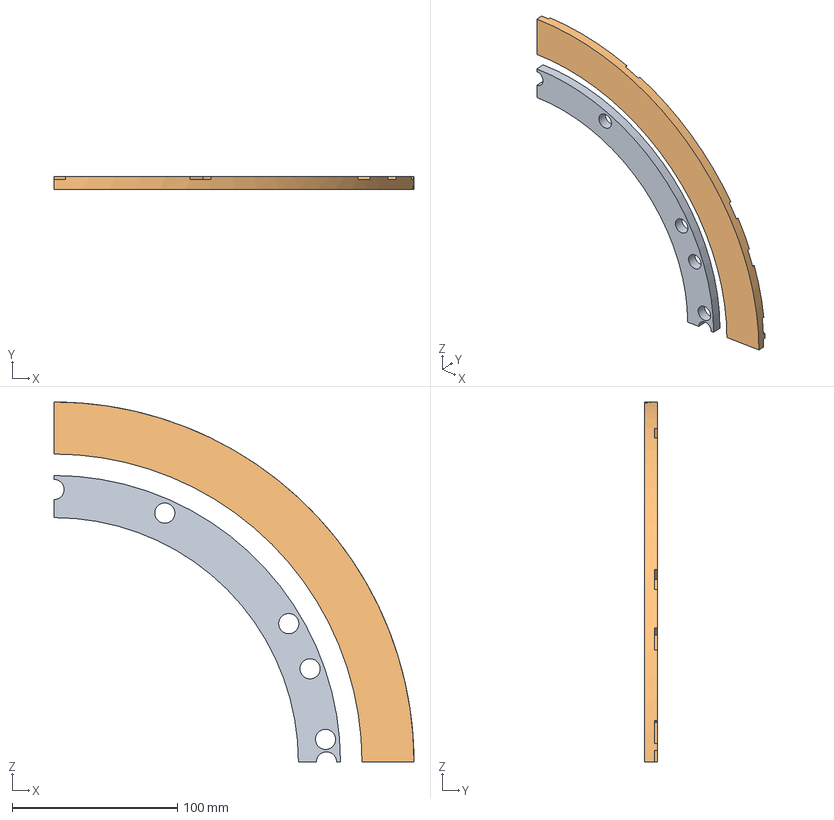
[picture p175: CAD file, 2026-09-26]
v2/out/parts/U-guide_quadrant_plate.step
218.0 x 8.00 x 218.0 mm
