calo-lategan/Staircase/v2/out/parts/Guardrail_post_+_saddle.step

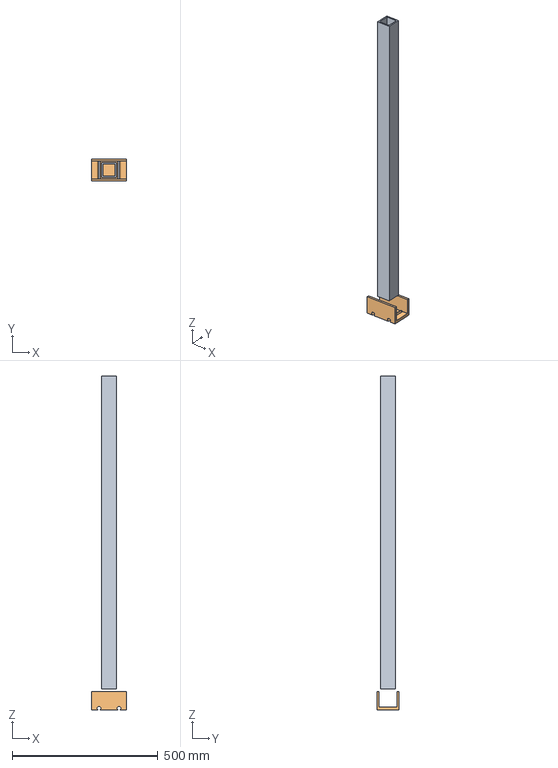
[picture p176: CAD file, 2026-09-26]
v2/out/parts/Guardrail_post_+_saddle.step
120.0 x 76.0 x 1144.0 mm
