calo-lategan/Staircase/v2/out/parts/Self-closing_gate.step

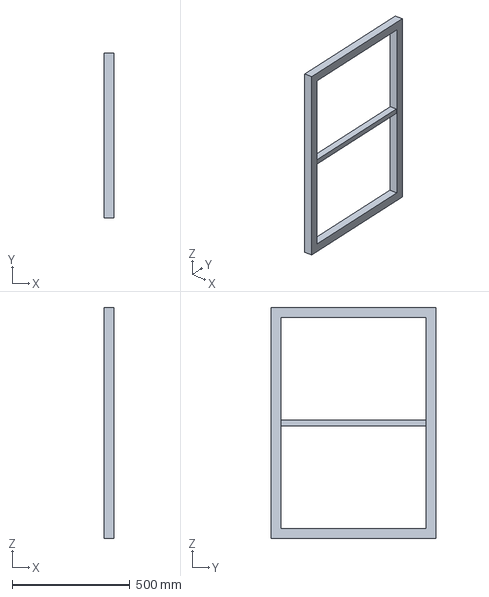
[picture p177: CAD file, 2026-09-26]
v2/out/parts/Self-closing_gate.step
42.0 x 700.0 x 980.0 mm
