calo-lategan/Staircase/v2/out/parts/Leg_socket.step

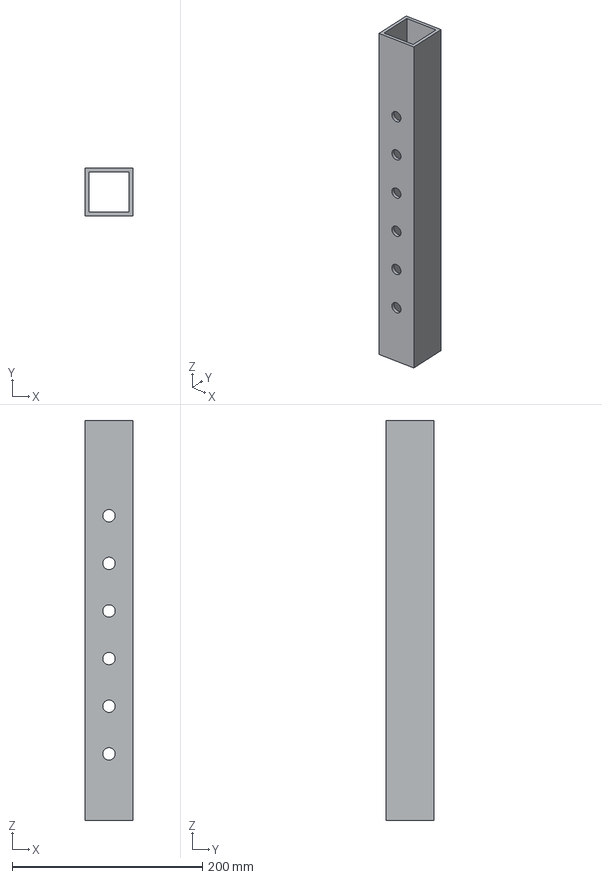
[picture p178: CAD file, 2026-09-26]
v2/out/parts/Leg_socket.step
50.0 x 50.0 x 420.0 mm
