calo-lategan/Staircase/v2/out/parts/Ballast-anchor_lug.step

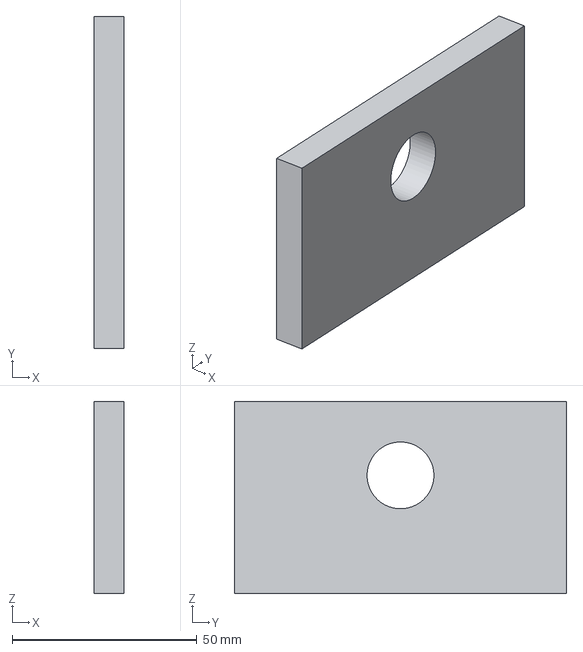
[picture p179: CAD file, 2026-09-26]
v2/out/parts/Ballast-anchor_lug.step
8.00 x 90.0 x 52.0 mm
