calo-lategan/Staircase/v2/out/parts/Carrier.step

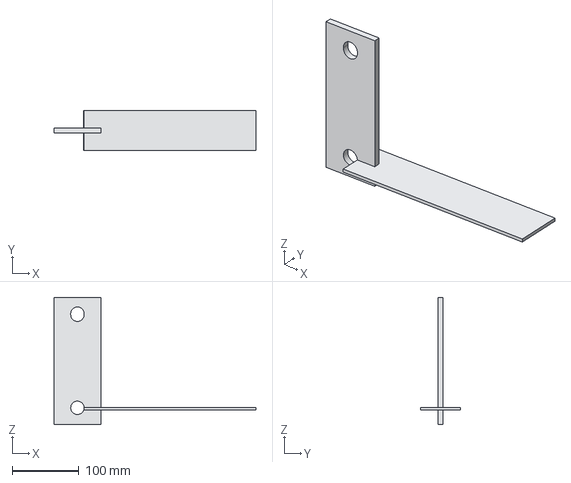
[picture p180: CAD file, 2026-09-26]
v2/out/parts/Carrier.step
302.0 x 60.0 x 190.0 mm
