calo-lategan/Staircase/v2/out/parts/Module_coupler.step

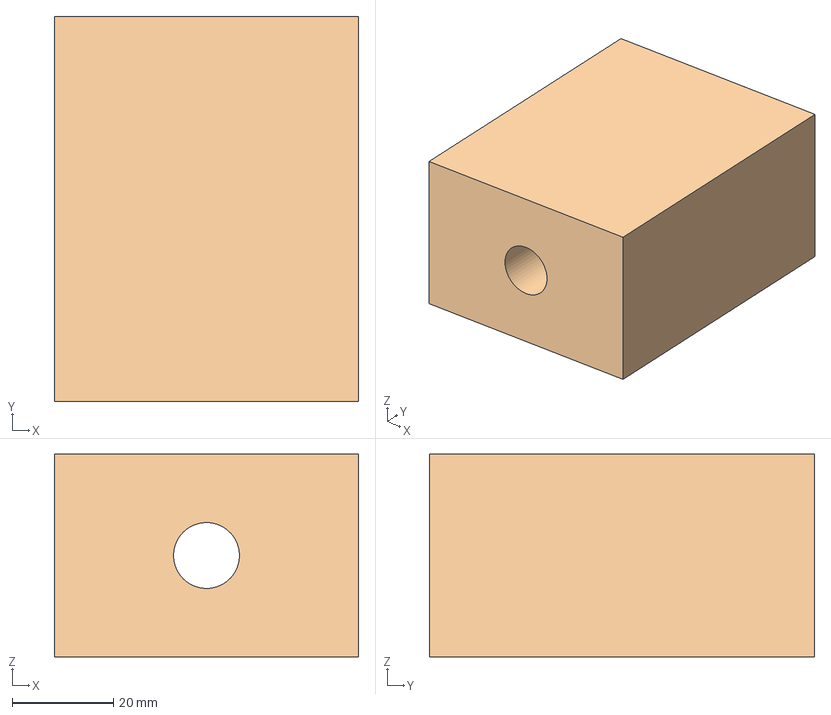
[picture p181: CAD file, 2026-09-26]
v2/out/parts/Module_coupler.step
60.0 x 76.0 x 40.0 mm
