calo-lategan/Staircase/v2/out/parts/Guardrail_post.step

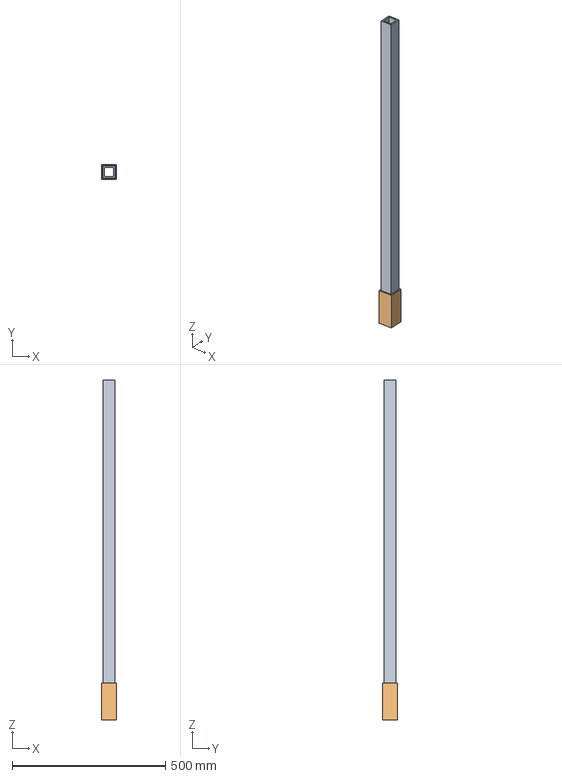
[picture p182: CAD file, 2026-09-26]
v2/out/parts/Guardrail_post.step
50.0 x 50.0 x 1110.0 mm
