calo-lategan/Staircase/v2/out/parts/End_guardrail_panel.step

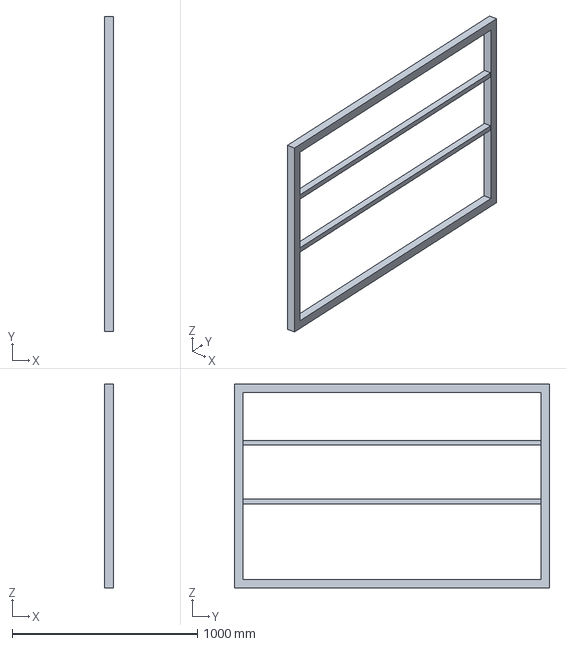
[picture p183: CAD file, 2026-09-26]
v2/out/parts/End_guardrail_panel.step
46.0 x 1700.0 x 1100.0 mm
