calo-lategan/Staircase/v2/out/parts/Control_bar.step

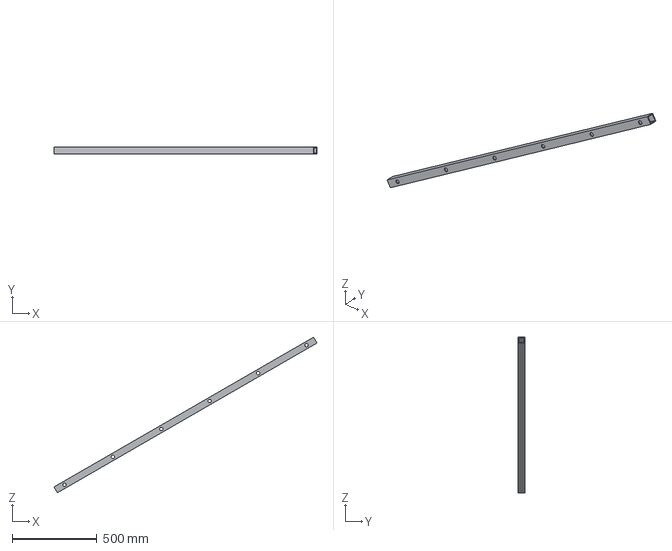
[picture p184: CAD file, 2026-09-26]
v2/out/parts/Control_bar.step
1553.9 x 40.0 x 919.6 mm
