calo-lategan/Staircase/v2/out/parts/Leg_slider_+_footplate.step

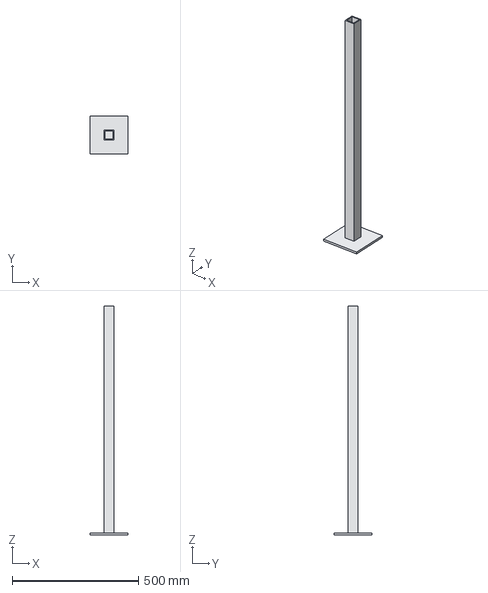
[picture p185: CAD file, 2026-09-26]
v2/out/parts/Leg_slider_+_footplate.step
150.0 x 150.0 x 908.0 mm
