calo-lategan/Staircase/(list of files, cad)

Other CAD files:
v2/out/parts/Pivot_pin_Ø16_(base).step
v2/out/parts/Ramp_rail_950_CHS26.9_(clip-on).step
v2/out/parts/Pivot_pin_Ø16_(base_ctl).step
v2/out/parts/Carrier_(twin_cheek).step
v2/out/parts/DU_bush_20-16.1x20.step
v2/out/parts/Mid_rail_2_CHS26.9.step
v2/out/parts/U-guide_cheek_(outer).step
v2/out/parts/Pivot_pin_Ø16.step
v2/final/FINAL_standard.blend
v2/out/Latest 21-09-2026/STEP LADDER RIGGED.blend
v2/out/Latest 21-09-2026/STEP LADDER RIGGED2.blend
v2/out/Latest 21-09-2026/STEP LADDER RIGGED3.blend
v2/out/Latest 21-09-2026/final STEP LADDER 22-9-2026.ifc.metadata.blend
v2/out/parts/Bolt_M12x110_8.8_HDG_+_nut.step
v2/out/parts/Bolt_M8x25_csk_A4.step
v2/out/parts/Bolt_M8x25_csk_A4_(pair_ends).step
v2/out/steel_steps_ifc_bonsai.blend
v2/out/step_ladder_ifc_CLEAN.blend
v2/out/step_ladder_ifc_bonsai.blend
