calo-lategan/Staircase/v2/out/v2b_guide.png

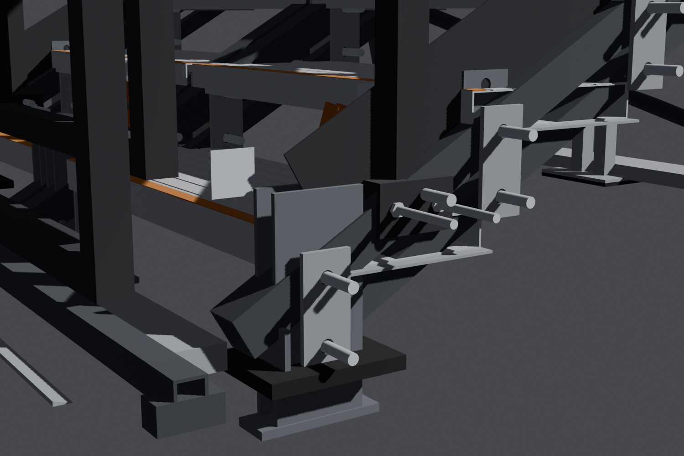
v2/out/v2b_guide.png
