calo-lategan/Staircase/v2/revc/review/step_profile_owner.png

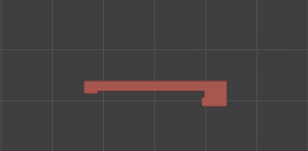
v2/revc/review/step_profile_owner.png
