calo-lategan/Staircase/v2/revc/review/benchmark.md

# Benchmark: owner's folding aluminium event stair vs off-the-shelf systems

Date: 2026-09-26. Web research only.

**Method and verification caveat.** The network proxy blocked direct page and PDF fetches for every manufacturer site (layher, peri, haki, prolyte, eurotruss, litectruss, alustage, nivtec, scenesalg). Every figure below therefore comes from **search-engine extracts of the cited pages**, not from reading the documents directly. Tags used:

- **[S]**: the figure appeared in a search extract attributed to the cited URL. It is likely correct, but check it against the datasheet before relying on it.
- **[U]**: unverified or inferred, including my own arithmetic and conversions.
- **"n/f"**: not found in public sources.

No prices or ratings have been invented.

---

## 1. System-by-system findings

### 1.1 Layher Allround stairway tower 750 (public / event access)
- **Use:** Layher positions it for public areas and for event stage and grandstand access "due to its reduced rise dimensions" [S] ([baumagazin-online](https://www.baumagazin-online.de/d/neue-systemloesungen-fuer-layher-treppentuerme/), [Layher NA](https://layherna.com/public-access-stairs/)).
- **Material:** steel U-stringers ("Treppenwange 750 LW") with standard Allround steel or aluminium decks as treads. The flight width varies with the decks: 1.29 to 2.07 m [S] ([Layher NA](https://layherna.com/public-access-stairs/)).
- **Geometry:** rise 166 mm, going 310 to 315 mm (about 28°) [S] ([hawego 8-step stringer](https://www.hawego.de/layher-u-treppenwange-750-lw-8-stufen-lg-2639.008)).
- **Load:** 7.5 kN/m² at a 2.07 m flight width [S] (same source). Layher's stair range as a whole covers 2 to 7.6 kN/m² [S].
- **Weights and price:**
  - Stringer 750 LW, 8 steps (1.50 m lift, 2.57 m run): **36.4 kg each, €509 incl. VAT** [S] ([hawego](https://www.hawego.de/layher-u-treppenwange-750-lw-8-stufen-lg-2639.008)).
  - Stair railing 750 T12, 5 steps: 24.3 kg [S] ([hawego](https://www.hawego.de/layher-treppengelaender-750-t12-5-stufen-lg-2616.105)).
  - Guardrail T12 "mit Kindersicherung" (child-safe infill) 2.57 m: 35.8 kg, 1.10 m high, and height-adjustable [S] ([hawego](https://www.hawego.de/layher-gelaender-t12-mit-kindersicherung-2-57-m-lg-2616.257), [pasvatek](https://www.pasvatek.de/produkt/layher-ev-gelaender-207m-x-110m-t12-mit-kindersicherung-sicherheitsgelaender-hoehenverstellbar/)).
  - The 12 cm bar spacing on T12 appeared only in a generic extract [U].
- **Connections:**
  - Wedge-head into rosette; ledgers have an AutoLock (gravity pre-lock) [S] ([Layher NA Allround](https://layherna.com/allround-scaffolding/)).
  - The handrail uses only three parts: handrail holder, joint and tube [S] ([Layher NA](https://layherna.com/public-access-stairs/)).
  - Deck locking clamps [S].
  - Height adjustment comes from Allround base jacks (standard scaffold) [U: range not captured].
- **Standards:** German approval (Z-8.1-series) and EN 12811 context are probable but **not captured** [U]. The UK distributor claims Building Regulations Part K/B compliance [S] ([georgeroberts](https://georgeroberts.com/products/system-scaffolding/layher-500750-public-access-staircase/)).
- **Folding:** none. The stair is erected from components.

### 1.2 PERI UP Public Stair (Rosett Public)
- **Widths:** single flights of 1.50, 2.00 or 2.50 m. Wider stairs are built as a series of flights [S] ([concreteconnect](https://www.concreteconnect.co.uk/news/peri-rolls-out-new-public-stair-system-in-uk), [scaffmag](https://scaffmag.com/2025/07/new-peri-up-stair-system-launched-in-uk-after-global-debut/)).
- **Load:** up to 7.5 kN/m² [S].
- **Barriers and building code:**
  - Handrails are system-integrated and child-safe.
  - PERI states it meets building-code requirements for step dimensions, fall-through protection, railing impact loads and vandal resistance [S] ([bauhandwerk](https://www.bauhandwerk.de/artikel/oeffentliche-treppe-auf-baustellen-4262152.html), [peri.at](https://www.peri.at/produkte/geruestsysteme/zugaenge-treppen/peri-up-rosett-treppe-fuer-oeffentlichen-bereich.html)).
  - Rise/going and the barrier kN/m value were **not captured** [U].
- **Components:** only 7 new parts on top of PERI UP Flex.
  - **Gravity locks:** the wedge head drops into the rosette under its own weight and locks [S] ([scaffmag](https://scaffmag.com/2025/07/new-peri-up-stair-system-launched-in-uk-after-global-debut/)).
  - **Expansion locks** [S].
  - Integrated height adjustment [S].
- **Price, weight:** n/f.

### 1.3 HAKI Public Access Stair (PAS)
- **Bays:** widths 1250, 1655 or 1964 mm; lengths 1655 or 2500 mm; lift heights 500, 1000 or 1500 mm [S] ([HAKI manual](https://api.haki.com/storage/media/0addcd30-fdad-43eb-ad65-26a6e0be637a/user_guide_haki_public_access_stair_en.pdf)).
- **Geometry:** rise/going **167/280 mm, 31°** [S] (same source).
- **Load:** 7.5 kN/m² on flights and landings [S].
- **Material:** hot-dip galvanised steel. Treads are aluminium planks or steel chequer plate [S] ([HAKI CA](https://ca.haki.com/products/access/stair-solutions/stair/public-access-stair)).
- **Child safety:**
  - No opening between treads, in handrails or in guardrails passes a **100 mm sphere** [S] ([UKSSH](https://ukssh.co.uk/en/product-detail/1/public-access-staircases/)).
  - The design uses **tamper-proof / child-proof locking devices** and height-adjustable handrails [S].
  - Toeboards are listed as components [S].
- **Standards:** BS 5973 is claimed [S]. The barrier kN/m rating was **not captured** [U].
- **Price, weight:** n/f.

### 1.4 LITEC Foldable Stage Stair-Deck (the closest analogue to the owner's unit)
- **Construction:** all-aluminium. It folds and **self-adjusts to stage height**: only the pitch changes, and the foot stays grounded [S] ([LITEC](https://www.litectruss.com/products/foldable-stage-stair-deck/)).
- **Models:**
  - Fits the Layher Event 2.57 × 1.04 m deck: **7 steps, 98.5 kg**.
  - Fits the 2.07 × 1.04 m deck: **80 kg**.
  - Both [S]. Other stage systems are made on request [S].
- **Treads:** aluminium with an anti-slip finish and **drainage holes** [S].
- **Folding:** a **spring-assisted lift/lower** mechanism [S].
- **Rating, standards, handrail rating, price:** n/f.

### 1.5 Nivtec stairs (stage and grandstand)
- **Construction:** aluminium frame with 12 mm phenolic ply treads; stack height 9 cm [S] ([scenesalg](https://scenesalg.dk/en/stages-and-stage-platforms/nivtec/nivtec-stairs/)).
- **Load:** **7.5 kN/m²** [S].
- **Standards:** TÜV-approved to **EN 13814**, and certified by the Danish Technological Institute [S].
- **Modular build:** a start part, middle parts and an end part. Each step needs 2 stair bolts and 2 treads [S]. The recommended stair width is 150 cm [S].
- **Railings:**
  - Rated **100 kg/m (about 1.0 kN/m)** [S; the conversion is U].
  - Grandstand railing is 110 cm high with vertical bars.
  - The railing "pulls down over railing bolts", a drop-over post [S] ([scenesalg rail](https://scenesalg.dk/en/stages-and-stage-platforms/nivtec/nivtec-handrail/)).
- **Adjustment:** legs give heights up to 180 cm [S].

### 1.6 Prolyte StageDex stairs
- **SM-STAIR-500 adjustable stair:**
  - Basic element of 6 steps, top step aligns with the deck, max **500 kg/m² (about 4.9 kN/m²)** [S] ([Prolyte](https://www.prolyte.com/products/portable-stages/stagedex/stagedex-stairs/sm-stair-500-basic-5-step-beam)).
  - Extend it with 1 to 5 step add-ons [S].
- **Modular stair unit 400 mm:** 910 × 225 × 400 mm, **8.23 kg**. Units bolt together in 20 cm increments and couple side by side for width [S].
- **Accessories:** a separate railing and stair-to-deck connector exist [S].
- **Standards, width of the adjustable model:** n/f.

### 1.7 Eurotruss / Alustage / BÜTEC / others
- **Eurotruss adjustable stairs:**
  - Steel sections with anti-slip ply; "self-angled" through movable steps [S].
  - Ranges: 40–60 cm; 60–100 cm plus railing kit; 80–140 cm plus railing kit [S] ([Eurotruss](https://www.eurotruss.com/product/stairs-adjustable-2/)).
  - Load and weight: n/f.
- **Alustage SMA aluminium modular stairs:**
  - **88.15 kg**, 8 height variants, adjustable feet [S] ([Alustage](https://alustage.eu/product/sma-aluminium-modular-stairs/)).
  - The shop field "max load 60 kg" is implausible and probably a web template error [U].
  - SPS-03/5 adjustable: 800–1400 mm, 37.46 kg [S].
- **BÜTEC aluminium stairs:**
  - Rise 200, going 300, width 1000 mm; 1–9 steps built from single step elements [S] ([BÜTEC](https://www.buetec.com/en/products/stage-podiums/podium-accessories/stairs/aluminum-staircase.html)).
  - Separate steel handrails, including a "grandstand special handrail" [S].
  - Load and standards: n/f.
- **AdjustaStairs 1200 double width (SafeSmart / Proscaf):**
  - Aluminium, self-levelling treads, folds flat [S] ([Allfasteners](https://www.allfasteners.com.au/1200mm-double-width-adjustastairs)).
  - Load-tested to **500 kg SWL**, which is a point/total rating, not per m² [S].
  - Height 1.9–4.0 m; handrail and midrail standard [S].
  - The 600 mm version claims AS 1657:2018 [S].
- **Alto Universal Stair (UK):**
  - All-aluminium and pre-assembled: you unfold it, clamp it to scaffold tube and lock it [S].
  - Claims EN 12811 in all permissible configurations [S] ([Alto](https://altoaccess.com/pages/alto-universal-stair)).
  - Lift ranges, e.g. 9 treads: 1.48–2.10 m [S].
  - This is a trade-access stair, not a crowd stair.
- **Stageco:** offers access bridges and staircases, but no public specs were found (n/f).

---

## 2. Comparison table

| System | Material | Width | Rise/going (angle) | Rated load | Barrier rating | Standards claimed | Weight | Adjust / fold | Price |
|---|---|---|---|---|---|---|---|---|---|
| **Owner unit** | Al (EN 1999) | 1.2 m (≥1.10 clear) | 175/250 (35°) | 7.5 kN/m² + 4 kN point | 3.0 kN/m (5.0 viewing) | EN 13374/13200/12811/1999 design basis; no type test yet | 88–98 kg / 6 steps | Screw jacks or hook-on; folds; nests side by side | – |
| Layher 750 | Steel stringer + Al/steel decks | 1.29–2.07 m | 166/310–315 (~28°) [S] | 7.5 kN/m² @2.07 [S] | n/f | Part K/B (UK dist.) [S] | Stringer 36.4 kg ea + rails 24–36 kg [S] | Base jacks; component-built | €509/stringer [S] |
| PERI UP Public | Steel (UP Flex) | 1.5/2.0/2.5 m [S] | n/f | 7.5 kN/m² [S] | "impact loads" met; value n/f | Building code (DE) [S] | n/f | Integrated height adj. [S] | n/f |
| HAKI PAS | Galv. steel; Al planks | 1.25/1.655/1.964 m [S] | 167/280 (31°) [S] | 7.5 kN/m² [S] | n/f | BS 5973 [S] | n/f | Lifts 0.5/1.0/1.5 m | n/f |
| LITEC Foldable Stair-Deck | Aluminium | ~1.04 m deck [S; clear width U] | Variable (self-angling) | n/f | n/f | n/f | 98.5 kg / 7 steps; 80 kg smaller [S] | Folds, spring-assisted, self-adjusting | n/f |
| Nivtec stair | Al + 12 mm ply | 1.5 m recommended [S] | n/f | 7.5 kN/m² [S] | 100 kg/m ≈ 1.0 kN/m [S] | TÜV EN 13814; DTI [S] | n/f | Legs to 1.8 m [S] | n/f |
| Prolyte SM-STAIR-500 | Al | n/f | n/f | 500 kg/m² ≈ 4.9 kN/m² [S] | n/f | n/f | n/f (modular unit 8.23 kg) | 6-step base + add-ons | n/f |
| Alustage SMA | Al + ply | n/f | n/f | "60 kg" (doubtful) [U] | n/f | n/f | 88.15 kg [S] | 8 heights, adj. feet | n/f |
| Eurotruss adj. | Steel + ply | n/f | Self-angled | n/f | n/f | n/f | n/f | 40–140 cm ranges [S] | n/f |
| AdjustaStairs 1200 | Al | 1.2 m [S] | Self-levelling | 500 kg SWL [S] | n/f | AS 1657 (600 version) [S] | n/f | 1.9–4.0 m, folds flat [S] | n/f |

### Observations
- **Load rating:** the owner's 7.5 kN/m² matches the public-access leaders (Layher 750, PERI Public, HAKI PAS, Nivtec). Typical stage stairs (Prolyte about 4.9 kN/m², Alustage and Eurotruss unpublished) are below it.
- **Barrier rating:** the owner's 3.0 kN/m target is far above what the stage-stair makers publish; Nivtec gives about 1.0 kN/m. None of the scaffold makers' barrier kN/m figures could be captured.
- **Stair pitch:** the owner's **35° (175/250) is steeper** than every public-access system found: HAKI 31° at 167/280, Layher 750 about 28° at 166/310. The 2R+G check gives 600 mm, which is within the usual 590–650 comfort window [U: own arithmetic]. Even so, the 250 mm going is at the short end for crowd stairs and is the most likely point a reviewer would challenge. Check the national or venue rules that apply (e.g. Part K public stair, DIN 18065).
- **Weight:** the owner's 88–98 kg is the same class as LITEC (98.5 kg for 7 steps) and Alustage SMA (88.15 kg). This suggests the target is realistic for a folding aluminium unit. It is heavy for two-person handling, though; both benchmarks are the same.
- **Certification:** only Nivtec (TÜV to EN 13814) publicly claims a type test among the event-stair products found. The scaffold systems rely on national approvals and building-code conformity. No EN 1090-3 claims were found (n/f).

---

## 3. Ideas worth borrowing

1. **Gravity pre-lock plus a positive secondary lock** (PERI gravity lock, Layher AutoLock). A pin or wedge drops home under its own weight on assembly, so a hooked connection holds before the crew taps it tight. Apply this to the hook-on landing connection and to the barrier post sockets.
2. **Tamper-proof, child-proof locks on barrier parts** (HAKI PAS). Use a lock that the public cannot release by hand and that needs a tool or a two-motion action. It is worth adding where posts or infill panels are removable.
3. **Drop-over barrier posts on fixed bolts or spigots** (Nivtec: the "railing pulls down over the railing bolts"). This gives fast, solid, gravity-seated posts with no loose pins. Add a captive snap pin against uplift.
4. **Separate child-safe infill as an add-on panel** (Layher T12 "mit Kindersicherung", HAKI's 100 mm sphere rule). Keep the base barrier frame and add clip-in mesh or vertical-bar panels for public or viewing use. Also meet the **100 mm sphere rule between treads (open risers)**, not only in the rails.
5. **Handrail kit with very few parts** (Layher's holder + joint + tube). Standardising one holder that fits any post reduces loose parts and errors.
6. **Spring-assisted folding** (LITEC). A gas strut or torsion spring counterbalances the flight during unfolding. This matters at about 95 kg and reduces pinch and drop hazards.
7. **Self-adjusting pitch / self-levelling treads** (LITEC, Eurotruss, AdjustaStairs). Parallelogram treads keep steps level across a height range. This could widen the unit's usable height band beyond what screw jacks alone give. Note the trade-off: the rise/going and the rating must hold across the whole range.
8. **Drained anti-slip aluminium treads** (LITEC drainage holes; HAKI chequer plate). Specify slip resistance (e.g. an R-class or pendulum value) and drainage in the design basis.

Further points to consider:
- Aim for an **EN 13814 / TÜV type test**, as Nivtec has. It is the recognised route for event structures.
- Publish a **single-sheet rating table** (kN/m², point load, barrier kN/m, height range), as the scaffold makers do.

---

## 4. Open gaps (verify before relying on them)
- Barrier kN/m ratings for Layher, PERI and HAKI (in their user manuals, which could not be fetched).
- PERI Public rise/going.
- LITEC load rating and standards.
- Layher 750 base-jack range and approval number.
- The Layher T12 bar spacing.
- Any EN 1090-3 execution-class claims.
- Rental prices: the only public figure found was UK alloy stair-tower hire at £71.50–£115.50 excl. VAT ([Lakeside Hire](https://www.lakeside-hire.co.uk/scaffold/alloy-stair-scaffold-tower/)). That is a different product class and is not comparable.
