calo-lategan/Staircase/(commit log)

2026-09-26 Add v2 folder
    [Acetal_bush_20-16.2.step, Ball-lock_pin_Ø12_(secondary).step, Ballast-anchor_lug.step, Base_pivot_bracket.step, Bolt_M12x110_8.8_HDG_+_nut.step, Bolt_M8x25_csk_A4.step, Bolt_M8x25_csk_A4_(pair_ends).step, Bridge_bearing_pad.step]
2026-09-26 Rev C: load verdict, manufacturing guide, frame re-run, pole fixing check
    Adds the Rev C load verdict and manufacturing guide (two build routes),
    re-runs the side frame with the 70-deep rails, checks the pole-to-rail
    fixing (strap at the upper rail, pin at the lower), and updates the
    change list and datasheet to match.
    Claude-Session: https://claude.ai/code/session_01MtDNr8kfgisrSsX83Eq6Js
2026-09-26 Rev C: add snap-in socket and spring pin checks for the poles
    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
2026-09-26 Rev C: add steps, pins and rails review
    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
2026-09-26 Re-save the final model (FINAL_standard.blend) as IFC
    FINAL_standard.ifc is the 25 Sep IFC with the 33 elements removed in the
    owner's 26 Sep clean-up (second base, doubled axle tubes, extra pole
    blocks, helper box and planes). No part was moved or reshaped, so every
    kept element keeps its original IFC entity, material and GlobalId.
    Checked: 652 products = 632 blend objects + 20 zero-thickness faces
    that can't be meshed.
    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
2026-09-26 Rev C: agent work in progress (rails, steps, mass budget)
    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
2026-09-26 Rev C: agent work in progress (rails, steps)
    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
2026-09-27 Rev C: add open-channel rail design (nesting, fold-flat, pin and pole slots)
    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
2026-09-27 Rev C: add final supports design (forked jacks, hook over axle, ties)
    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
